Ejenie/Cheburashka/Cheburashka_construction/face/лицо/картинки/основа.png

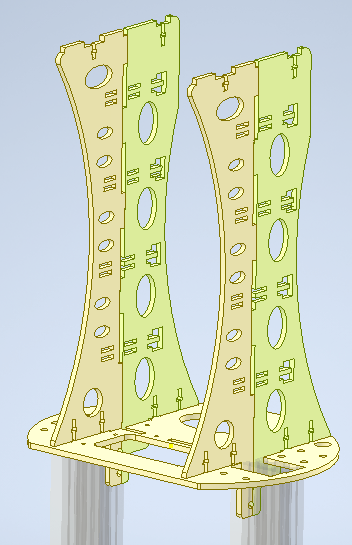
Cheburashka_construction/face/лицо/картинки/основа.png
