Ejenie/Cheburashka/README.md

# Cheburashka
## Developed by Evgeniia Baranova
