Ejenie/Cheburashka/Cheburashka_docx/Баранова_Евгения_Михайловна_Робот_Чебурашка.pdf

Правительство Санкт-Петербурга Комитет по образованию

Государственное бюджетное образовательное учреждение

«Президентский физико-математический лицей №239»

ВСЕРОССИЙСКАЯ ОЛИМПИАДА ШКОЛЬНИКОВ

Труд (технология). Профиль “Робототехника”

ПРОЕКТ

РОБОТ ЧЕБУРАШКА

Выполнила:

Баранова Евгения,

учащаяся 9 м класса, ГБОУ лицей №533,

ОДОД ГБНОУ “Президентский ФМЛ №239”

Руководитель:

Мерзлякова Юлия Игоревна,

педагог дополнительного образования

ГБНОУ “Президентский ФМЛ №239”

Санкт-Петербург, 2025

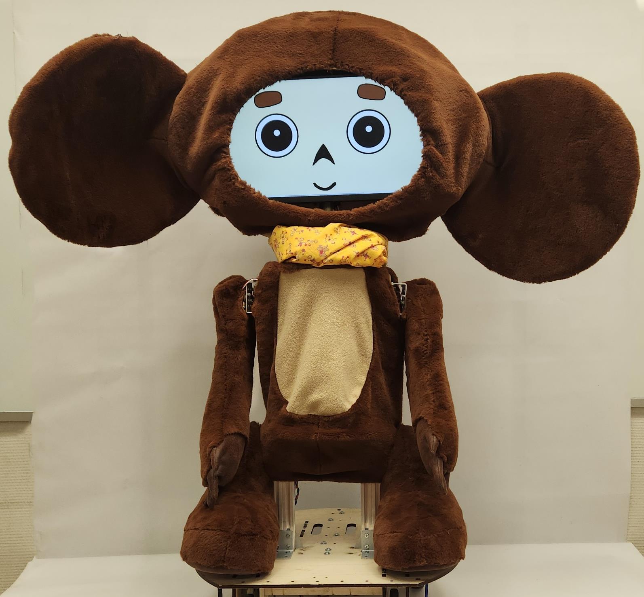
[picture p3: figure]

2

Рисунок 1 - Робот Чебурашка

3

СОДЕРЖАНИЕ

### ПРИЛОЖЕНИЕ А. КОНСТРУКТОРСКАЯ ДОКУМЕНТАЦИЯ НА

### 1 ПОИСКОВО-ИССЛЕДОВАТЕЛЬСКИЙ ЭТАП

### 1.1 Обоснование актуальности темы роботов-актеров

Роботы становятся неотъемлемыми инструментами улучшения качества жизни лю-

дей. Активно развивается и такое направление, как социальная робототехника [1]. Соци-

альные роботы способны взаимодействовать с человеком, они делятся на роботов-

ассистентов, компаньонов, актеров и др. [2].

Роботы-актеры являются актуальным и инновационным решением в мире совре-

менных развлечений. Робот, дополняющий своей ролью выступление людей-актеров, вы-

зывает интерес к постановке и привлекает внимание своей необычностью. Применение

таких технологий позволяет расширить границы искусства и показать новаторский подход

автора.

Темой роботов для сцены я занимаюсь уже третий год, и в этот раз мне стало инте-

ресно воплотить образ персонажа повести Эдуарда Успенского - Чебурашку.

Для различных развлекательных мероприятий и съемок фильмов применяются ро-

боты-аниматроники, имитирующие движения животных, персонажей литературных и

анимационных произведений [3]. Показать образ животного или фантазийного персонажа

для человека является сложной задачей, поэтому наличие роботов-актеров, выполненных

в виде сказочных героев, помогает режиссерам и постановщикам лучше показать произве-

дение на сцене и передать суть постановки.

Узнаваемый образ робота привлекает внимание зрителей разных возрастов. Это да-

ет возможность использования робота не только на сцене, но и на различных выставках,

праздниках и других развлекательных мероприятиях, что помогает решать актуальную

задачу популяризации робототехники и инженерно-технического творчества среди моло-

дежи.

Исходя из анализа развития темы роботов-актеров и роботов-аниматроников, был

сделан вывод об актуальности данной темы в современной России.

### 1.2 Цель и задачи проекта

Цель проекта стало создание робота-актера, в виде Чебурашки, который будет спосо-

бен развлекать людей, выступая на сцене. Для выполнения поставленной цели потребова-

лось выполнить следующие задачи:

1) провести предпроектное исследование: изучить аналоги роботов-актеров, аниматроников,

изучить реализации мимики человека;

2) выбрать образ, разработать концепцию, составить структурную схему робота;
3) сформулировать техническое задание для робота Чебурашки;

4) разработать все детали и сборную 3D-модель робота;
5) подобрать электронику;
6) изготовить платформу, тело и голову робота, собрать Чебурашку;
7) провести монтаж готовых электронных компонентов и изготовить самостоятельно спроек-

тированную плату;

8) разработать программное обеспечение;
9) провести тестирование робота и внести необходимые модификации.

### 1.3 Cбор и анализ информации по теме образа Чебурашки

Чебурашка – один из героев повести Эдуарда Успенского «Крокодил Гена и его

друзья», написанной в 1966 году [4]. В 1969 году вышла первая экранизация по мотивам

повести, после этого персонаж стал известен в СССР. Стали выпускаться игрушки (рису-

нок 2), значки и многое другое. Чебурашка был символом Олимпийской сборной на играх

2004, 2008, 2010 годов, а 7 июля 2016 года в честь 80-летия студии Союзмультфильм,

Чебурашка совершил полет в космос на МКС (рисунок 3) [5].

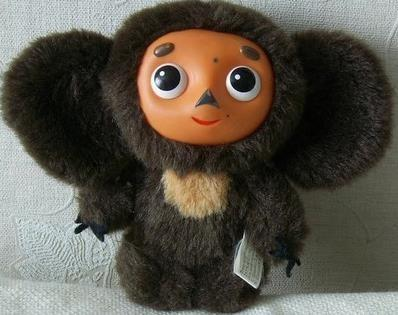
[picture p4: figure]
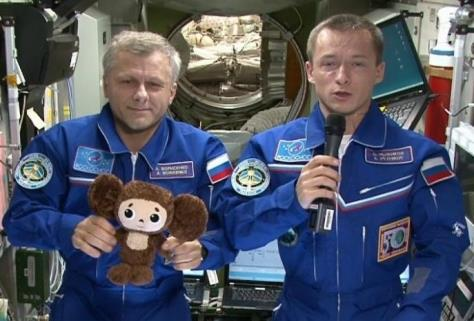
[picture p5: figure]

Рисунок 2 - Игрушка СССР | Рисунок 3 - Чебурашка на МКС

1 января 2023 года был выпущен комедийный фильм «Чебурашка», став самым кас-

совым в истории российского кинопроката, и образ Чебурашки вновь стал популярен и

является таковым до сих пор [9].

Разработка робота в виде Чебурашки является интересным опытом. Стало необхо-

димо найти способ воплотить характерные черты персонажа с помощью робототехниче-

ских технологий. Чебурашка — это персонаж, который уже давно завоевал сердца росси-

ян. Он знаком и близок людям всех возрастов, от самых маленьких до пожилых. Его образ

ассоциируется с добротой, дружбой, он вызывает доверие у взрослых и нравится детям.

В первую очередь были проанализированы мультфильмы и анимации посвященные

Чебурашке и его друзьям.

1) «Крокодил Гена», 1969, режиссер Роман Качанов [6]

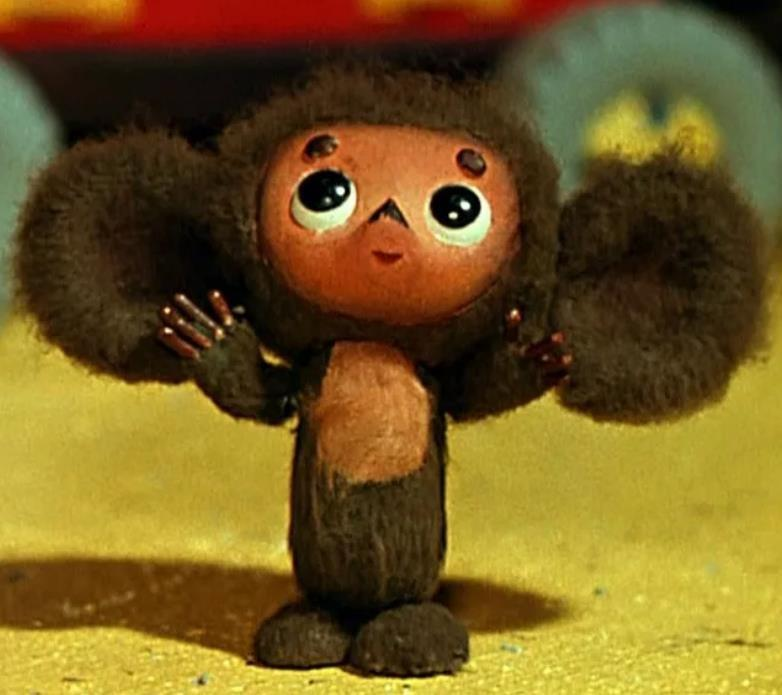
[picture p6: figure]
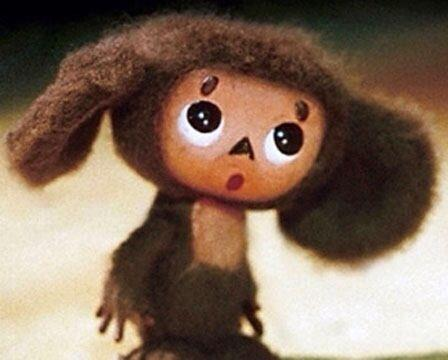
[picture p7: figure]

Рисунок 4 - Лицо Чебурашки, удивление | Рисунок 5 - Поза Чебурашки, движение
| рук

Анализ:

Форма тела (рисунок 4) продолговатое, с длинными руками, а вместо ног – только

ступни, которыми Чебурашка двигает как будто отдельно от тела. Видны движения глаз и

рук, наклон ушей и поворот головы. Мимика кукольная (рисунок 5), эмоции выражаются

за счет изменения формы рта и наклона бровей.

2) «Чебурашка», 2013, режиссер Макото Накамура [7]

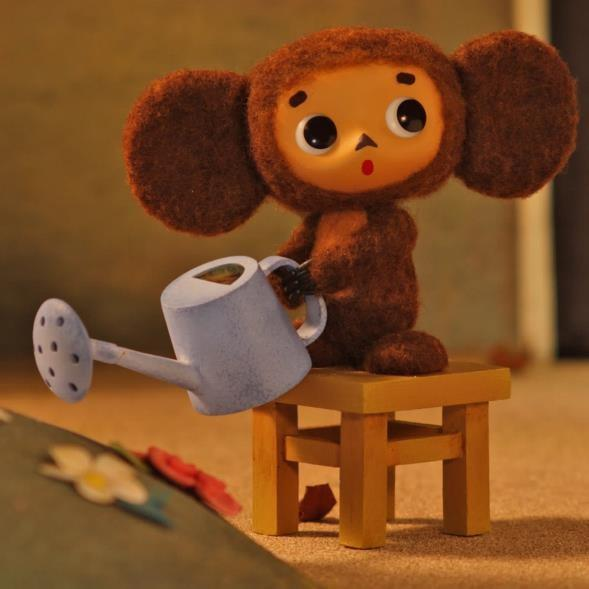
[picture p8: figure]

Рисунок 6 - Лицо Чебурашки, заинте-

ресованность

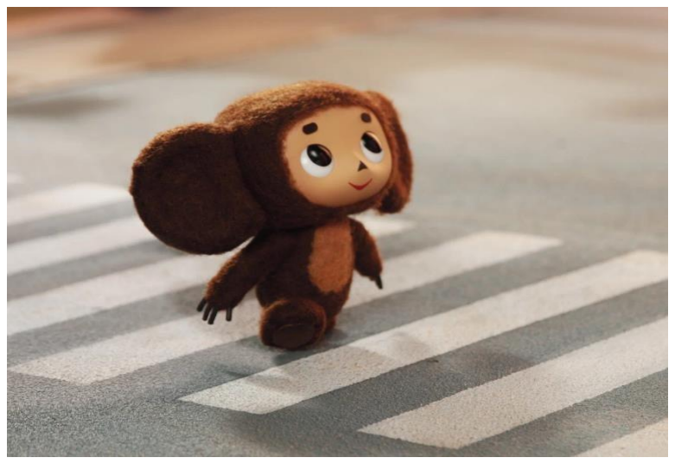
[picture p9: figure]

Рисунок 7 - Поза Чебурашки, движение ступней

Анализ:

Форма тела (рисунок 7) Чебурашки похожа на ту, что была в Советской версии мульт-

фильма. Видны движения стоп, лап в двух плоскостях. Мимика лица (рисунок 6) более ку-

кольная, не человечная, эмоции также выражаются изменением формы рта, движениями

бровей и глаз.

3) «Чебурашка», 2022, режиссер Дмитрий Дьяченко [8]

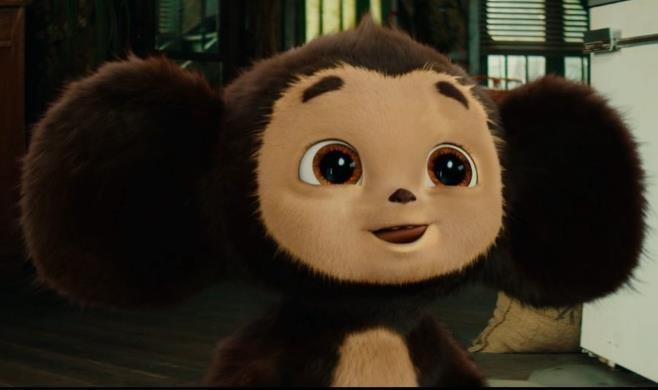
[picture p10: figure]
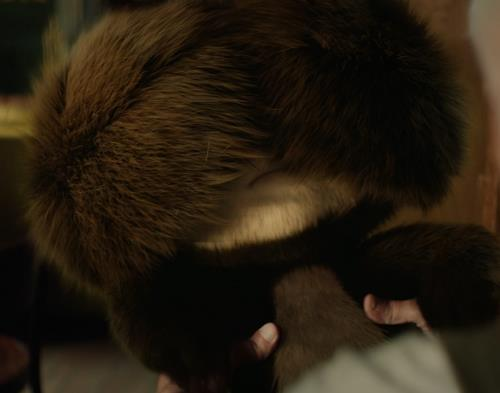
[picture p11: figure]

Рисунок 8 - Лицо Чебурашки, радость | Рисунок 9 - Поза Чебурашки. Лицо, за-
| крытое ушами

Анализ:

Пропорции тела (рисунок 8) более биоморфные: длинные нижние лапы, являющие-

ся продолжением тела, менее вытянутое туловище. Более реалистичная, практически че-

ловеческая мимика (рисунок 9), больше плоскостей движения тела, в том числе ушей: Че-

бурашка закрывает ими лицо при испуге.

По итогам анализа основных мультипликаций по повести «Крокодил Гена и его

друзья» было принято решение о реализации образа Чебурашки из более кукольного

мультфильма.

### 1.4 Аналоги

В процессе предпроектного исследования было рассмотрено несколько групп анало-

гов. Первая группа (таблица 1): аниматроники и роботы-животные, использующиеся при

съемках фильмов в качестве спецэффектов для дополнения сцен или в различных поста-

новках.

Таблица 1 - Примеры роботов аниматроников и актеров-животных

Робот | Анализ

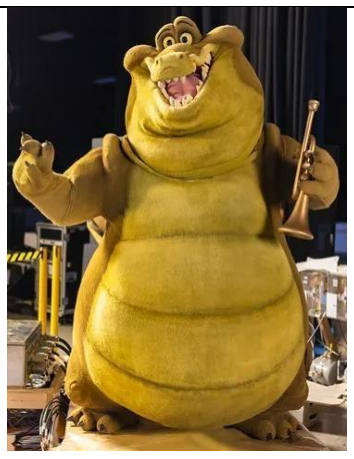
[picture p12: figure]

Рисунок 10 - Аллигатор Луи[10] | Аллигатор Луи (рисунок 10) – современная модель аниматроников, выполненных в ви-де сказочных персонажей. Этот аниматро-ник может очень многое: поворачивать гла-зами, моргать, имеет несколько степеней подвижности рук, шевелит челюстями, но при этом костюм, закрепленный поверх ос-новной конструкции, имеет свою подвиж-ность и не мешает движениям

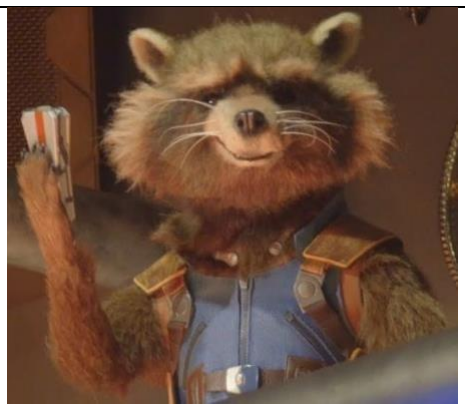
[picture p13: figure]

Рисунок 11 - Енот Ракета[16] | Аниматроник (рисунок 11) может повора-чивать голову, имитировать речь движени-ями челюсти и шевелить руками. Но ани-матроник не перемещается в пространстве, имеет статичное положение в локации комнаты

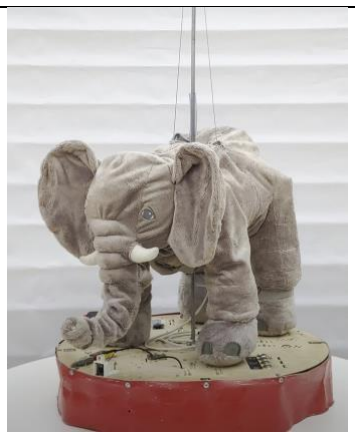
[picture p14: figure]

Рисунок 12 - Робот Слон[19] | Робот Слон (рисунок 12) умеет выполнять различные трюки, реагируя на голос чело-века и специальные метки. Каждая лапа имеет три степени подвижности, уши ше-велятся, робот целиком поднимается на подъемном механизме. Основа служит omni-платформа, позволяющая роботу пе-редвигаться в любую сторону

Вывод:

Большинство аниматроников не может перемещаться в пространстве, но имеет большой

диапазон движений различных частей тела, имитирующих движения из мультфильмов и

фильмов. Для Чебурашки, как для робота актера, необходимо перемещение по сцене, а

также повторение различных узнаваемых движений из мультипликаций

Вторая группа (таблица 2): антропоморфные роботы-актеры, артисты и промоутеры.

В свою очередь при анализе они были разделены на тех, что передают эмоции живой мими-

кой, и на тех, кто использует светодиоды и более механическую мимику.

Таблица 2 - Мимика роботов

Робот | Анализ

Более человеческая мимика

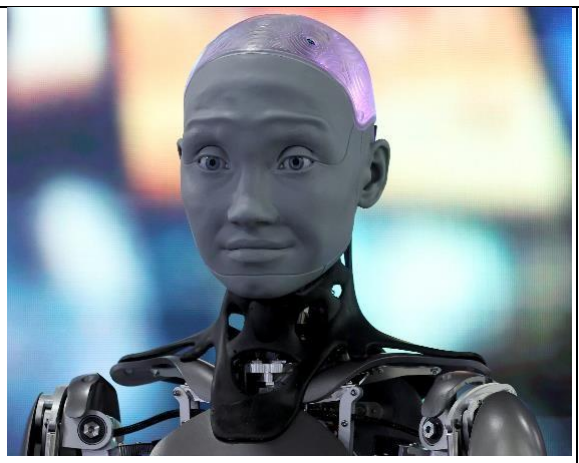
[picture p15: figure]

Рисунок 13 - Ameca [17] | Голова робота (рисунок 13) выполнена из силикона, мимика лица максимально точно повторяет человеческую, имитируя большое количество эмоций. Моторы внутри лица движениями повторяют сокращения мышц человека, реализованы движения и поворот глаз

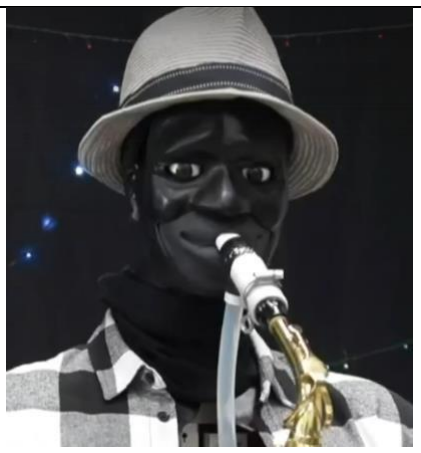
[picture p16: figure]

Рисунок 14 - Robby Brown [20] | Только передняя часть головы (рисунок 14), мимика лица передается небольшим количе-ством серво моторов, глаза могут только по-ворачиваться

Вывод:

Реализация мимики с помощью силиконовой основы позволяет добиться высокой реа-

листичности и схожести с лицом человека, но для лица Чебурашки, у которого диапазон

эмоций не такой обширный, как у человека, такая реализация будет излишней

Более механическая и не натуральная мимика

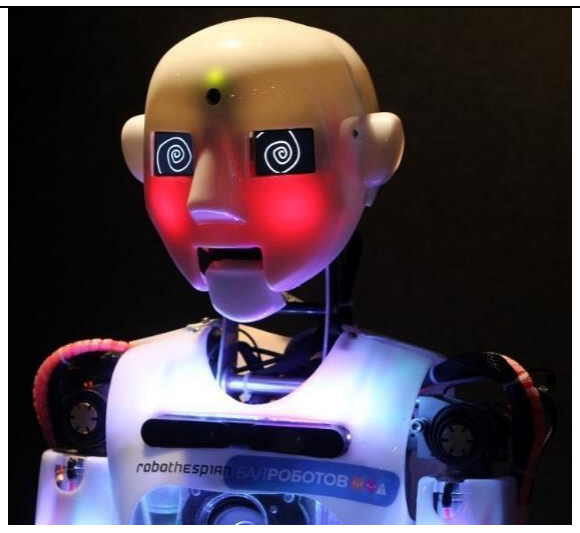
[picture p17: figure]

Рисунок 15 - Теспиан [11] | Робот Теспиан (рисунок 15) может выра-жать эмоции с помощью открытий/закрытий рта, подсветки щек, а на дисплеях, установ-ленных вместо глаз, может выводиться лю-бая картинка. Это позволяет отыгрывать эмоции менее натурально, но более нагляд-но

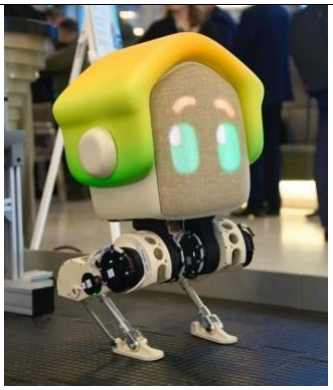
[picture p18: figure]

Рисунок 16 - Топа [18] | Лицо робота Топы (рисунок 16) выполнено в виде дисплея с натянутой поверх него тканью. На экран выводится изображение минималистичной анимированной мордоч-ки

Вывод:

Светодиоды и дисплеи позволяют роботу выражать эмоции ярче и разнообразнее, что

больше подходит для создания мимики робота, выполненного не в виде человека,

например для имитации эмоций книжного персонажа Чебурашки

В предыдущем проекте были разработаны два робота, ставших прототипами для

нынешнего проекта. Роботы Валя и Саша (рисунок 17) могут перемещаться в простран-

стве, воспроизводить заранее записанные звуковые файлы и выражать эмоции. Рот и щеки

реализованы с помощью светодиодных матриц, а глаза и брови механические.

Для взаимодействия с внешней средой у роботов предусмотрена только одна камера (ри-

сунок 18) , из-за чего возникали сложности с навигацией и позиционированием на сцене.

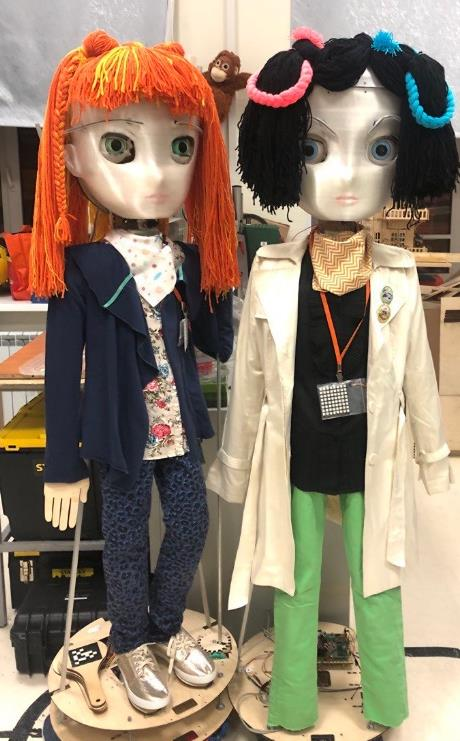
[picture p19: figure]

Рисунок 17 - Роботы Саша и Валя

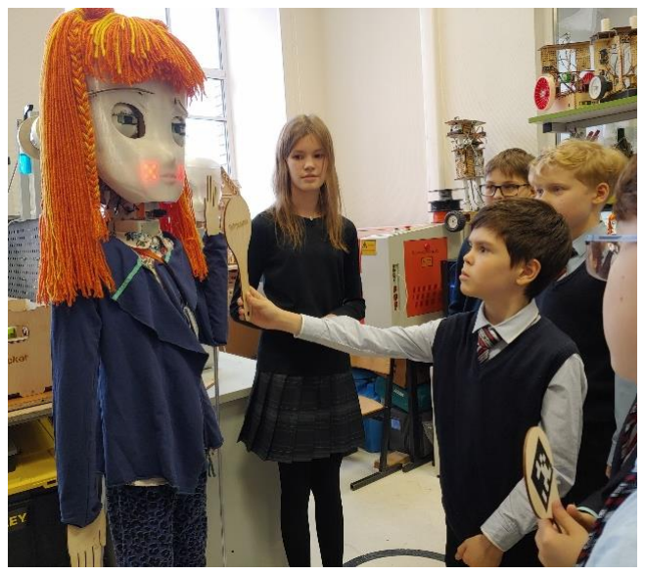
[picture p20: figure]

Рисунок 18 - Взаимодействие с окру-

жающими

По окончанию работы над прототипами было выявлено, что тема роботов-актеров

является интересной, позволяет проявить фантазию и творчество побуждает создавать но-

вых персонажей и реализовать их, используя разнообразные механизмы и электронику, для

увеличения возможности реагирования роботов на окружающую среду.

### 1.5 Концепция робота Чебурашки

На основе анализа аналогов и прототипов была разработана концепция робота Че-

бурашки.

Робот Чебурашка поход на популярную советскую игрушку, но большого размера

для того, чтобы робота-актера было хорошо видно со сцены. Это мягкая игрушка с узна-

ваемыми большими ушами, внутри которой помещены механизмы и электроника. Робот

шевелит руками, ушами и головой, изображая движения из мультфильмов. В руках нахо-

дятся магниты, позволяющие взаимодействовать с предметами на сцене. Игрушка закреп-

лена на мобильной платформе для перемещения по сцене. Шагание имитируется шевеле-

нием лап-ступней, как в известном мультфильме. Мордочка персонажа и его мимика

изображается на встроенном в голову мониторе.

Был разработан эскиз робота, на котором отмечены все ключевые решения и меха-

низмы (рисунок 19). В данном исследовании под эскизом подразумевается - предвари-

тельный, рисунок, набросок концепции будущего устройства [28].

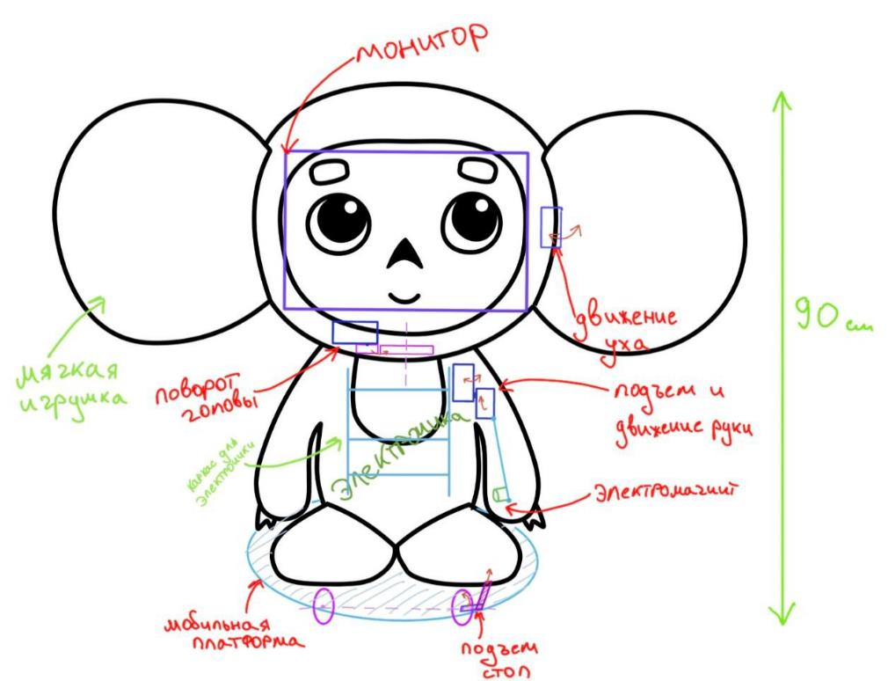
[picture p21: figure]

Рисунок 19 - Эскиз робота

По ГОСТ Р 60 робот - программируемый исполнительный механизм, обладающий

определенным уровнем автономности и предназначенный для выполнения перемещения,

манипулирования или позиционирования. Робот Чебурашка подходит под это определе-

ние, потому что содержит механизмы лап, ушей, шеи и мобильной платформы, управляе-

мые запрограммированным контроллером. Благодаря программному обеспечению робот

способен автономно перемещаться в пространстве, двигать частями тела Чебурашки и ре-

агировать на метки в окружающей среде с помощью системы технического зрения. А так-

же робот Чебурашка предназначен для перемещения на мобильной платформе и захваты-

вания объектов.

Для проекта была разработана структурная схема, в соответствии с ЕСКД. Схема

Э1 представлена в приложении А.

### 1.6 Технического задание

Основываясь на выводах концепции робота, было сформулировано следующее

техническое задание на робота:

1) робот должен состоять из мобильной платформы, соединительных конструкционных

профилей, внутреннего каркаса тела и лица, и мягкой игрушки Чебурашки высотой 900 мм;

2) робот должен не превышать размеры 480*480*1200 мм;
3) масса робота должна быть до 10 кг, должна позволять роботу развивать скорость до 1

м/с;

4) время автономной работы должно позволять роботу автономно выступать на сцене ми-

нимум 7 минут;

5) внутренний каркас тела и лица, а также платформа должны иметь вырезы и крепления

для всех электронных компонентов, быть изготовленными из фанеры и быть разборными;

6) профили, соединяющие платформу и каркас тела должны иметь размеры 20*40 мм и

находиться между нижними лапами игрушки, сохраняя их подвижность и крепиться к

платформе жестким Т-образным образом;

7) мобильная платформа должна иметь четыре колеса: два задних установлены на коллек-

торных моторах подходящей мощности оснащенных энкодерами, а два передних omni-

колеса должны быть ведомыми;

8) на осях передних колес должен располагаться кривошипно-шатунный механизм, подни-

мающий нижние лапы игрушки при передвижении робота;

9) каркас тела должен располагаться внутри туловища игрушки и иметь следующие меха-

низмы: руки должны иметь две степени подвижности, поворотный механизм головы робо-

та, способный поворачивать голову на 90 градусов в две стороны;

10) в теле робота должен располагаться датчик гироскоп;
11) все механизмы должны быть сделаны на основе сервоприводов с подходящим момен-

том силы;

12) в голове должен располагаться дисплей для имитации лица Чебурашки и отладки;
13) на голове должны располагаться уши, поворачивающиеся с помощью сервомоторов;
14) на платформе робота и в голове должны располагаться камеры, способные распознавать

цвета, метки и лица людей;

15) в руках робота должны располагаться электромагниты размерами не более 20*20*15

мм;

16) электромагниты должны удерживать массу до 2.5 кг;
17) робот должен уметь воспроизводить заранее записанные звуковые файлы с помощью

колонки размерами не более 130*100*50 мм;

18) громкость колонки должна быть не менее 105 децибел;
19) вся периферия робота должна управляться контроллером Arduino Mega, а обработка

изображений с камер и передача действий сценария должны управляться с одноплатного

компьютера Raspberry Pi 4 model B;

20) программное обеспечение должно состоять из двух программ: первой для одноплатного

компьютера Raspberry Pi 4, а второй для контроллера Arduino Mega, должна быть обеспече-

на связь между устройствами по протоколу UART.

### 2 КОНСТРУКТОРСКО-ТЕХНОЛОГИЧЕСКИЙЭТАП

### 2.1 Подбор материалов и проектирование конструкции робота

Проектирование производилось в САПРе Autodesk Inventor. Этот САПР был выбран

из-за продвинутой работы с мультителами и поверхностями и за счет технологий адап-

тивного моделирования.

Первый этап в разработки конструкции робота - сделать мобильную платформу. В

соответствии с технический заданием, платформа должна обладать четырьмя колесами:

двумя omni и двумя обычными. Снизу фанерной основы (рисунок 20) находятся крепле-

ния моторов Tetrix, а сверху (рисунок 21) – крепление для камеры.

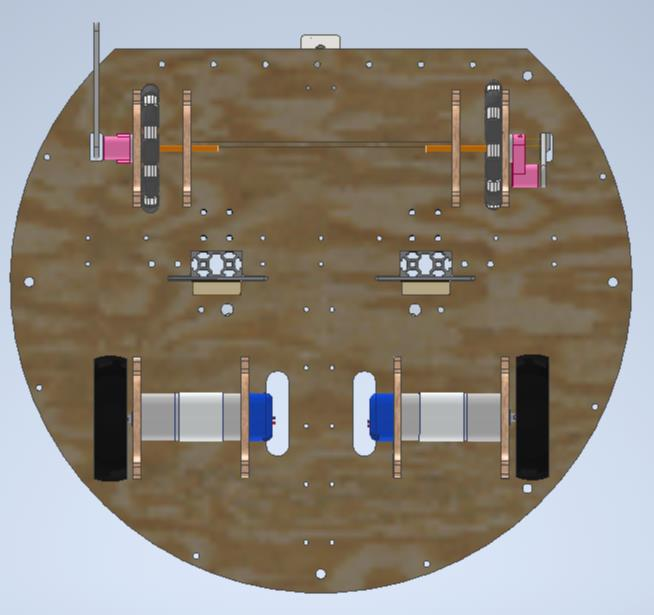
[picture p22: figure]

Рисунок 20 - Фанерное основание.

Вид снизу

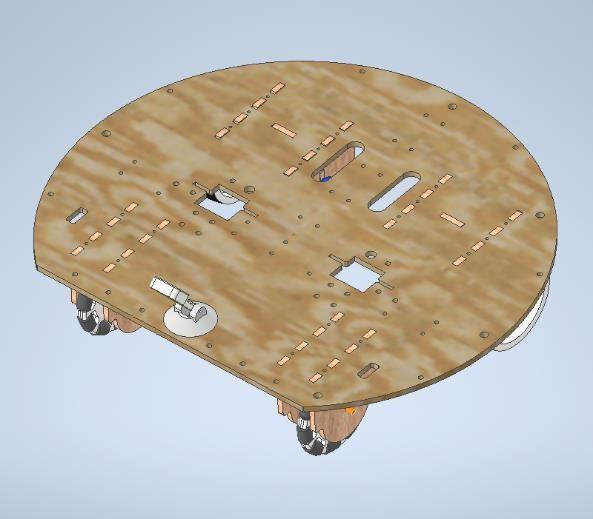
[picture p23: figure]

Рисунок 21 - Фанерное основание. Вид

сверху

Для имитации роботом движения стоп на осях omni-колес (рисунок 22) находятся

два кривошипно-шатунных механизма с наконечниками округлой формы (рисунок 23),

которые толкают стопы игрушки Чебурашки.

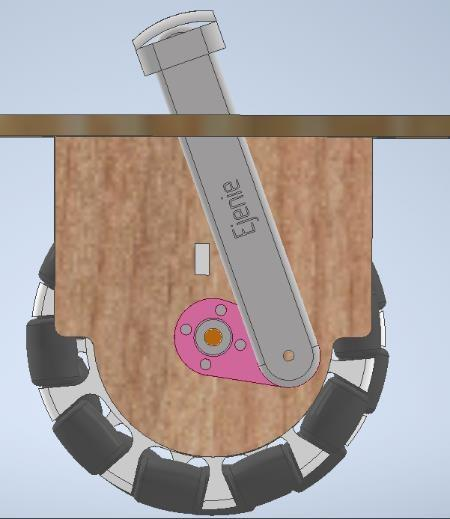
[picture p24: figure]

Рисунок 22 - Механизм стоп. Вид

сбоку

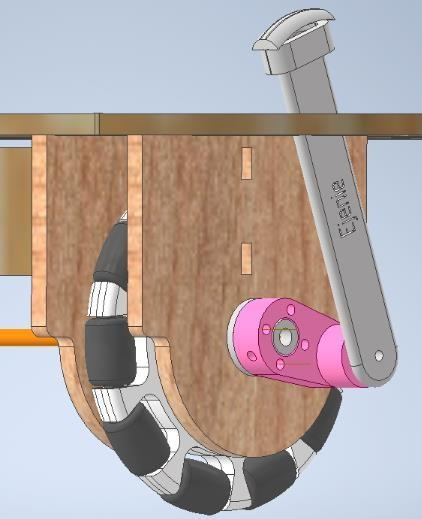
[picture p25: figure]

Рисунок 23 - Механизм стоп. Вид на

ось

Для детали, использующейся в механизме, был разработан чертеж, представленный

в приложении А.

Для соединения отдельных модулей, таких как платформа и тело, было принято

решение использовать алюминиевые конструкционные профили. Их Т-образное (рису-

нок 24) крепление на платформе обеспечивает жесткую фиксацию тела относительно

платформы робота. Профиль крепится на платформу с помощью алюминиевых уголков и

пластин (рисунок 25).

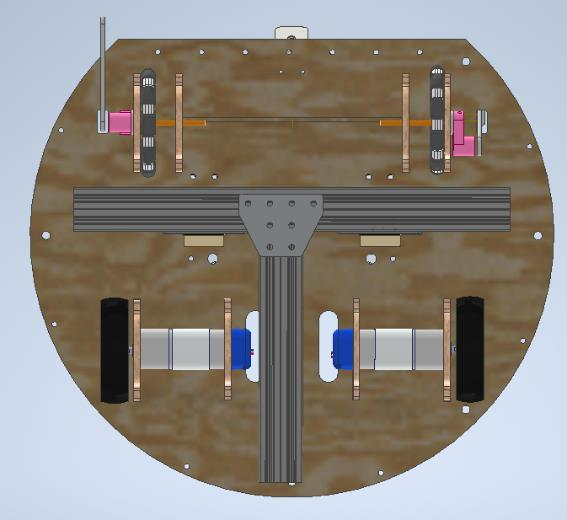
[picture p26: figure]
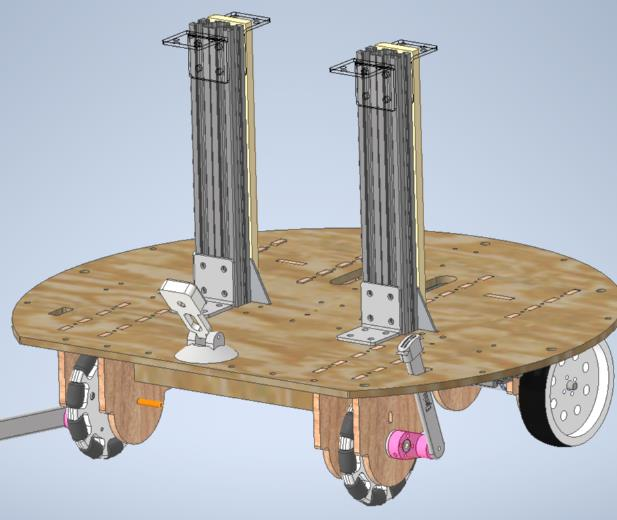
[picture p27: figure]

Рисунок 24 - Т-образное крепление | Рисунок 25 - Крепление профилей к плат-
| форме

Вся управляющая электроника крепится на каркас в теле робота. В процессе про-

ектирования робота потребовалось решить определенную проблему: расположить элек-

тронику доступно для подключения, с возможностью отсоединения для перевозок и ре-

монта. Была разработана конструкция с четырьмя опорными пластинами, скрепляющиеся

друг с другом шип-пазами (рисунок 26). Снизу пластины закреплены на усеченное круглое

основание, под которым находится крепление аккумулятора крепление к конструкцион-

ным профилям каркаса (рисунок 28). На основании сделаны прорези, для удобства заме-

ны и доступа к индикатору заряда аккумулятора.

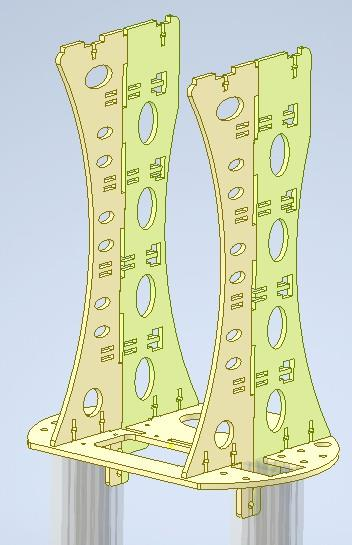
[picture p28: figure]

Рисунок 26 – Опорные пластины

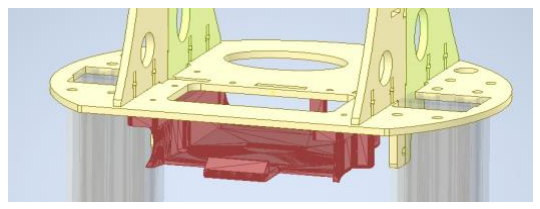
[picture p29: figure]

Рисунок 27 - Крепление аккумулятора

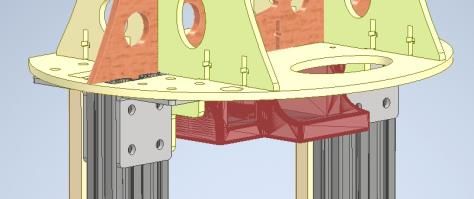
[picture p30: figure]

Рисунок 28 - Крепление к каркасу

Между парами опор, поперечно к ним, расположено скрепляющее их шип- пазами

ребро (рисунок 29), с прорезями для отсеков с компонентами, отверстиям для разъемов, а

также крепления двухосевых серво-моторов рук (рисунок 30).

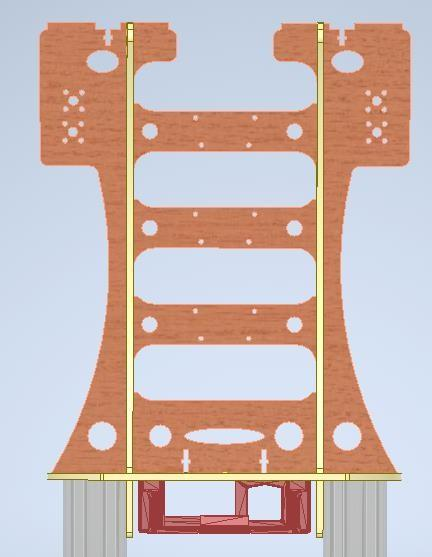
[picture p31: figure]

Рисунок 29 - Поперечное ребро с

прорезями

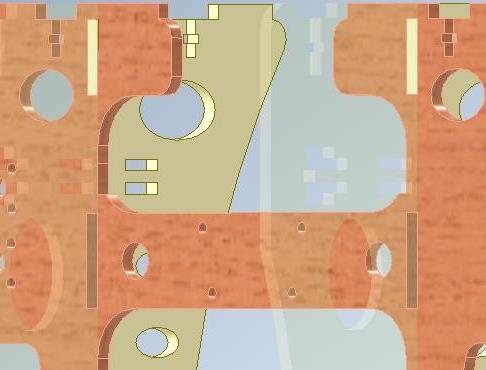
[picture p32: figure]

Рисунок 30 - Крепление опор шип- пазами

Отсеки созданы на подобие выдвигающимся полкам шкафа или стеллажа: основами

полок служат пластины (рисунок 31), способные скользить по направляющим (рису-

нок 34), прикрепленным к боковым опорам клиновым соединением. С одного конца

направляющих есть ограничители (рисунок 33), поставленные для предотвращения вы-

падения пластин. Была сделана полная сборная 3D-модель каркаса тела робота, включа-

ющая электронные компоненты необходимые для создания крепежных отверстий (рису-

нок 32).

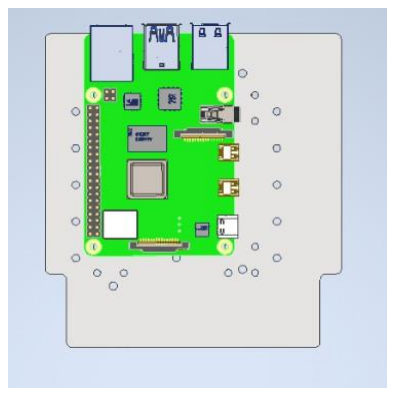
[picture p33: figure]

Рисунок 31 - Пластины для крепления

электроники

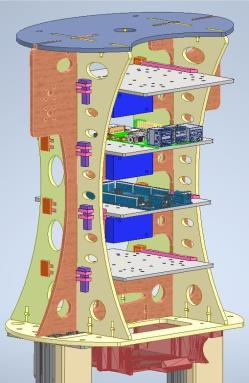
[picture p34: figure]

Рисунок 32 - Сборная 3D-модель

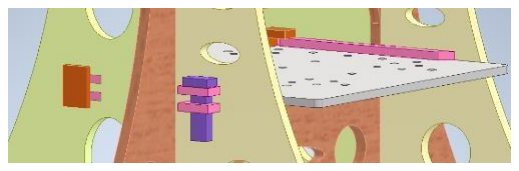
[picture p35: figure]

Рисунок 33 - Клиновое соединение и огра-

ничители

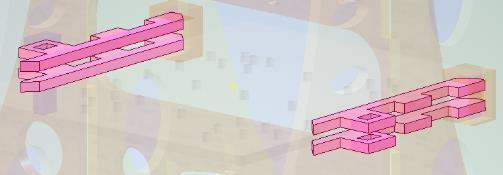
[picture p36: figure]

Рисунок 34 - Направляющие полок

Поворотный механизм головы (рисунок 35) основан на шестерне, закрепленной на

верхнем фанерном основании туловища. На шестерню крепится деталь, фиксирующая

подшипник, на котором производится вращение фанерной основы головы, осуществляемое

с помощью сервомотора в голове с закрепленной на него шестерней (рисунок 36). Для

большей устойчивости, по бокам от подшипника установлены детали, обеспечивающие до-

полнительную опору. Для скольжения основы при повороте в опорах находятся подшипни-

ки.

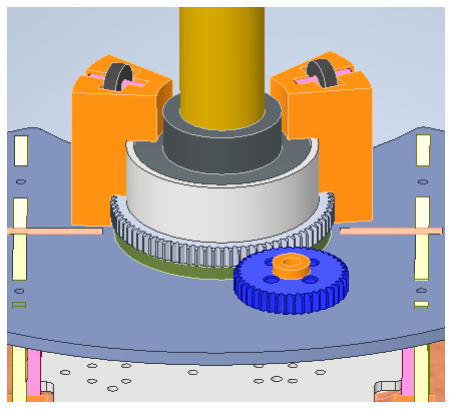
[picture p37: figure]
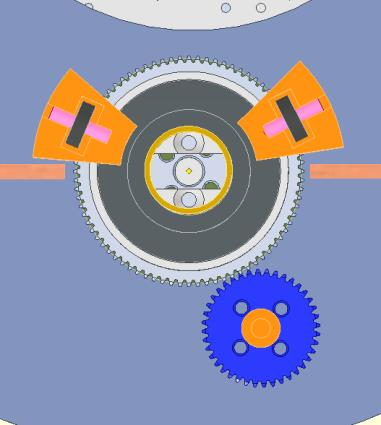
[picture p38: figure]

Рисунок 35 - Поворотный механизм | Рисунок 36 – Зацепление шестерней

Фанерное основание лица (рисунок 37) представляет собой две пластины, с отвер-

стиями под крепление трубы и сервомоторов ушей. Монитор для изображения эмоций за-

крепляется на основу на магниты, расположенные в стойках (рисунок 38).

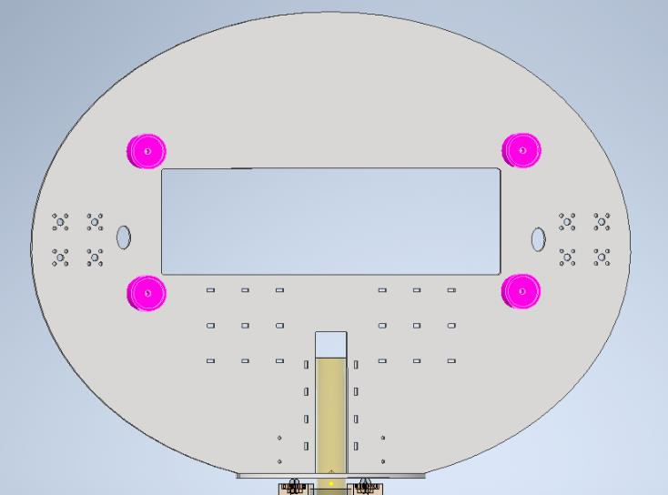
[picture p39: figure]

Рисунок 37 - Основание лица

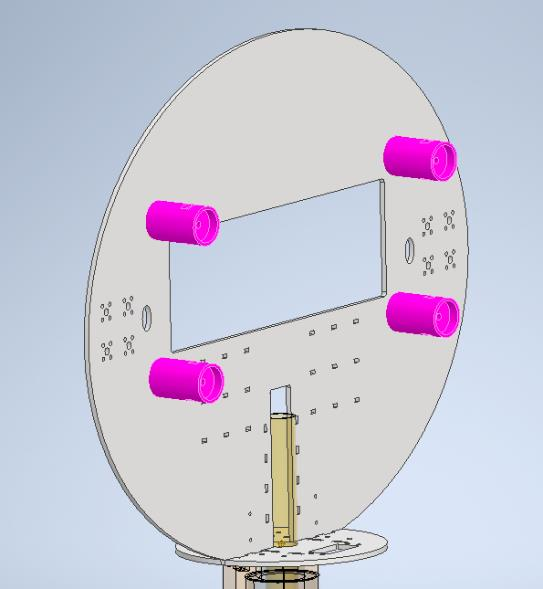
[picture p40: figure]

Рисунок 38 - Стойки с магнитами

### 2.2 Подбор электроники робота Чебурашки

В процессе подбора компонентов потребовалось рассчитать общий потребляе-

мый ток и мощность, на основе данных из технических документаций на компоненты (таб-

лица 3).

Таблица 3 - Расчет токов

| Рабочее напряжение, В | Потребляемый ток, А | Потребляемая мощность на 1 шт., Вт | Кол-во | Суммарная мощность, Вт
| Min | Max | Ном. | Max | Ном. | Max | | Ном. | Max
Arduino Mega | 5,00 | | 0,10 | 0,20 | 0,50 | 1,00 | 1,00 | 0,50 | 1,00
Raspberry Pi 4 | 5,00 | | 2,00 | 3,00 | 10,00 | 15,00 | 1,00 | 10,00 | 15,00
Motor Tetrix Max | 5,00 | 12,00 | 3,00 | 8,70 | 15,00 | 104,40 | 2,00 | 30,00 | 208,80
DS3240 | 5,00 | 6,80 | 3,10 | 3,90 | 15,50 | 26,52 | 1,00 | 15,50 | 26,52
RDS3218 | 4,80 | 6,80 | 1,00 | 2,00 | 4,80 | 13,60 | 6,00 | 28,80 | 81,60
Магниты | 14,80 | | 0,27 | | 4,00 | | 2 | 8,00
Сумма | - | - | 9,47 | 18,07 | 49,80 | 164,52 | 11,00 | 92,80 | 340,92

На основе расчета, был произведен окончательный подбор электроники, были проана-

лизированы и выбраны следующие электронные компоненты (таблица 4).

На основе расчётов потребляемых токов, время автономной работы робота было

рассчитано по формуле (1):

t =

C×U
P

(1)

Где t – время работы робота, С – емкость аккумулятора (3000 мА*ч), U – напряже-

ние питания (14,8 В) и P – потребляемая роботом мощность (92,80 для максимального вре-

мени и 340,92 для минимального времени).

tmax =

C × U
P

=

(3000 мА ∗ ч ÷ 1000 ∗ 60) × 14,8 В
92,80 Вт | ≈ 28,7 мин

tmin =

C × U
P

=

(3000 мА ∗ ч ÷ 1000 ∗ 60) × 14,8 В
340,92 Вт | ≈ 7,8 мин

Итого, минимальное время работы робота составляет 7,8 мин, а максимальное – 28,7

мин.

Таблица 4 - Обоснование выбора электронных компонентов

Название и характеристики | Обоснование выбора

Контроллеры

Arduino Mega [12]. 1 шт. Подклю-

чение периферии робота.

Для выбора контроллера был произведен расчет не-

обходимого количество портов и интерфейсов, нуж-

43 цифровых порта

14 ШИМ портов

16 портов с АЦП

4 интерфейсов UART

1 интерфейс I2C

6 внешних прерываний

ных для подключения устройств:

1. 2 интерфейса UART (для подключения по USB и

передачи данных с Raspberry)

2. 1 интерфейс I2C (для подключения гироскопа)
3. 9 ШИМ портов (для подключения сервоприводов и

драйвера)

4. 6 цифровых пинов (подключение энкодеров и

драйверов)

5. 2 пина внешних прерываний

На основе данного анализа был выбран контроллер

Arduino Mega, а также за счет поддержки среды раз-

работки Arduino IDE

Raspberry Pi 4 model B [15]. 1 шт.

Обработка информации с датчиков.

Bluetooth модуль

Возможность | подключения | не-

скольких камер одновременно

Аналоговый аудиовыход

USB порты

1. 5 портов UART
2. HDMI порт

Raspberry Pi это одноплатный компьютер, с возмож-

ностью работы с видео, звуком, обрабатывать ком-

пьютерное зрение. Есть возможность обрабатывать

несколько задач одновременно и использовать раз-

личные языки программирования. Также по этому од-

ноплатному компьютеру существует большое количе-

ство открытых обучающих материалов

Электродвигатели

Motor Tetrix Max Torque NADO [13].

2 шт.

100 об/мин

~50 кгс/см

1440 отсчетов энкодера

3 А номинальный ток

8,7 А максимальный ток

Мотор своими характеристиками подходит для со-

здания колесной базы, способной выдерживать вес

робота

Платы управления двигателями

Pololu motors driver VNH5019A [21].

1 шт.

Выходной ток 12 А на каждый ка-

Данный драйвер обеспечивает выходной ток в 12 А,

что подходит для управления моторами, используе-

мых в проекте, а также с его помощью можно

нал

Два канала управления

управлять двумя моторами сразу

Сервоприводы

DS3240 [14]. 1 шт. 40 кгс*см 40*20*40.5 мм 270 градусов | Сервоприводы имеют достаточный крутящий момент для управления поворотом головы робота
RDS3218 [22]. 6 шт. 20 кгс*см 40*20*40.5 мм 360 градусов | Сервоприводы имеют достаточный крутящий момент для управления движениями рук робота, а также наличие совместимый алюминиевый держатель

Камеры

Raspberry Pi Camera module [23]. 1 шт. | Камера выбрана из-за совместимости с микрокомпью-тером Raspberry Pi и за счет наличия готовых библио-тек обработки и управления
Web-камера [27]. 1 шт. | Выбрана за счет своего подключения по интерфейсу USB, так как к одноплатному компьютеру Raspberry Pi 4 одна возможность подключения камеры по ин-терфейсу SPI

Прочие электронные компоненты

JBL clip +[24]. 1 шт. | Колонка была выбрана засчет небольших размеров и выдаваемой громкости, соответствующей техниче-скому заданию
Портативный монитор 17.3 дюйма [25]. 1 шт. | Монитор выбран за счет подходящих к лицу Чебу-рашки размеров и за возможность подключения по интерфейсу HDMI, совместимым с Raspberry Pi 4
Электромагниты 14.8 вольт 270 мА | Магниты были выбраны засчет подходящих размеров и выдерживаемой массы
LM2596 Входное напряжение от 4 до 40 В | Данный DC-DC преобразователь обеспечивает пони-жение напряжение выдаваемого с аккумулятора 14,8

Выходное напряжение от 1,5 до 35 В Максимальный выходной ток 3 A | вольт, до напряжения питания контроллера Arduino Mega - 5 В
Регулируемый понижающий DC-DC Входное напряжение от 4,5 до 30 В Выходное напряжение от 0,8 до 28 В Максимальный выходной ток 12 А | На основе расчета токов и требуемого напряжения, потребляемых сервомоторами, был выбран данный стабилизатор.

Аккумулятор

Li-on аккумулятор КРАВТ. 1

шт.

14.8 В

3000 mAh

43 Вт*ч

Аккумулятор КРАВТ имеет защиту отполного разря-

да и перезаряда ячеек, защиту от перегрузки и корот-

кого замыкания на выходе. Имеет удобную индика-

цию показывающую степень заряда аккумулятора и

предупреждение о низком заряде, а также подходит

своей емкостью для 7 минутной автономной работы

робота, требующейся по техническому заданию

### 2.3 Проектирование печатной платы для робота

Для обеспечения питания микрокомпьютера Raspberry Pi 4 было принято решение о

создании собственного преобразователя питания на печатной плате. За основу была взята

микросхема стабилизатора питания LM2596. Были реализованы схемы защит по превыше-

нию силы тока и напряжения на выходе стабилизатора. Также на печатной плате реализо-

вана схема, позволяющая управлять напряжением электромагнитов с помощью цифрового

сигнала с Arduino Mega.

Схема Э3 платы представлена в приложении А.

В качестве САПР был выбран Altium Designer, за счет возможности создавать печат-

ные платы на основе схем по ГОСТ, механик трассировки, не позволяющих допустить пе-

ресечения дорожек, и возможности задания правил трассировки с необходимыми зазорами

между дорожками.

### 2.4 Изготовление робота

Большинство деталей робота были изготовлены методами лазерной резки из фа-

неры. Такой способ изготовления позволяет создавать легкие сборные каркасы, быстро и

точно корректировать несовершенства модели.

Часть спроектированных деталей была напечатана на 3D принтере, с использова-

нием пластиков PLA и ABS. Такие виды пластиков были выбраны засчет своей легкости,

прочности и доступности в рамках школьного проекта.

Основание робота и крепления моторов (рисунок 39) были вырезаны из фанеры 6

мм на лазерном станке. Для обеспечения быстрой сборки робота, провода питания мото-

ров и связи энкодеров являются разъединяемыми и, с одной стороны, припаяны к разъ-

ему кабель-канала (рисунок 40).

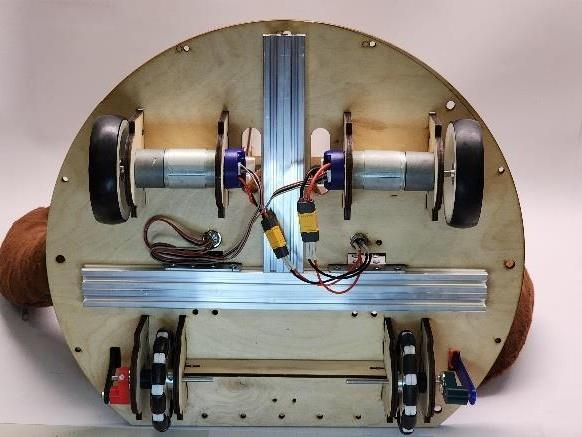
[picture p41: figure]
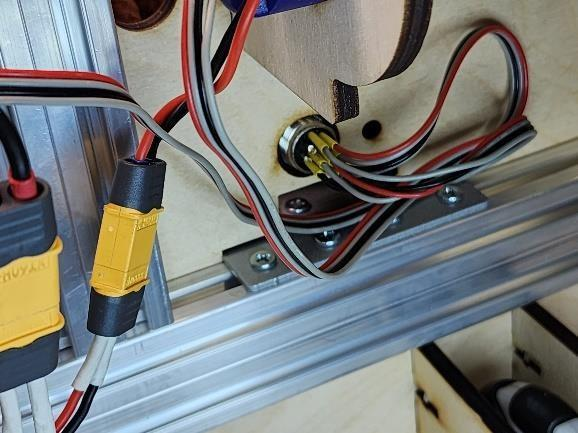
[picture p42: figure]

Рисунок 39 - Основание робота | Рисунок 40 - Разъем кабель- канала

Детали для механизма стоп (рисунок 41), клиновые соединения, ограничители по-

лок (рисунок 42) были напечатаны на 3D принтере из пластика PLA.

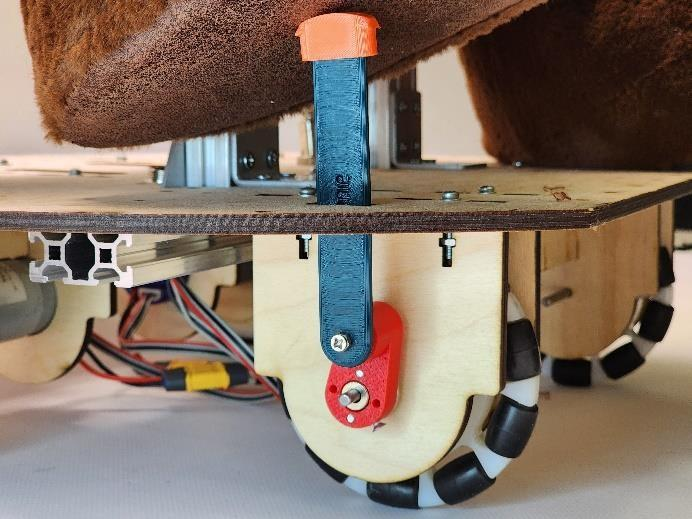
[picture p43: figure]
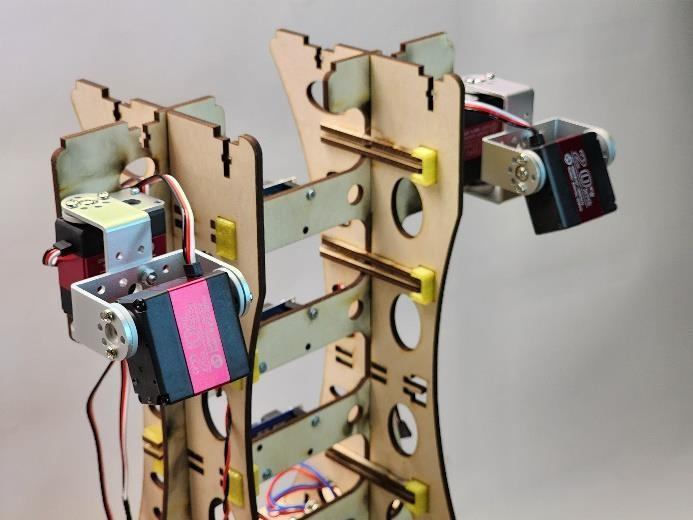
[picture p44: figure]

Рисунок 41 - Механизм стоп | Рисунок 42 - Каркас тела робота

Сборка конструкции (рисунок 43) и монтаж электронных компонентов (рисунок

44) производился вручную.

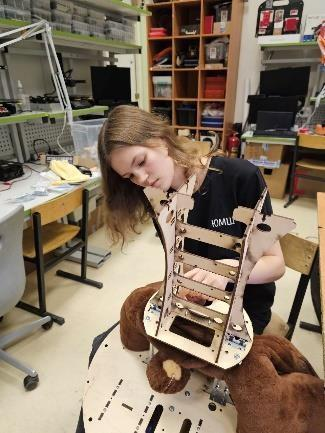
[picture p45: figure]
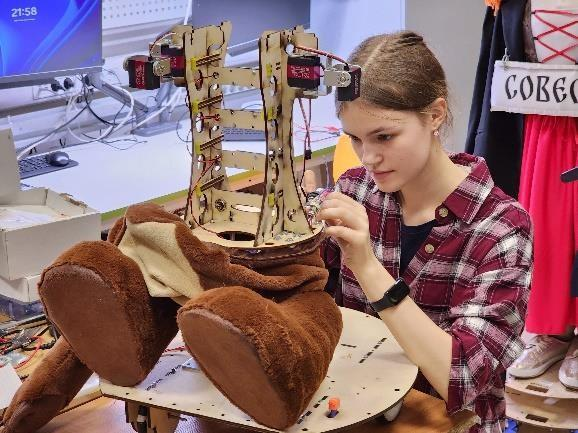
[picture p46: figure]

Рисунок 43 - Сборка робота | Рисунок 44 - Монтаж компонентов

Изготовление печатной платы производилось методом фотолитографии (рисунок 45)

с травлением в растворе пероксида водорода с кальцинированной содой, солью и лимонной

кислотой (рисунок 46). Далее электронные компоненты напаяны вручную.

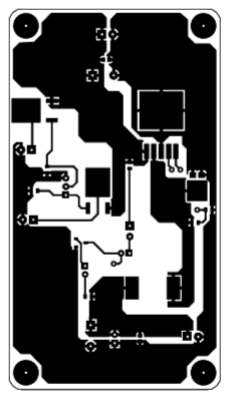
[picture p47: figure]

Рисунок 45 - Фотошаблон для засвечивания

платы

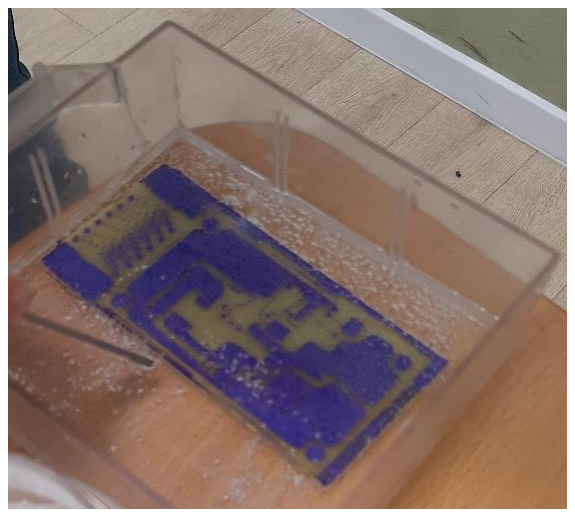
[picture p48: figure]

Рисунок 46 - Травление платы

### 2.5 Разработка программного обеспечения робота

Для проекта было разработано программное обеспечение, состоящее из двух про-

грамм.

В первом коде для одноплатного компьютера Raspberry Pi осуществляется обра-

ботка значений с двух камер с помощью библиотеки OpenCV на языке Python. Камерой,

расположенной на платформе, робот способен обнаруживать цветные метки, а камерой

сверху - ArUco маркеры и лица людей, которые выявляются признаками Хаара [29]. В

зависимости от полученных с камеры значений на контроллер Arduino Mega, по прото-

колу UART, отправляется код нужного по сценарию состояния робота. Для исключения

неточности передачи данных сообщение, отправляемое между контроллерами, составля-

ется по шаблону: первым отправляется известная последовательность стартовых битов,

после этого битовое значение состояния, после этого – проверочный финишный бит.

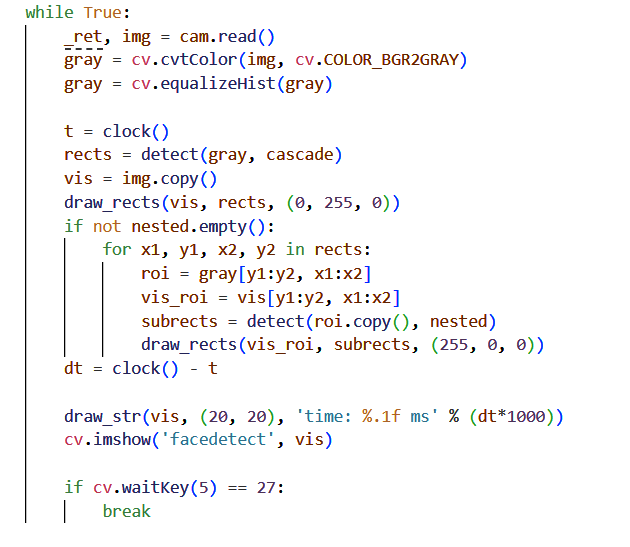
[picture p49: figure]

Рисунок 47 - Фрагмент кода Raspberry

Второй код, написанный для контроллера Arduino Mega в среде Arduino IDE,

управляет всеми периферийными устройствами робота, в зависимости от состояния по

сценарию.

Управление платформой происходит с помощью показаний энкодеров двух мото-

ров. Для синхронизированного движения по прямой (представленный фрагмент кода) ис-

пользуется ПИД-регулятор. Также обеспечивается плавный разгон первую половину пути

робота и плавное торможение на второй половине дистанции. Значение пути задается в

функцию проезда в метрах, далее преобразуется в отсчеты энкодера и используется в ре-

гуляторе как желаемое значение.

1. void forwardEnc(int16_t dist = 1, int velMx = 40, float kp = 10, float kd = 1, float ki = 0.001, float kv = 0.1) {
2. | zeroEnc(); | //обнуление энкодеров
3. | dist = (len_to_pulses(dist)); | //перевод расстояния в метрах
в отсчеты энкодера
4. int16_t encLReg = encL, encRReg = encR, errOldEnc = 0, errEnc = 0, dEnc = 0, iEnc = 0, vel = 0;
5. float u = 0, kpReg = 0, kdReg = 0, kiReg = 0;
6. velMx = abs(velMx);
7.
8. while ((encLReg + encRReg) < abs(dist) * 2) {
10. encLReg = abs(encL);
11. encRReg = abs(encR);

12. if ((encLReg + encRReg) < abs(dist)) vel = (encLReg + encRReg) / 2; else vel = abs(dist) - (encLReg + encRReg) / 2; //расчет скорости для регулировки ускорения/замедления робота
13. vel = float(vel) * kv + 20;
14. | if (vel > velMx) vel = velMx; | //ограничение диапазона скоро-
сти
15. kpReg = float(kp * vel) / 100.0;
16. errEnc = (encRReg - encLReg);
17. iEnc += errEnc;
18. if (sgn(errOldEnc) != sgn(errEnc)) iEnc = 0;
19. u = float(errEnc) * kpReg + dEnc * kdReg + float(iEnc) * kiReg;
20. errOldEnc = errEnc;
21. rotateLeft(sgn(dist) * (vel - u));
22. rotateRight(sgn(dist) * (vel + u));
23. }
24. }

Для управления поворотами робота также используется ПИД-регулятор синхро-

низации моторов, а желаемым значением является диапазон значений энкодеров и угол

поворота робота по гироскопу. Для передачи данных по протоколу I2C с датчика на ро-

бота используется библиотека Wire.

Структура программ, написанных для робота, представляет собой конечный авто-

мат, где управляющие события — это приход данных с камер, а состояния — это дей-

ствия робота.

Блок-схема алгоритма работы робота представлена в приложении А.

| 2.6 Отладка, тестирование и модификации

В таблице 5 представлен график работы над проектом.

Таблица 5- Разработка и модификации проекта

Месяц, год | Разработки | Модификации
Октябрь, 2024 | Произведено исследование по теме Чебурашки, разработана концепция робота
Ноябрь, 2024 | Составлено техническое зада-ние, разработка 3D- модели мо-бильной платформы робота. Разработана структурная схема Э1
Декабрь, 2024 | Подбор электроники для робота, разработка механизмов плат- | Был изменен механизм дви-жения стоп. Вместо реализа-

| формы | ции кулачкового механизма на отдельном моторе, был сделан ведомый кривошип-но- шатунный механизм на основе оси колес
Январь, 2025 | Произведена сборка платформы робота вместе с электроникой, начата разработка и изготовле-ние моделей тела и лица робота. | Было принято решение из-менить реализацию мимики лица. Была изменена сборка кон-струкции рук. Вместо расположения управляющей электроники вертикально на фанере при-думана конструкция “стел-лаж”.
Февраль, 2025 | Разработка и сборка головы ро-

бота, написание программного

обеспечения

При тестировании поворот-

ного механизма были выяв-

лены крупные недостатки:

голова сильно качалась, а

шестеренки выходили из за-

цепления. Также при тести-

ровании произошел скачок

напряжения | на | покупном

стабилизаторе, отвечающем

за питание микрокомпьюте-

ра, из-за чего тот сгорел. В

связи с этим было принято

решение о разработке соб-

ственной | печатной | платы
преобразования | тока | и

напряжения

### 3 ЗАКЛЮЧИТЕЛЬНЫЙ ЭТАП

### 3.1 Результат

В результате у меня получилось создать робота-актера, виде Чебурашки, который

способен развлекать людей, выступая на сцене, а именно:

1) передвигаться по ровной поверхности;
2) двигать руками и ушами;
3) воспроизводить заранее записанные звуковые файлы;
4) воспроизводить выражение лица на дисплее;
5) распознавать цветные метки, ArUco маркеры и лица людей.

Ссылка на репозиторий с файлами проекта https://github.com/Ejenie/Cheburashka (рисунок

48)

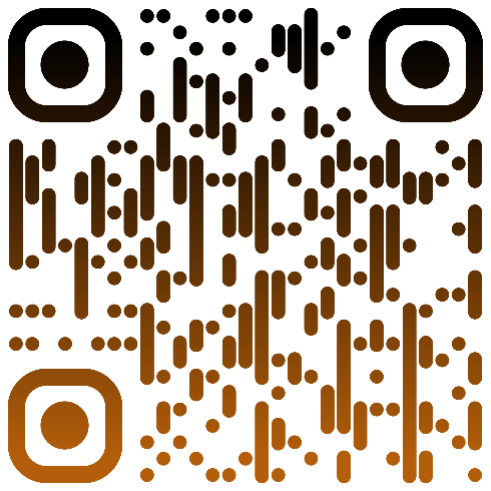
[picture p50: figure]

Рисунок 48 - Репозиторий проекта

### 3.2 Практическая значимость

Такой робот может применяться на различных развлекательных мероприятиях:

1) быть роботом-актером в постановках по мотивам повести «Крокодил Гена и его друзья»

в детских театрах;

2) использоваться на выставках роботов, музеях увлекательной науки, парках развлечений

для популяризации робототехники;

3) на детских образовательных мероприятиях, например, соревнованиях по робототехнике

или фестивалях.

### 3.3 Новизна и креативность

Креативными решениями, использовавшимися в роботе Чебурашке, можно

назвать:

1) конструкторское решение в виде модульных легкосъемных отсеков с электронными

компонентами;

2) кривошипно-шатунный механизм движения стоп;
3) использование собственной платы преобразования питания.

Новизной является сама реализация кукольного образа Чебурашки в виде робота.

### 4 СПИСОК ИСПОЛЬЗОВАННЫХ ИСТОЧНИКОВ

1 Социальная робототехника https://www.isras.ru/Davydov_Robotics.html?printmode

[Электронный ресурс] Дата обращения: 20.01.25

2 Н.Н. Зильберман Функциональная классификация социальных роботов [Электрон-

ный ресурс] Дата обращения: 20.01.25

3 Использование аниматроников в кино https://www.techinsider.ru/design/241302-

animatronika-zhivye-golovy-i- (https://www.techinsider.ru/design/241302-animatronika-zhivye-golovy-i-)nastoyashchie-dinozavry-v-kino/ (https://www.techinsider.ru/design/241302-animatronika-zhivye-golovy-i-nastoyashchie-dinozavry-v-kino/) [Электронный ресурс] Дата об-

ращения: 20.01.25

4 Крокодил Гена и его друзья https://azbyka.ru/fiction/krokodil-gena-i-ego- druzja-

jeduard-uspenskij/ (https://azbyka.ru/fiction/krokodil-gena-i-ego-druzja-jeduard-uspenskij/) [Электронный ресурс] Дата обращения: 20.02.25

5 Полет Чебурашки на МКС https://rg.ru/2016/07/06/cheburashka- (https://rg.ru/2016/07/06/cheburashka-otpravitsia-v-kosmos.html) otpravitsia-v-

kosmos.html (https://rg.ru/2016/07/06/cheburashka-otpravitsia-v-kosmos.html) [Электронный ресурс] Дата обращения: 20.01.25

6 «Крокодил Гена» мультфильм, 1969 https://www.kinopoisk.ru/film/44985/ [Элек-

тронный ресурс] Дата обращения: 20.01.25

7 «Чебурашка» мультфильм, 2013 https://www.kinopoisk.ru/film/839110/ [Электрон-

ный ресурс] Дата обращения: 20.01.25

8 «Чебурашка» | | фильм, | | 2022

https://www.kinopoisk.ru/film/4370148/?utm_referrer=www.google.com [Электронный ресурс]

Дата обращения: 20.01.25

9 Фильм | «Чебурашка» | 2022 | самый | кассовый

https://www.kinopoisk.ru/media/article/4007300/ [Электронный ресурс] Дата обращения:

20.01.25

10 Аллигатор Луи https://www.theverge.com/2024/4/4/24120988/the-latest- imagineer-

ing-docuseries-doesnt-require-a-disney-plus-subscription#comments (https://www.theverge.com/2024/4/4/24120988/the-latest-imagineering-docuseries-doesnt-require-a-disney-plus-subscription) [Электронный ресурс] Дата

обращения: 20.01.25

11 Робот Теспиан https://itis-time.ru/robot/thespian/ [Электронный ресурс] Дата обра-

щения: 20.01.25

12 Arduino | Mega | https://store.arduino.cc/products/arduino-mega-2560-

rev3?queryID=undefined (https://store.arduino.cc/products/arduino-mega-2560-rev3?queryID=undefined) [Электронный ресурс] Дата обращения: 20.01.25

13 Motor Tetrix Max Torque NADO https://www.pitsco.com/products/tetrix- (https://www.pitsco.com/products/tetrix-max-torquenado-motor-with-encoder) max-

torquenado-motor-with-encoder (https://www.pitsco.com/products/tetrix-max-torquenado-motor-with-encoder) [Электронный ресурс] Дата обращения: 20.01.25

14 DS3240 | https://github.com/microrobotics/DS3240/blob/main/DS3240- | datasheet-

2024.pdf?ysclid=m5fv6400ru703865917 (https://github.com/microrobotics/DS3240/blob/main/DS3240-datasheet-2024.pdf?ysclid=m5fv6400ru703865917)

15 Raspberry Pi 4 model B https://www.raspberrypi.com/products/raspberry- pi-4-model-

b/ (https://www.raspberrypi.com/products/raspberry-pi-4-model-b/) [Электронный ресурс] Дата обращения: 20.01.25

16 Енот Ракета https://www.youtube.com/watch?v=HoHXPcRVa5w [Электронный ре-

сурс] Дата обращения: 20.01.25

17 Робот Ameca https://engineeredarts.com/robot/ameca/ [Электронный ресурс] Дата

обращения: 20.01.25

18 Робот | Топа | https://vc.ru/tech/1703677-sber-topa-

kuba?ysclid=m651wzc12r218121954 (https://vc.ru/tech/1703677-sber-topa-kuba?ysclid=m651wzc12r218121954) [Электронный ресурс] Дата обращения: 20.01.25

19 Робот | | | | Слон

https://robofinist.ru/files/event/bid/robot/description/79599/filename/TDP%208.pdf?ysclid=m654j

bjadd150730052 (https://robofinist.ru/files/event/bid/robot/description/79599/filename/TDP%208.pdf?ysclid=m654jbjadd150730052) [Электронный ресурс] Дата обращения: 20.01.25

20 Robby | Brown | https://rutube.ru/video/19e4ec4ece7c3a50ead21a6b56bc216c/?r=wd

[Электронный ресурс] Дата обращения: 20.01.25

21 Polulu | motor | driver | VNH5019A | https://robototehnika.ru/e-

store/catalog/203/1140/?ysclid=m652otddgm883933702 (https://robototehnika.ru/e-store/catalog/203/1140/?ysclid=m652otddgm883933702) [Электронный ресурс] Дата обраще-

ния: 20.01.25

22 RDS3218 | https://rcdrone.top/ru/products/dsservo-ds3218-цифровой- | сервопривод

[Электронный ресурс] Дата обращения: 20.01.25

23 Raspberry | Pi | Camera | Module | https://www.raspberrypi.com

/documentation/accessories/camera.html (https://www.raspberrypi.com/documentation/accessories/camera.html) [Электронный ресурс] Дата обращения: 20.01.25

24 Колонка JBL | Clip+ https://ru.jbl.com/JBL+CLIP+PLUS.html (https://ru.jbl.com/JBL%2BCLIP%2BPLUS.html) | [Электронный

ресурс] Дата обращения: 22.01.25

25 Портативный | монитор

https://aliexpress.ru/item/1005006149095343.html?spm=a2g2w.detail.similar_r

cmd.3.8df224e5IdlY2w&mixer_rcmd_bucket_id=aerabtestalgoRecommendAb

V2_testRankingTechNoPromoData&pdp_trigger_item_id=0_10050078941455

94&ru_algo_pv_id=d5d761-61b690-ba3e77-120a9e-

1736269200&scenario=aerSimilarItemPdpRcmd&sku_id=1200004422572930

2&traffic_source=recommendation&type_rcmd=core (https://aliexpress.ru/item/1005006149095343.html?pdp_trigger_item_id=0_1005007894145594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) [Электронный ресурс] Дата обращения:

22.01.25

26 Признаки | | | | Хаара

https://www.hse.ru/data/2013/05/31/1284710405/%D0%B4%D0%B8%D0%BF%D0%BB%D0%

BE%D0%BC.pdf?ysclid=m6qr9tsqom261005460 (https://www.hse.ru/data/2013/05/31/1284710405/%D0%B4%D0%B8%D0%BF%D0%BB%D0%BE%D0%BC.pdf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) [Электронный ресурс] Дата обращения:

04.02.25

27 Web-камера https://www.dns-shop.ru/product/e3f45480170ad582 [Электронный ре-

сурс] Дата обращения: 01.04.2025

28 Определение эскиза https://gramota.ru/poisk?query=эскиз&mode=all [Электронный

ресурс] Дата обращения: 01.04.2025

ПРИЛОЖЕНИЕ А. КОНСТРУКТОРСКАЯ ДОКУМЕНТАЦИЯ НА РОБОТА
На робота Чебурашку была разработана конструкторская документация в соответ-

ствии с ЕСКД, а именно:

1) на страницах 32-33 представлена электрическая структурная робота Чебурашки

на двух листах;

2) на странице 34 представлен чертеж кривошипа механизма стоп;
3) на странице 35 представлена принципиальная схема печатной платы преобразования пи-

тания и управления электромагнитами робота

4) на странице 36 представлена блок-схема алгоритма программ проекта.

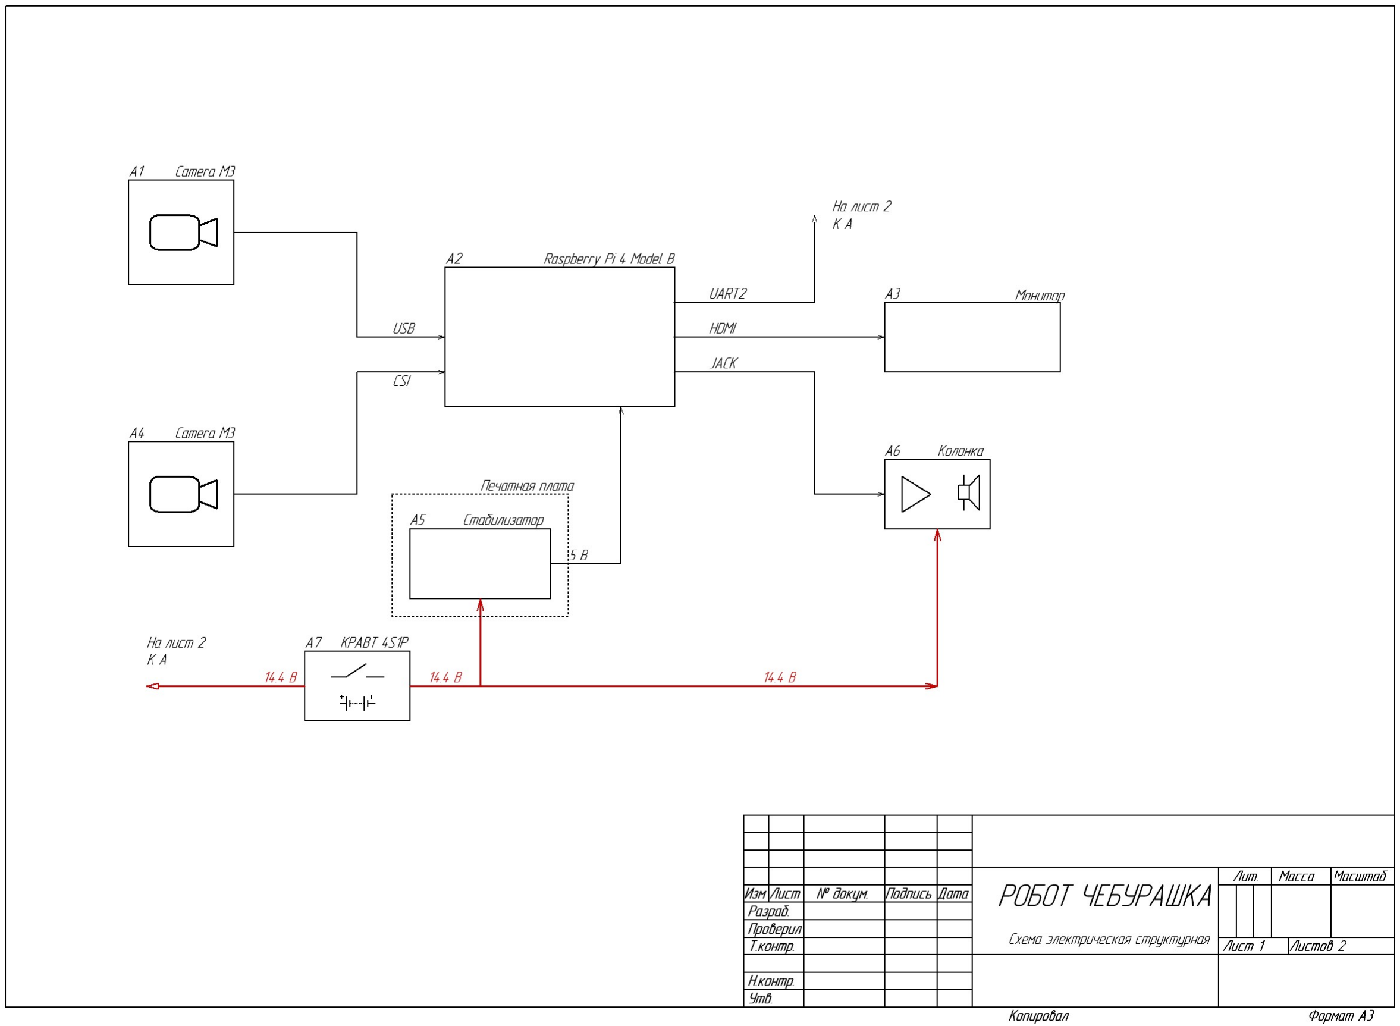
[picture p51: page 32]
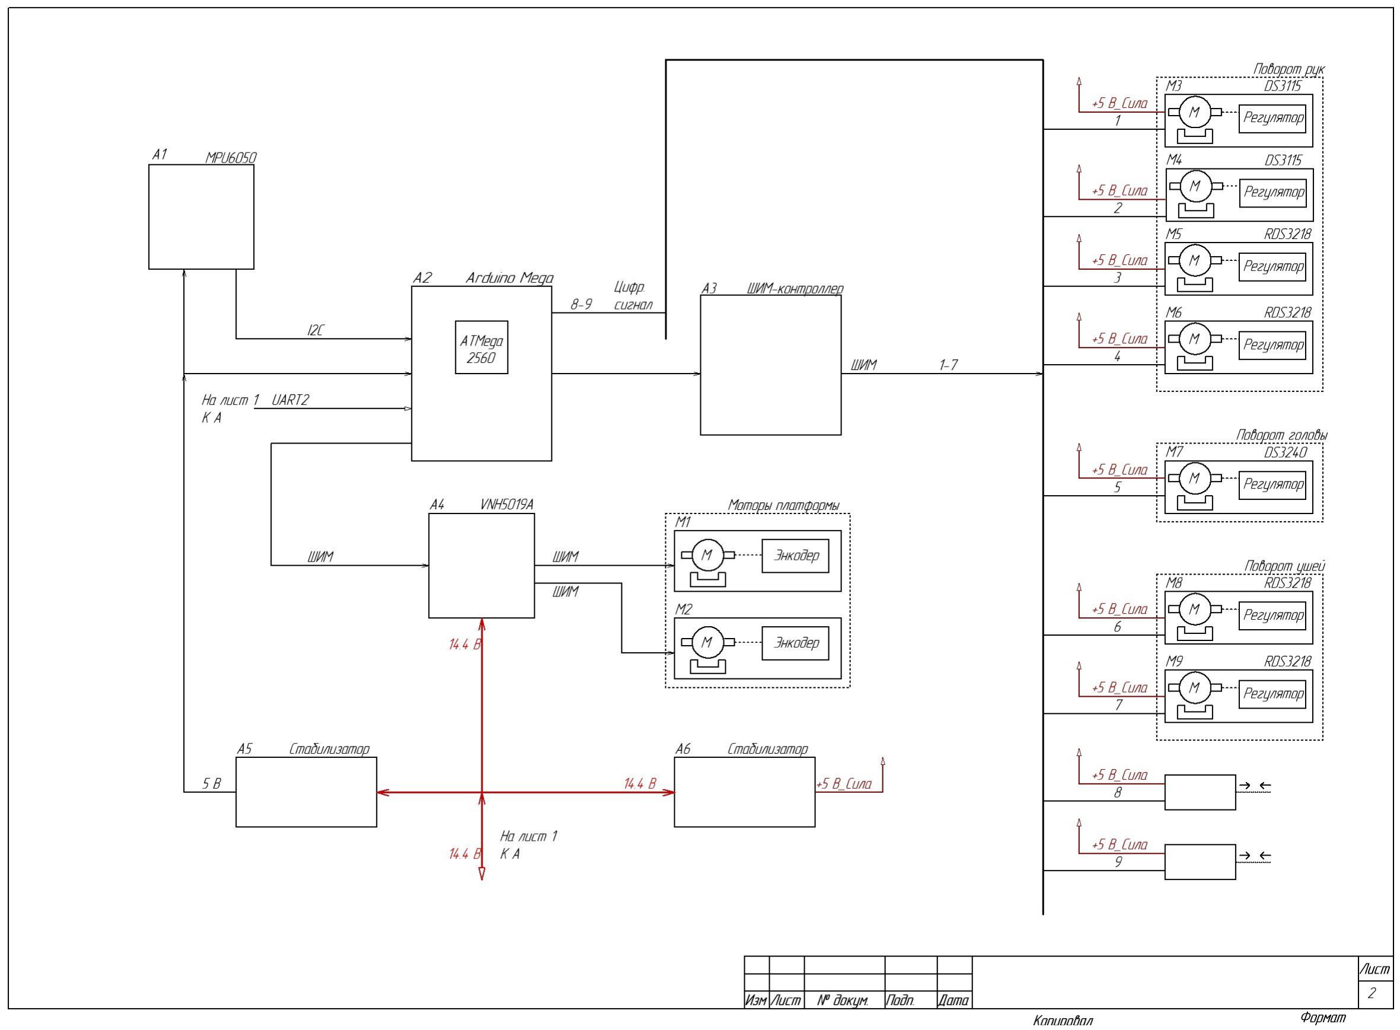
[picture p52: page 33]
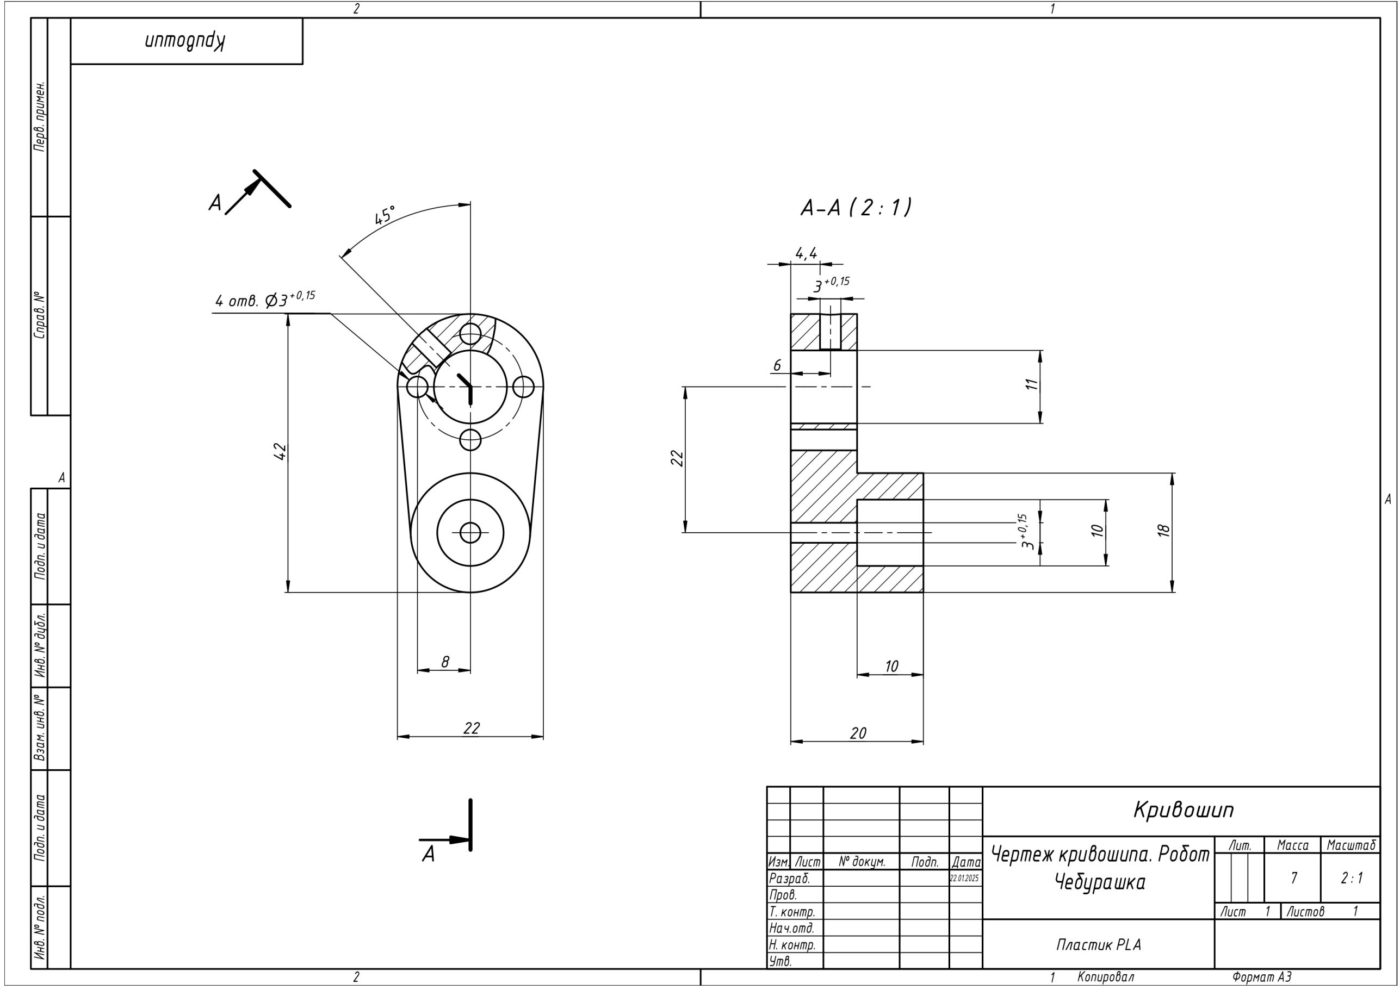
[picture p53: page 34]
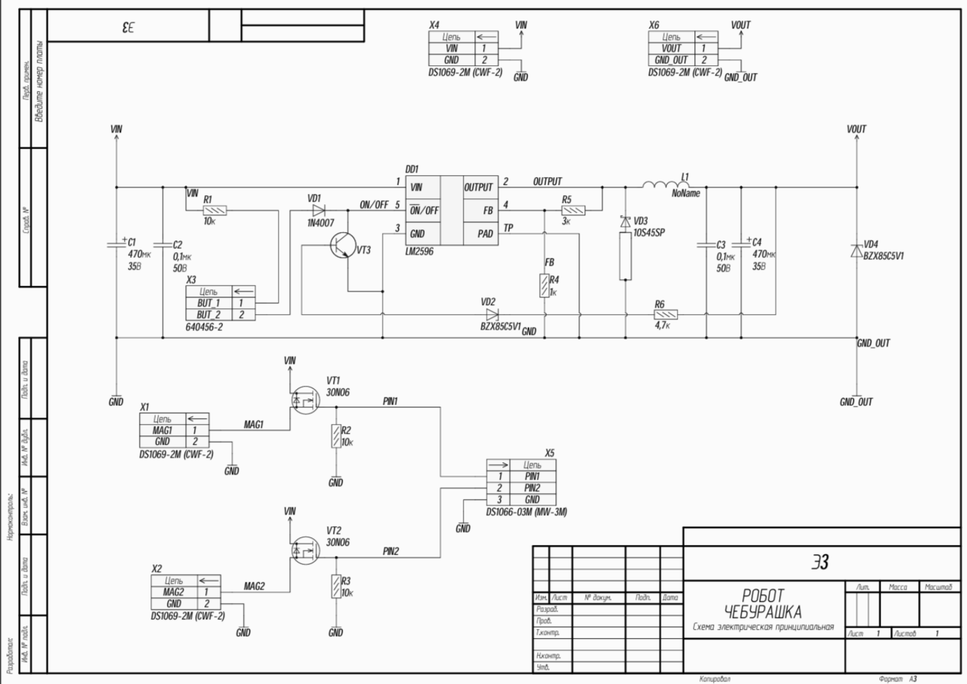
[picture p54: page 35]
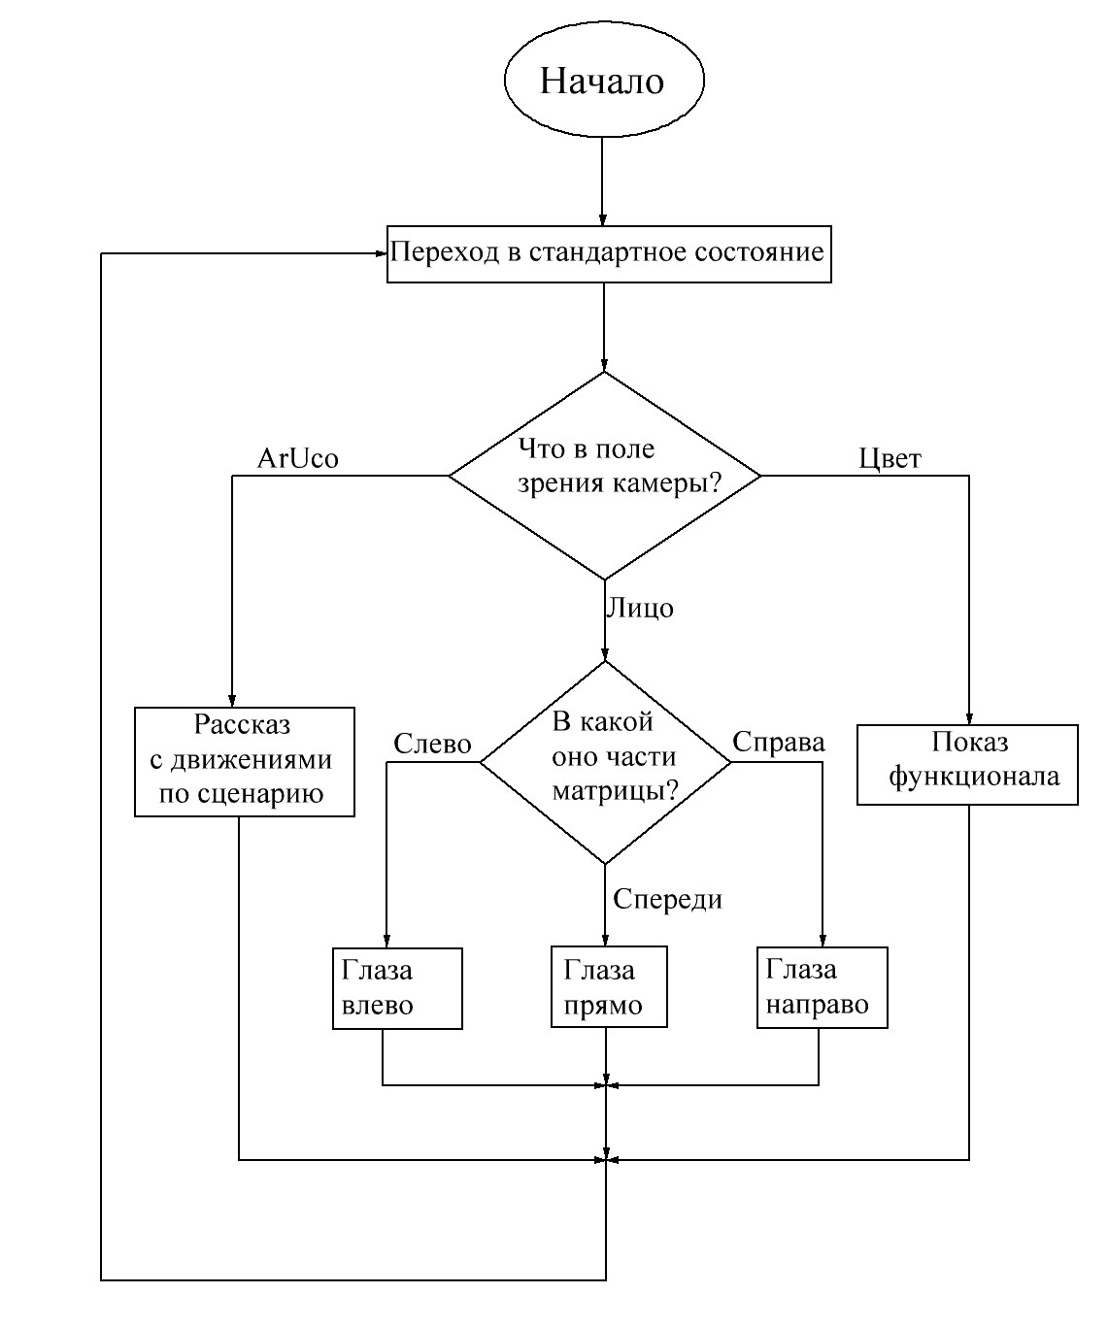
[picture p55: page 36]
