Ejenie/Cheburashka/Cheburashka_docx/Отчет команды Хорошие дела.pdf

Нашими результатами мы с командой довольны. За короткие сроки перед соревнованиями нами были собраны и запрограммированы все роботы, которые технически верно сработали на сцене. В нашу подготовку следовало добавить большее количество репетиций с роботами.
У команд соперников интересных технических решений нами замечено не было, но интересное взаимодействие с судьями и залом в своей сценке реализовала команда «Иван Федорович Крузенштерн», выступавшая в младшей лиге категории шоу с роботами. Перед началом выступления команда выдавала жюри карточки, а в конце просила выбрать один из двух вариантов выражения лица робота.
В планах на следующие соревнования – отладить текущие версии конструкций, программ, систем запуска всех роботов, провести большое количество репетиций, подготовиться к вопросам на техническом интервью и исправить видео технической демонстрации с актуальными действиями роботов.
Больше всего запомнились неожиданные изменения в регламенте, вводившиеся судьями в процессе соревнований. Наша команда надеется, что на дальнейших состязаниях правила выступления и оценки не будут отличаться от актуальной версии представленных на официальном сайте RoboCup Junior On Stage.
