Ejenie/Cheburashka/Cheburashka_construction/face/Design Data/XLS/ru-RU/clearance.xls

Sheet: ANSI дюймовая унифицированная
I | Порядок сортировки -1
Тип детали | Резьба | Диаметр под стержень |  |  | Размеры под головку
 |  | С натягом | Нормальное | С зазором | Диаметр | Глубина/Угол | Тип
Винт крепежный с плоской головкой (82) | #0 | 0.0635 | 0.07 | 0.073 | 0.119 | 82 | 2
Винт крепежный с плоской головкой (82) | #1 | 0.076 | 0.081 | 0.089 | 0.146 | 82 | 2
Винт крепежный с плоской головкой (82) | #2 | 0.089 | 0.096 | 0.1065 | 0.172 | 82 | 2
Винт крепежный с плоской головкой (82) | #3 | 0.104 | 0.11 | 0.12 | 0.199 | 82 | 2
Винт крепежный с плоской головкой (82) | #4 | 0.116 | 0.1285 | 0.136 | 0.225 | 82 | 2
Винт крепежный с плоской головкой (82) | #5 | 0.1285 | 0.136 | 0.154 | 0.252 | 82 | 2
Винт крепежный с плоской головкой (82) | #6 | 0.144 | 0.1495 | 0.1695 | 0.279 | 82 | 2
Винт крепежный с плоской головкой (82) | #8 | 0.1695 | 0.177 | 0.1935 | 0.332 | 82 | 2
Винт крепежный с плоской головкой (82) | #10 | 0.196 | 0.201 | 0.221 | 0.385 | 82 | 2
Винт крепежный с плоской головкой (82) | #12 | 0.221 | 0.228 | 0.246 | 0.438 | 82 | 2
Винт крепежный с плоской головкой (82) | 1/4 | 0.257 | 0.266 | 0.2812 | 0.507 | 82 | 2
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
