Ejenie/Cheburashka/Cheburashka_docx/actualEmotion/movement_forward.png

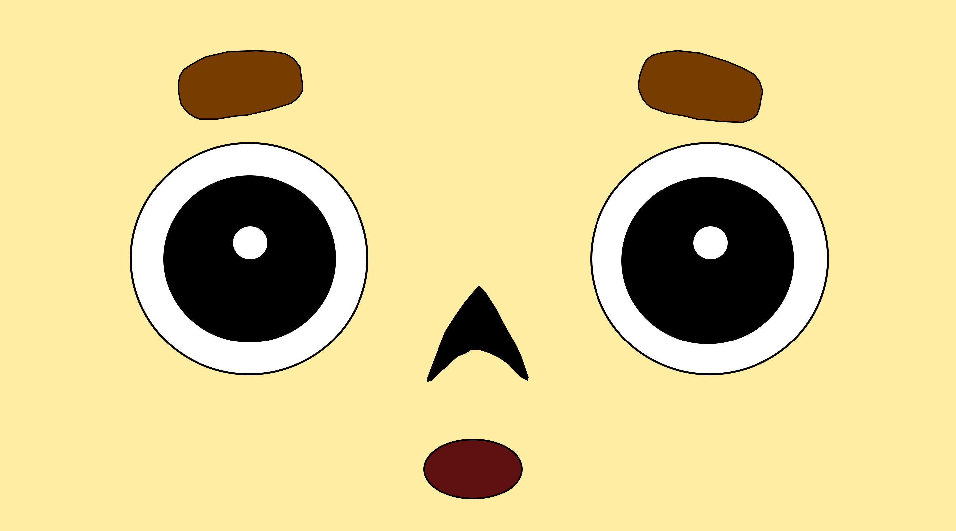
Cheburashka_docx/actualEmotion/movement_forward.png
