Ejenie/Cheburashka/Cheburashka_docx/actualEmotion/scream_down.png

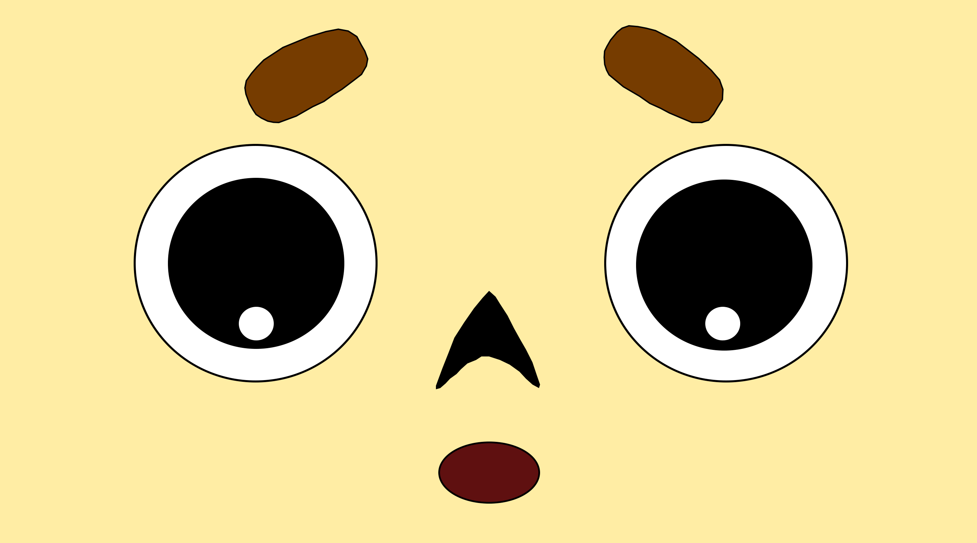
Cheburashka_docx/actualEmotion/scream_down.png
