Ejenie/Cheburashka/Cheburashka_docx/мордочкиБольшие/грусть_прямо.png

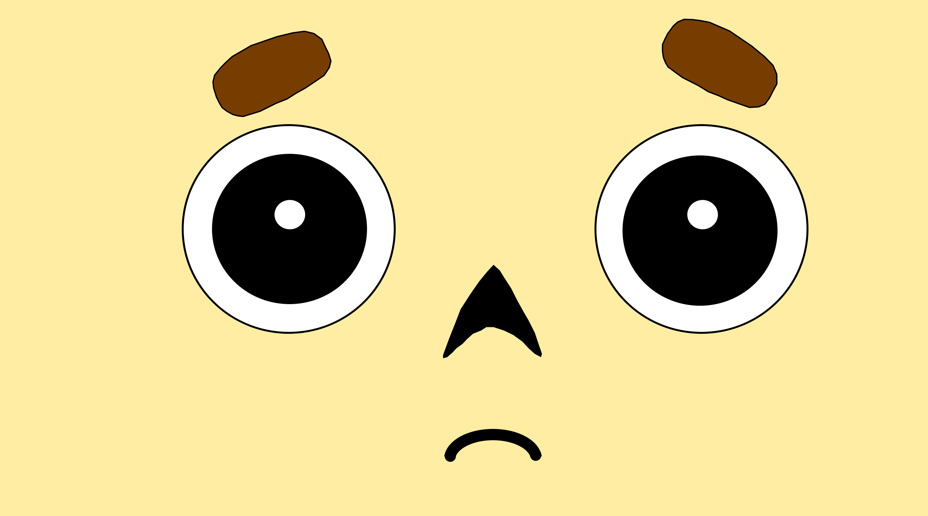
Cheburashka_docx/мордочкиБольшие/грусть_прямо.png
