Ejenie/Cheburashka/Cheburashka_docx/мордочкиБольшие/страх_вверх.png

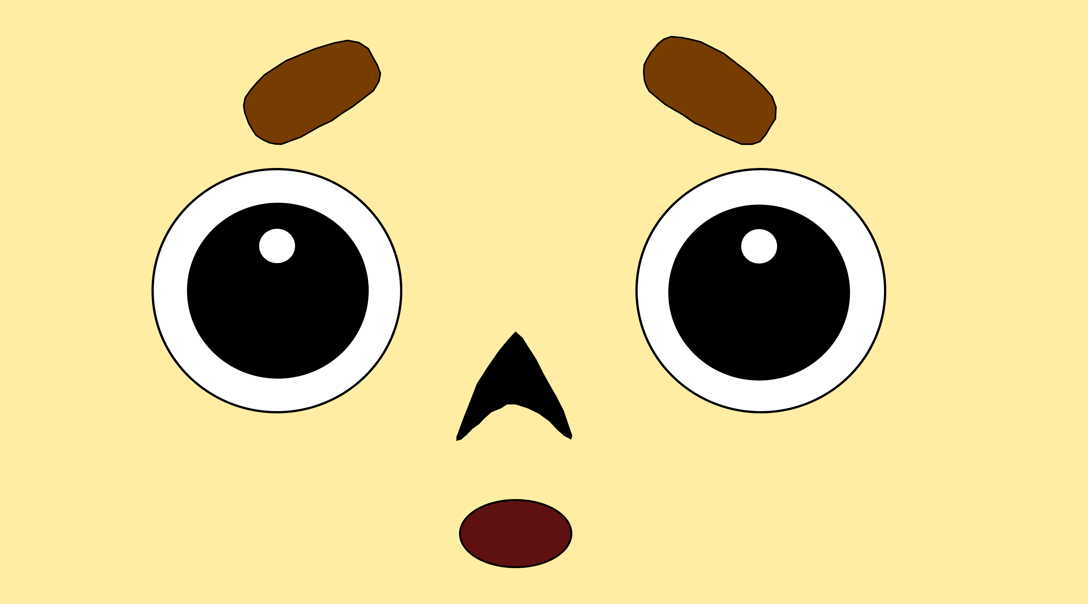
Cheburashka_docx/мордочкиБольшие/страх_вверх.png
