Ejenie/Cheburashka/Cheburashka_firmware/Arduino/study/мордочки/мордочкиPNG/gas-kvas-com-p-applikatsii-litso-cheburashki-18.png

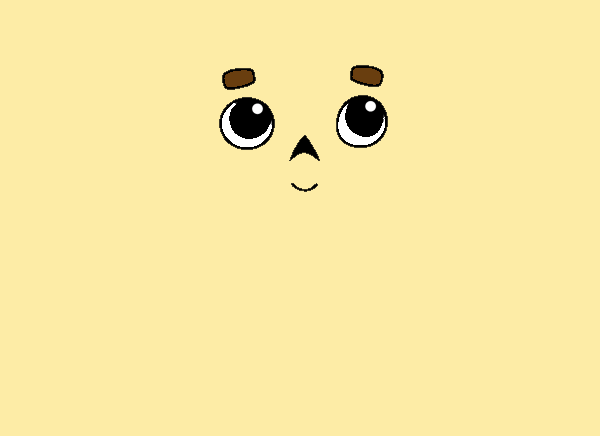
Cheburashka_firmware/Arduino/study/мордочки/мордочкиPNG/gas-kvas-com-p-applikatsii-litso-cheburashki-18.png
