Ejenie/Cheburashka/Cheburashka_firmware/docs/Блок-схема.jpg

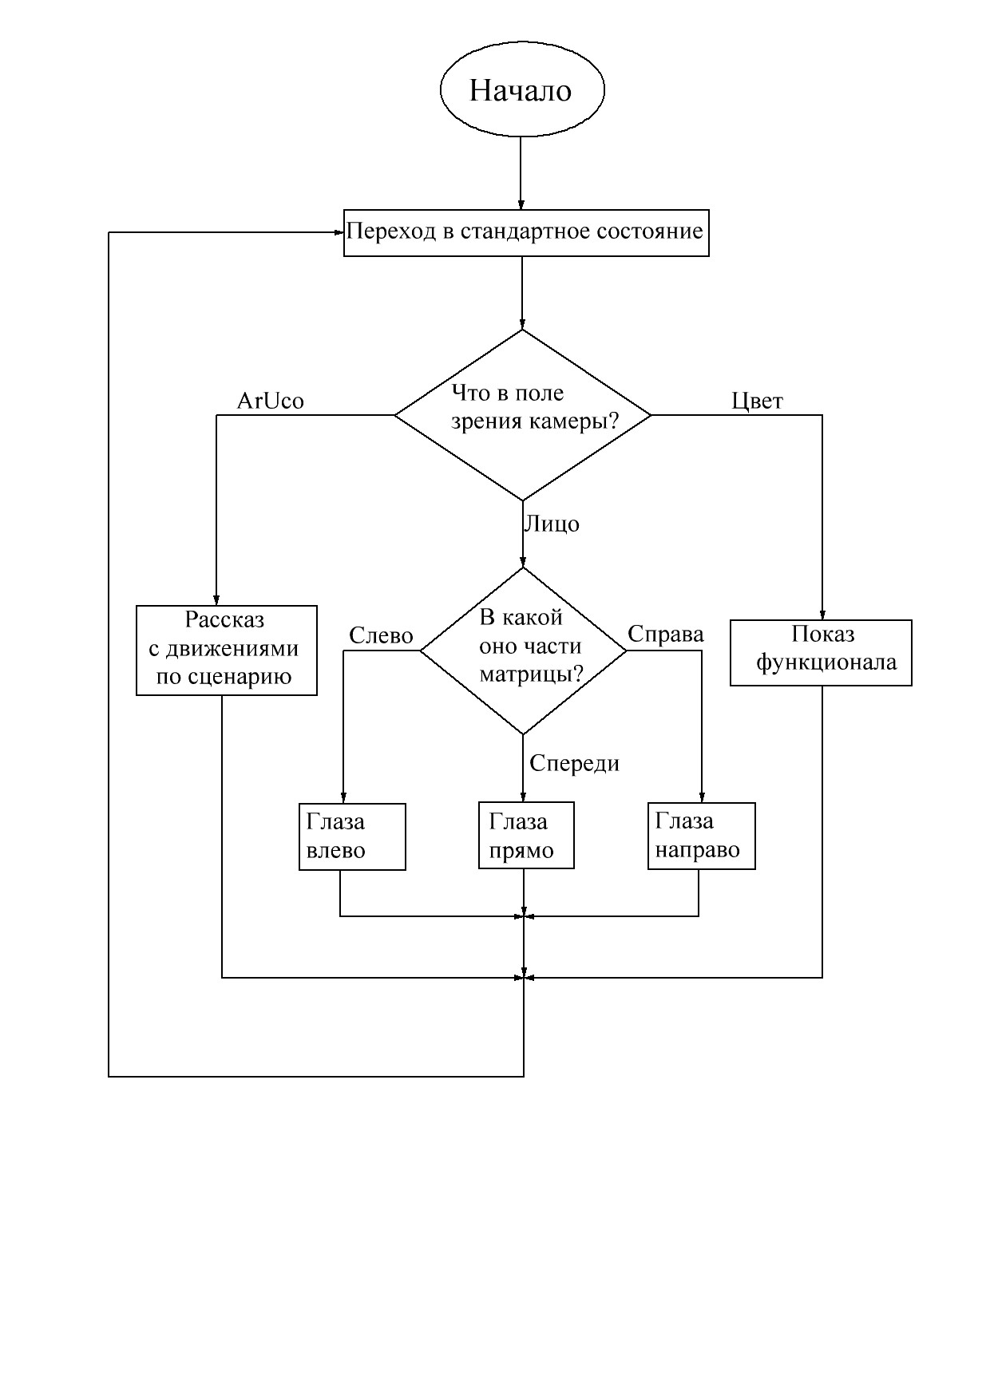
Cheburashka_firmware/docs/Блок-схема.jpg
