Ejenie/Cheburashka/Cheburashka_construction/korpus/arduino-mega-2650-1.snapshot.2/arduino MEGA2650/USB type b.SLDPRT.SLDASM

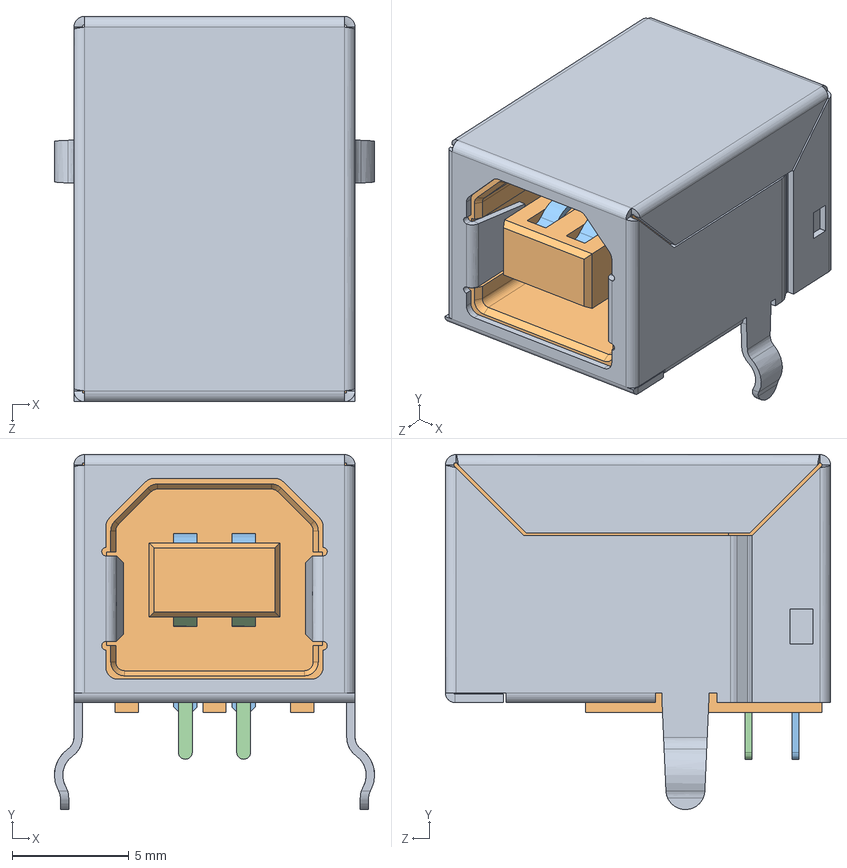
[picture p93: CAD file, 2025-01-25]
Cheburashka_construction/korpus/arduino-mega-2650-1.snapshot.2/arduino MEGA2650/USB type b.SLDPRT.SLDASM
13.7 x 15.2 x 16.5 mm
USB SHELL
USB core
usb top contact x 2
usb btm contact x 2
