Ejenie/Cheburashka/Cheburashka_construction/face/лицо/rds3218/bacteriomaker3d/servo-robot-rds3218/acc2.stl

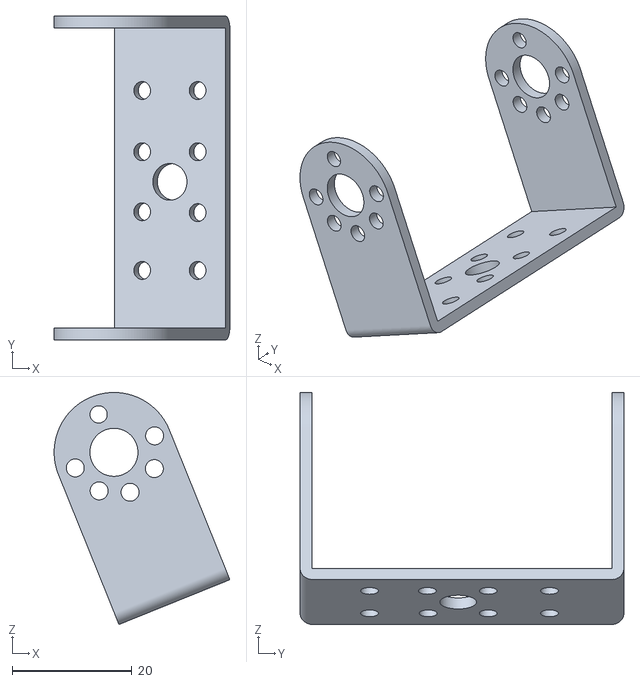
[picture p94: CAD file, 2024-12-03]
Cheburashka_construction/face/лицо/rds3218/bacteriomaker3d/servo-robot-rds3218/acc2.stl
29.4 x 54.1 x 38.8
