Ejenie/Cheburashka/Cheburashka_construction/face/лицо/креп_камеры.stl

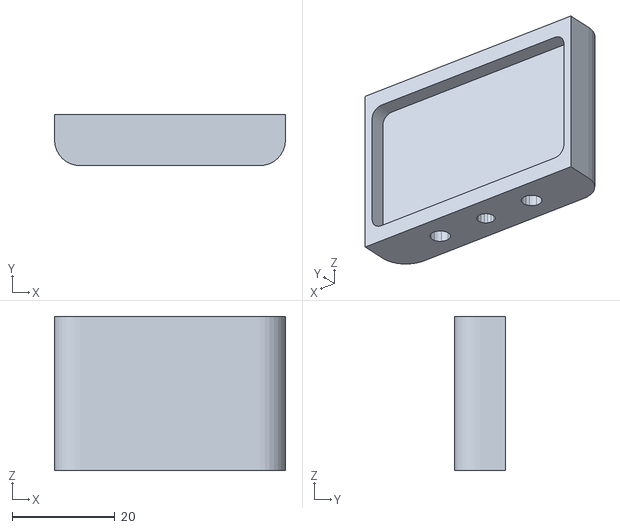
[picture p95: CAD file, 2025-10-22]
Cheburashka_construction/face/лицо/креп_камеры.stl
45.0 x 10.0 x 30.0
