Ejenie/Cheburashka/Cheburashka_construction/korpus/arduino-mega-2650-1.snapshot.2/arduino MEGA2650/RESET CORE.SLDPRT

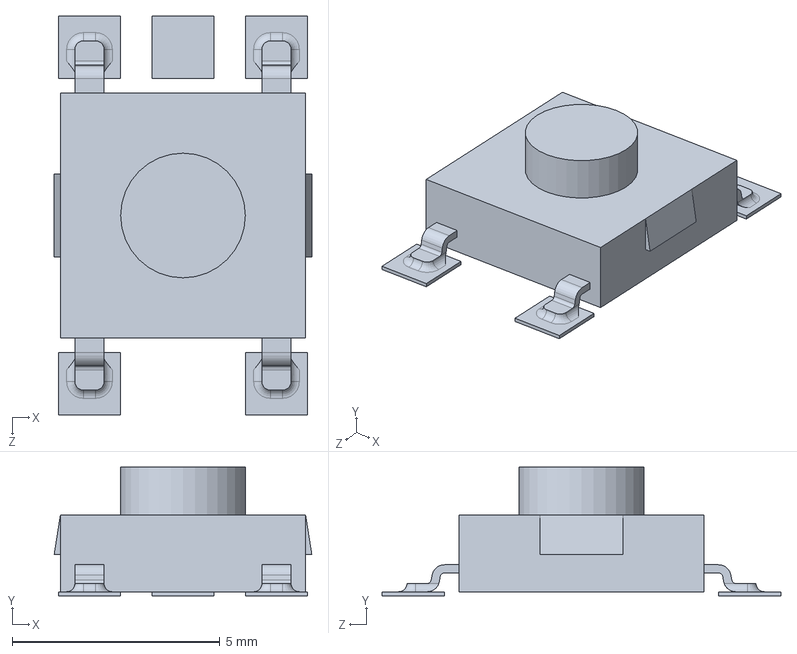
[picture p96: CAD file, 2025-01-25]
Cheburashka_construction/korpus/arduino-mega-2650-1.snapshot.2/arduino MEGA2650/RESET CORE.SLDPRT
6.20 x 3.10 x 9.60 mm
