Ejenie/Cheburashka/Cheburashka_construction/korpus/ds3240/emiliooros/servomotor-ds3240/DS3240_Servomotor 40Kg 4.8-6.8v.STEP

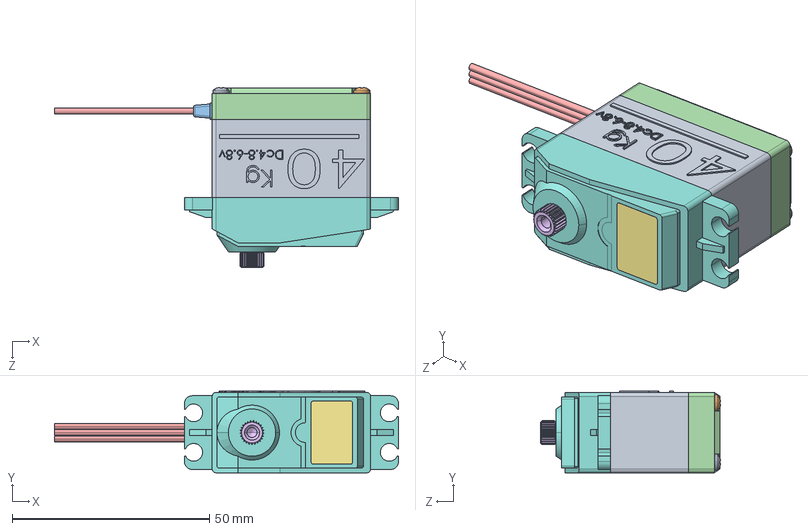
[picture p97: CAD file, 2025-02-10]
Cheburashka_construction/korpus/ds3240/emiliooros/servomotor-ds3240/DS3240_Servomotor 40Kg 4.8-6.8v.STEP
87.3 x 20.7 x 45.7 mm
