Ejenie/Cheburashka/Cheburashka_construction/korpus/крепление_кракаса.stl

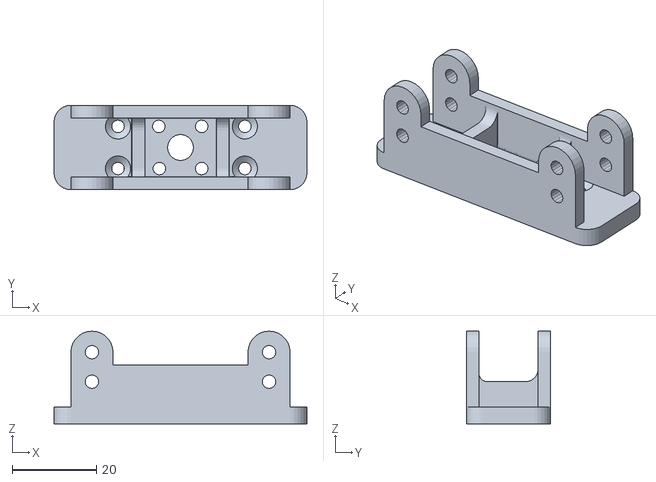
[picture p99: CAD file, 2025-11-26]
Cheburashka_construction/korpus/крепление_кракаса.stl
60.0 x 20.0 x 22.0
