Ejenie/Cheburashka/Cheburashka_construction/korpus/резать и печатать/верхний_эллипс_туловища_v3.dxf

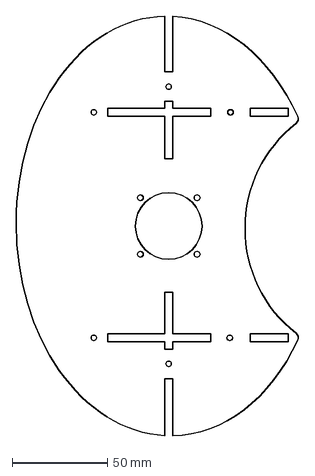
[picture p100: CAD file, 2026-10-02]
Cheburashka_construction/korpus/резать и печатать/верхний_эллипс_туловища_v3.dxf
148.3 x 220.0 mm
