Ejenie/Cheburashka/Cheburashka_construction/platform/legs/втулка_13-11.stp

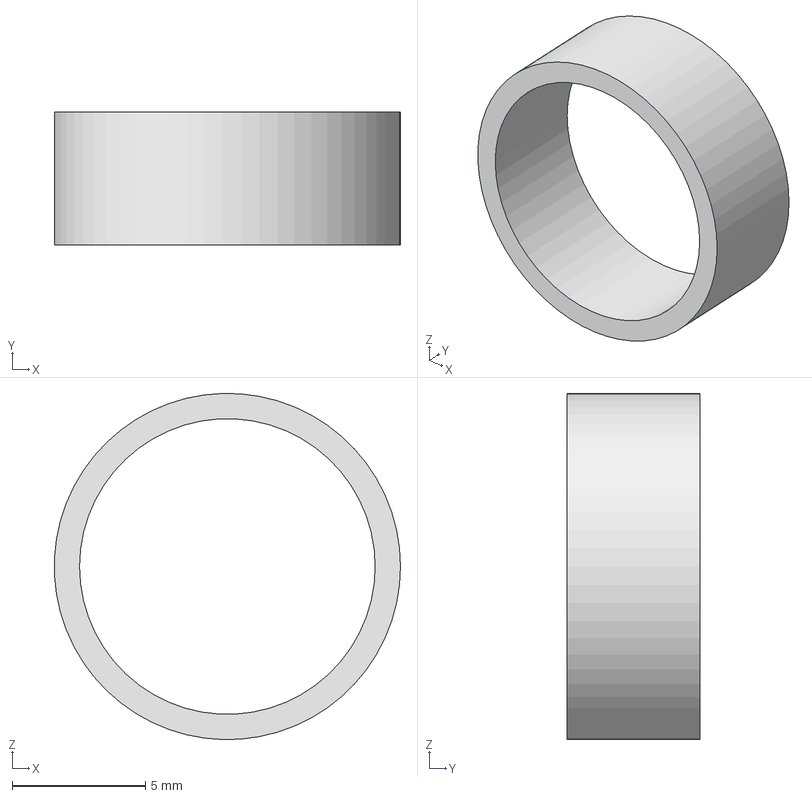
[picture p101: CAD file, 2026-10-02]
Cheburashka_construction/platform/legs/втулка_13-11.stp
13.0 x 5.00 x 13.0 mm
