Ejenie/Cheburashka/Cheburashka_construction/platform/new_holder.stl

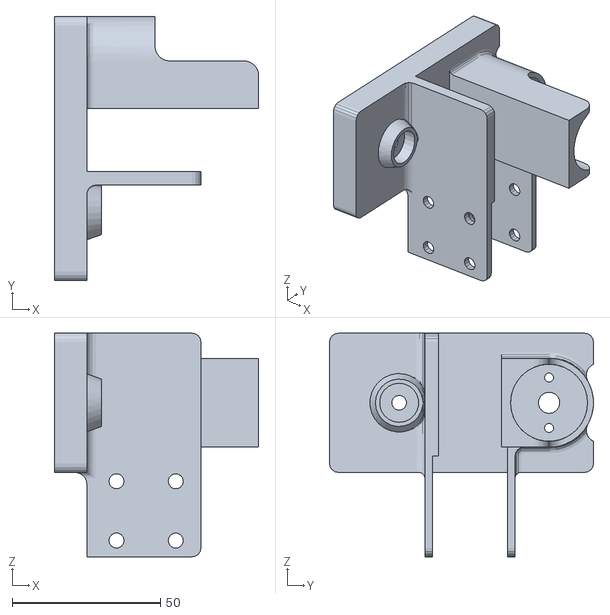
[picture p102: CAD file, 2025-09-23]
Cheburashka_construction/platform/new_holder.stl
69.0 x 89.1 x 75.5
