Ejenie/Cheburashka/Cheburashka_construction/platform/Raspberry Pi Camera Stand - 274111/files/camera_stand_v001.igs

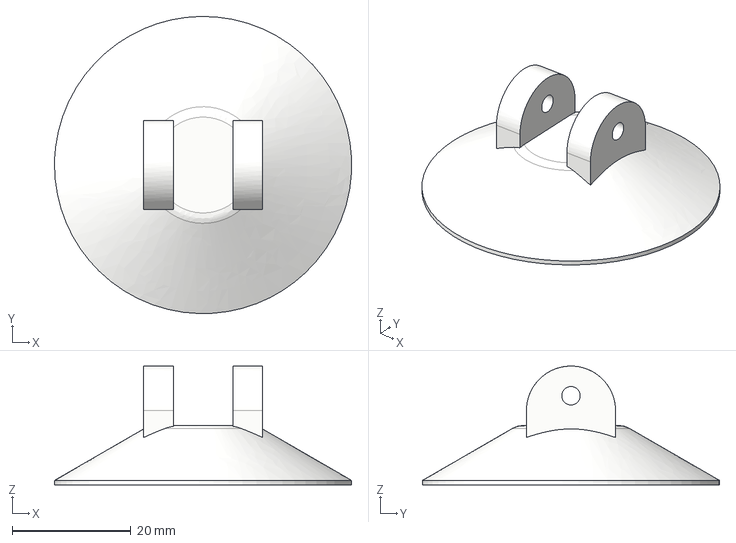
[picture p103: CAD file, 2024-12-27]
Cheburashka_construction/platform/Raspberry Pi Camera Stand - 274111/files/camera_stand_v001.igs
50.0 x 50.0 x 20.0 mm
