Ejenie/Cheburashka/Cheburashka_electronix/плата/контур.dxf

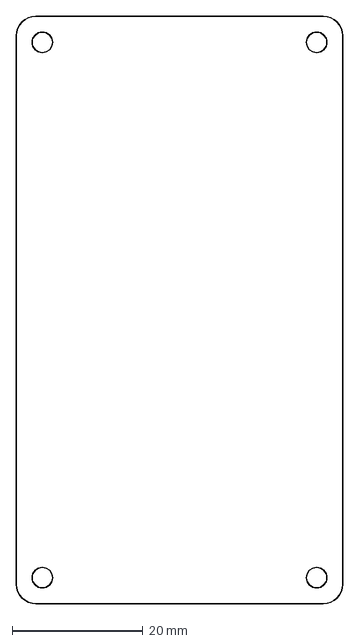
[picture p104: CAD file, 2025-04-13]
Cheburashka_electronix/плата/контур.dxf
50.0 x 90.0 mm
