Ejenie/Cheburashka/Cheburashka_construction/face/лицо/rds3218/bacteriomaker3d/servo-robot-rds3218/acc1.stl

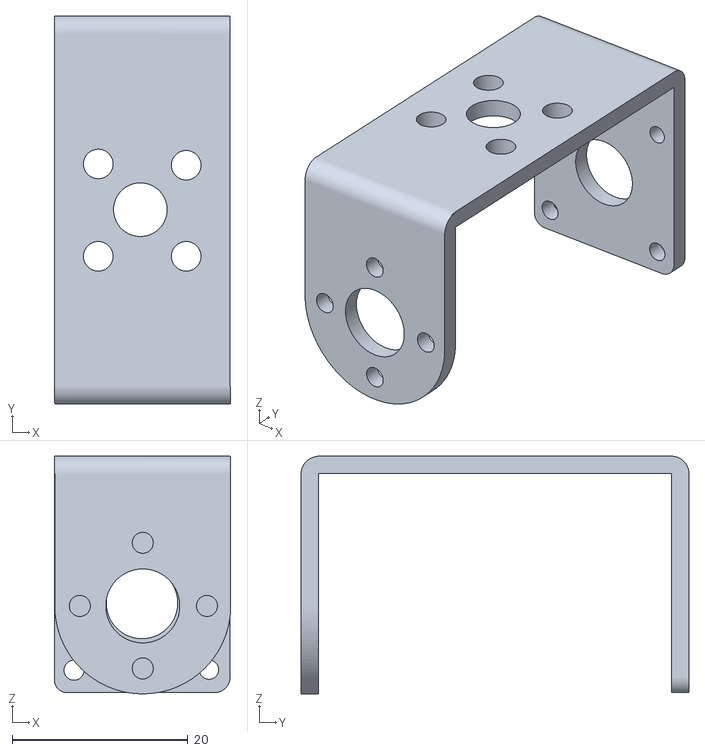
[picture p105: CAD file, 2024-12-03]
Cheburashka_construction/face/лицо/rds3218/bacteriomaker3d/servo-robot-rds3218/acc1.stl
20.1 x 44.1 x 27.0
