Ejenie/Cheburashka/Cheburashka_construction/face/лицо/ухо.dxf

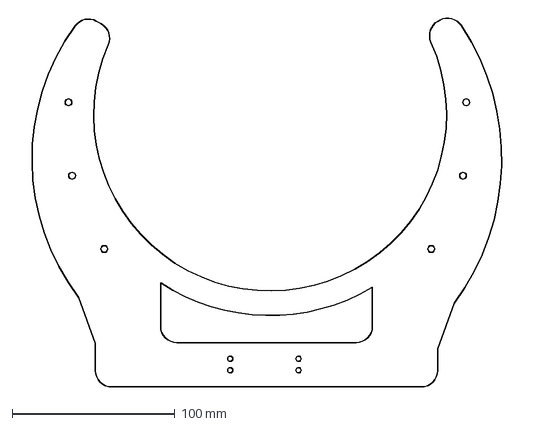
[picture p106: CAD file, 2025-10-22]
Cheburashka_construction/face/лицо/ухо.dxf
307.8 x 227.5 mm
