Ejenie/Cheburashka/Cheburashka_construction/korpus/arduino-mega-2650-1.snapshot.2/arduino MEGA2650/MLC0603.SLDPRT

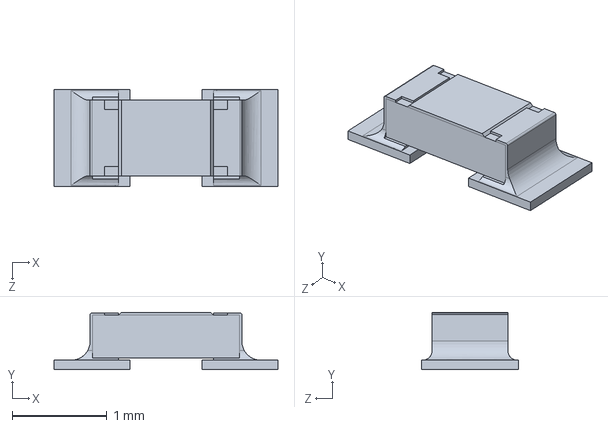
[picture p107: CAD file, 2025-01-25]
Cheburashka_construction/korpus/arduino-mega-2650-1.snapshot.2/arduino MEGA2650/MLC0603.SLDPRT
2.36 x 0.605 x 1.02 mm
