Ejenie/Cheburashka/Cheburashka_construction/korpus/cil2.stl

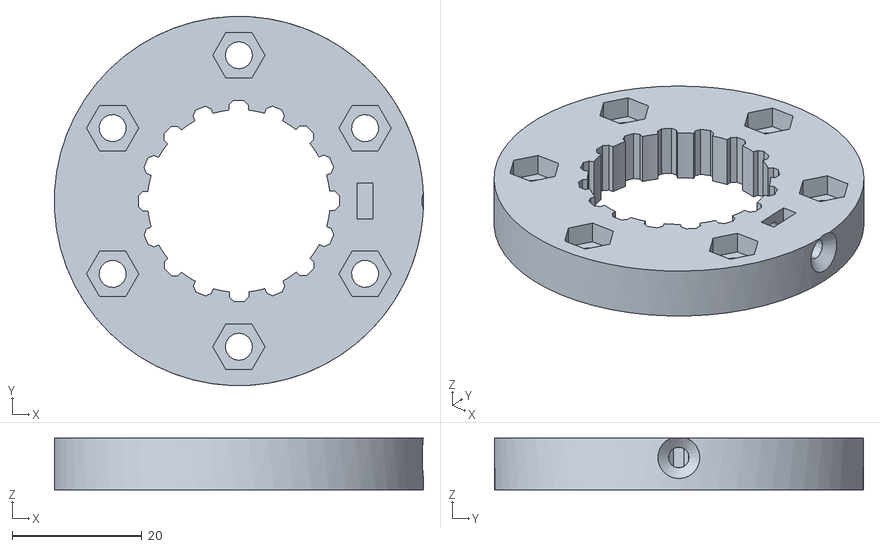
[picture p108: CAD file, 2025-10-22]
Cheburashka_construction/korpus/cil2.stl
57.0 x 57.0 x 8.00
