Ejenie/Cheburashka/Cheburashka_construction/korpus/резать и печатать/держатель.stp

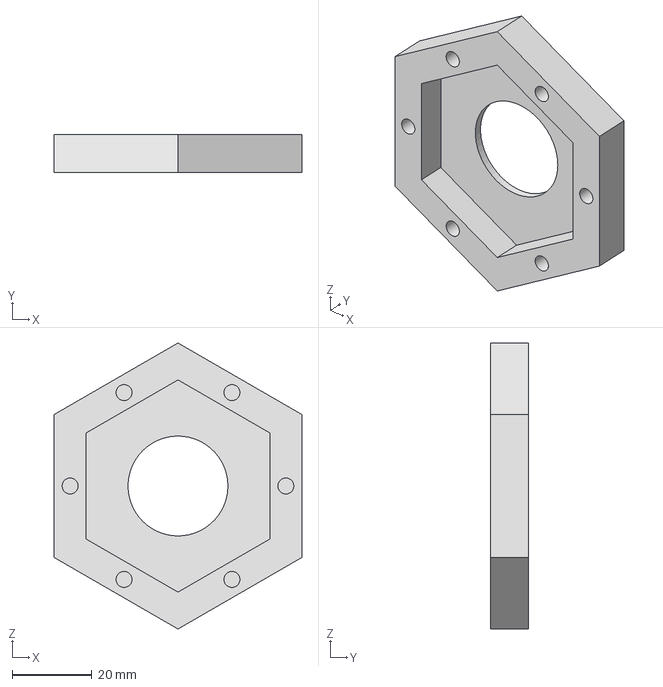
[picture p110: CAD file, 2026-10-02]
Cheburashka_construction/korpus/резать и печатать/держатель.stp
62.0 x 9.50 x 71.6 mm
