Ejenie/Cheburashka/Cheburashka_construction/platform/legs/шестерня12_туу.stp

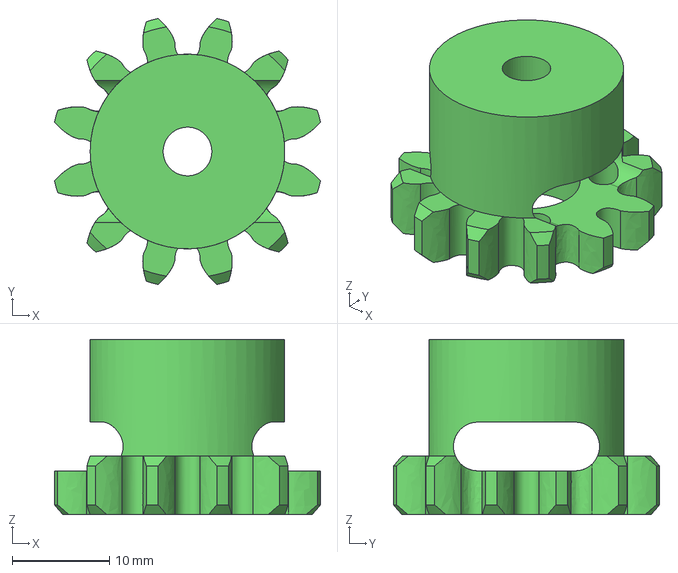
[picture p111: CAD file, 2026-10-02]
Cheburashka_construction/platform/legs/шестерня12_туу.stp
27.3 x 27.3 x 18.0 mm
