Ejenie/Cheburashka/Cheburashka_construction/platform/print/шатун88.stl

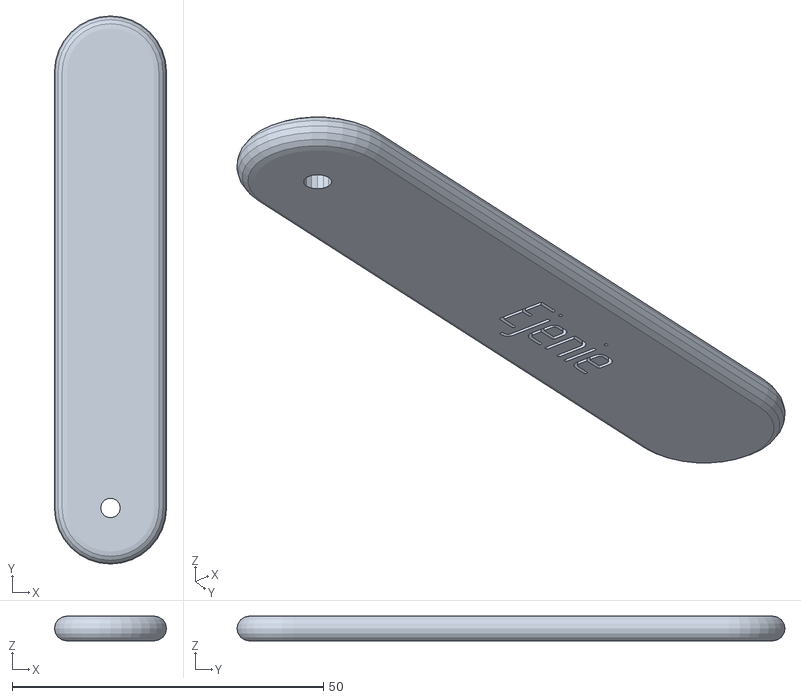
[picture p112: CAD file, 2025-05-12]
Cheburashka_construction/platform/print/шатун88.stl
18.0 x 88.0 x 4.00
