Ejenie/Cheburashka/Cheburashka_construction/platform/Raspberry Pi Camera Stand - 274111/files/camera_back_cover_v002.igs

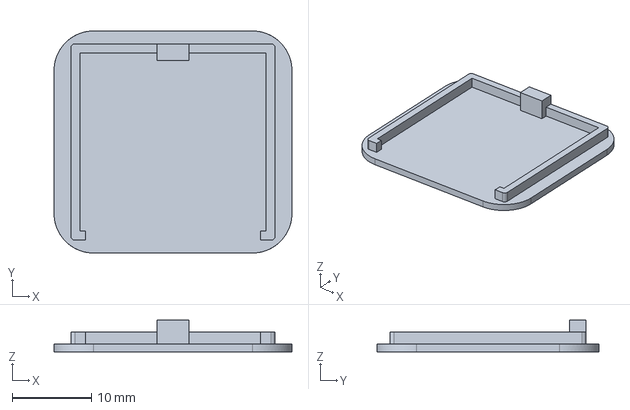
[picture p113: CAD file, 2024-12-27]
Cheburashka_construction/platform/Raspberry Pi Camera Stand - 274111/files/camera_back_cover_v002.igs
30.0 x 28.0 x 4.00 mm
