Ejenie/Cheburashka/Cheburashka_construction/platform/шатун98.stl

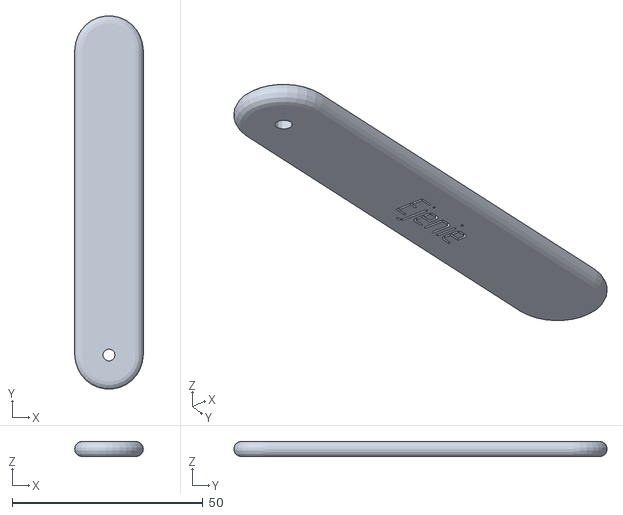
[picture p114: CAD file, 2025-05-12]
Cheburashka_construction/platform/шатун98.stl
18.0 x 97.8 x 4.00
