Ejenie/Cheburashka/Cheburashka_construction/face/лицо/camera.stp

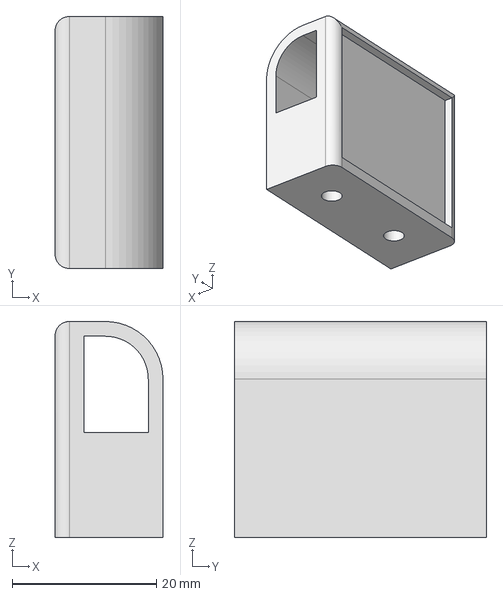
[picture p115: CAD file, 2025-10-22]
Cheburashka_construction/face/лицо/camera.stp
15.0 x 35.0 x 30.0 mm
