Ejenie/Cheburashka/Cheburashka_construction/face/лицо/rds3218/bacteriomaker3d/servo-robot-rds3218/Servo.stl

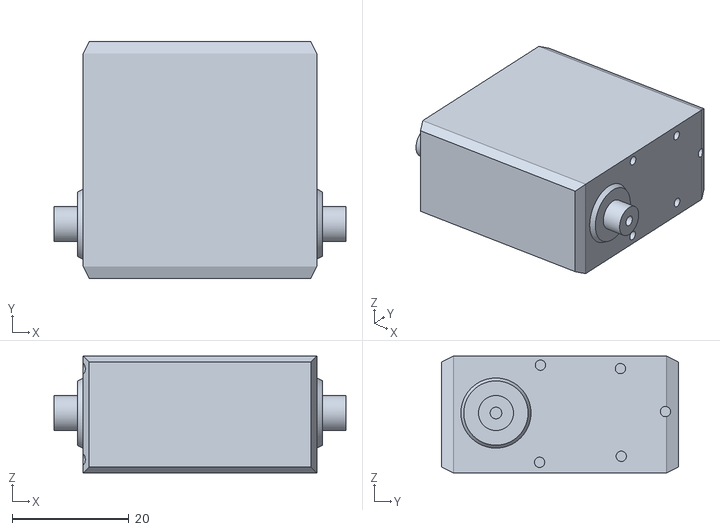
[picture p116: CAD file, 2024-12-03]
Cheburashka_construction/face/лицо/rds3218/bacteriomaker3d/servo-robot-rds3218/Servo.stl
50.0 x 40.5 x 20.0
