Ejenie/Cheburashka/Cheburashka_construction/korpus/arduino-mega-2650-1.snapshot.2/arduino MEGA2650/10 PORT HEADER.SLDPRT

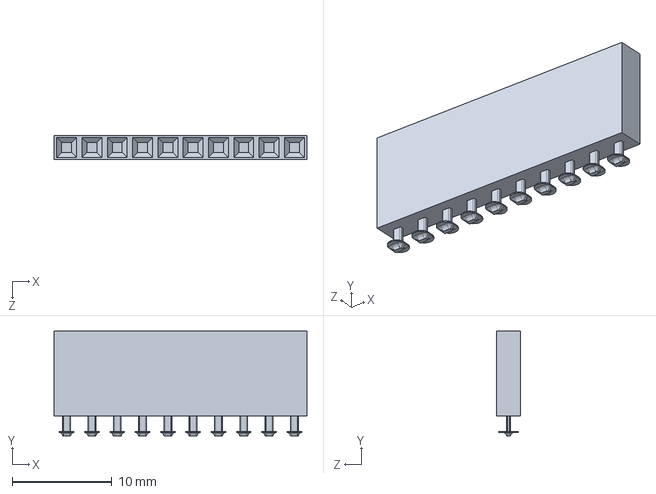
[picture p117: CAD file, 2025-01-25]
Cheburashka_construction/korpus/arduino-mega-2650-1.snapshot.2/arduino MEGA2650/10 PORT HEADER.SLDPRT
25.4 x 10.5 x 2.41 mm
