Ejenie/Cheburashka/Cheburashka_construction/korpus/raspberry-pi-4-model-b-1.snapshot.3/Female Micro HDMI Connector, RPi4ModelB.SLDPRT

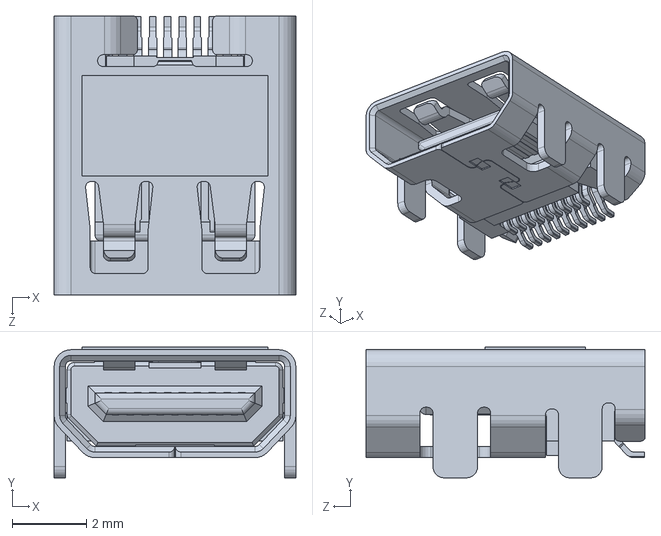
[picture p118: CAD file, 2025-01-25]
Cheburashka_construction/korpus/raspberry-pi-4-model-b-1.snapshot.3/Female Micro HDMI Connector, RPi4ModelB.SLDPRT
6.50 x 3.52 x 7.50 mm
