Ejenie/Cheburashka/Cheburashka_construction/korpus/каркас1.stl

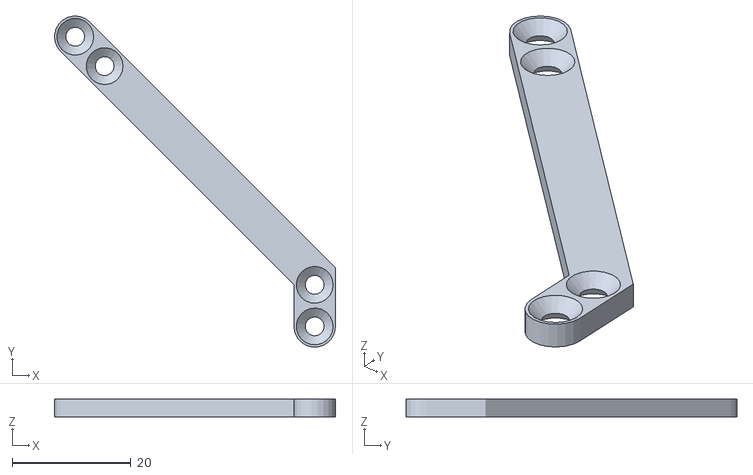
[picture p119: CAD file, 2025-10-22]
Cheburashka_construction/korpus/каркас1.stl
47.3 x 55.7 x 3.00
