Ejenie/Cheburashka/Cheburashka_construction/korpus/резать и печатать/крепление_кракаса.stl

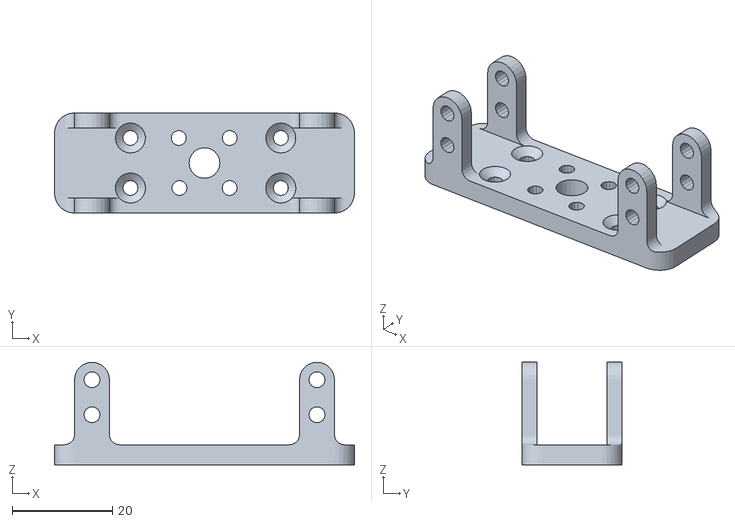
[picture p120: CAD file, 2025-10-22]
Cheburashka_construction/korpus/резать и печатать/крепление_кракаса.stl
60.0 x 20.0 x 20.5
