Ejenie/Cheburashka/Cheburashka_construction/platform/print/v2_4мм_поперечная_больш.dxf

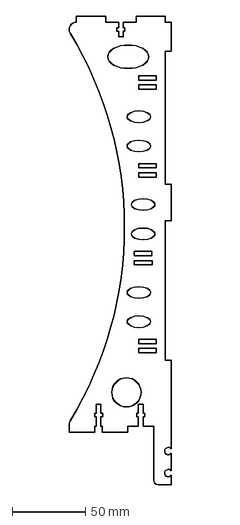
[picture p121: CAD file, 2025-02-10]
Cheburashka_construction/platform/print/v2_4мм_поперечная_больш.dxf
70.0 x 320.0 mm
