Ejenie/Cheburashka/Cheburashka_construction/platform/Raspberry Pi Camera Stand - 274111/files/camera_front_box_v003.igs

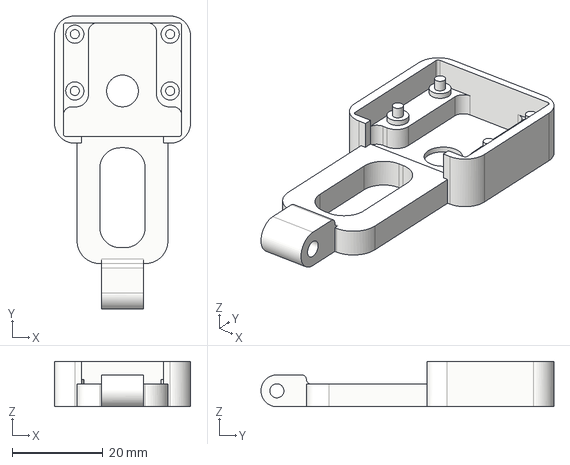
[picture p122: CAD file, 2024-12-27]
Cheburashka_construction/platform/Raspberry Pi Camera Stand - 274111/files/camera_front_box_v003.igs
30.0 x 64.5 x 10.0 mm
