Ejenie/Cheburashka/Cheburashka_construction/platform/гриб2.stl

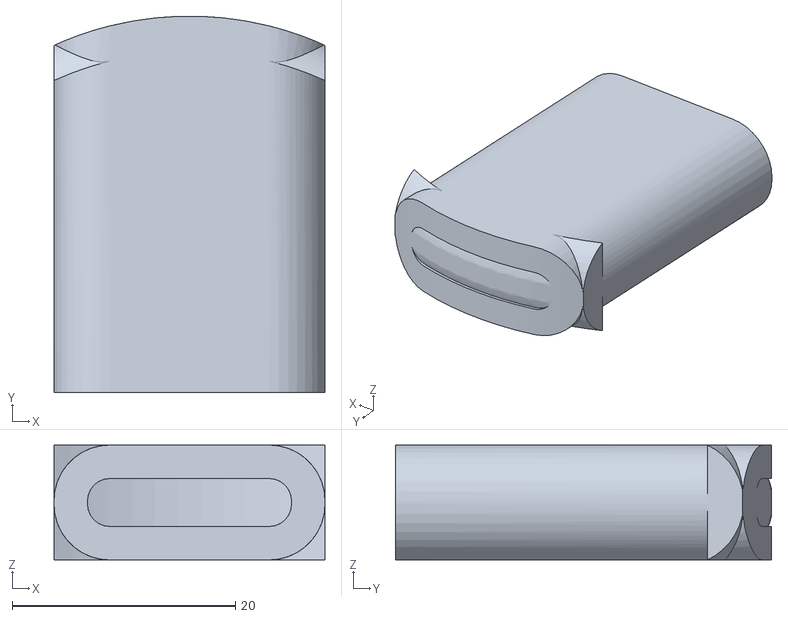
[picture p123: CAD file, 2025-04-13]
Cheburashka_construction/platform/гриб2.stl
24.3 x 33.8 x 10.3
