Ejenie/Cheburashka/Cheburashka_construction/face/лицо/креп_сервы2.stl

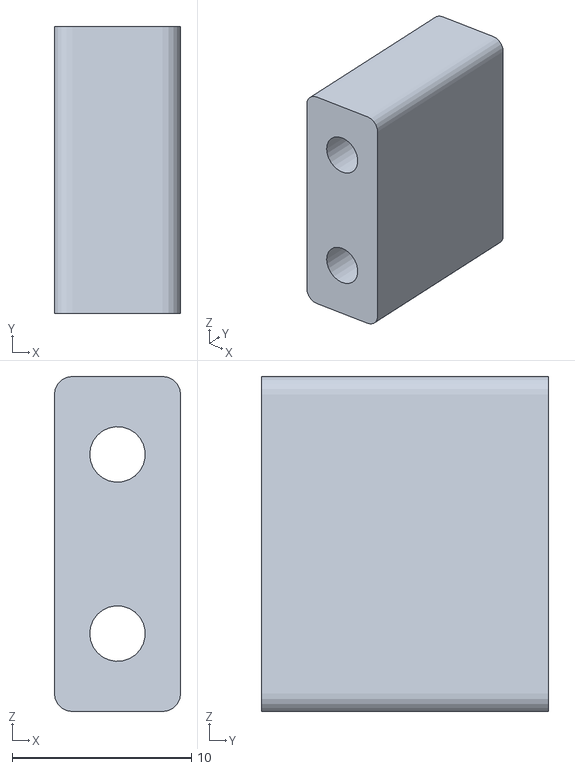
[picture p124: CAD file, 2025-09-23]
Cheburashka_construction/face/лицо/креп_сервы2.stl
7.05 x 16.0 x 18.7
