Ejenie/Cheburashka/Cheburashka_construction/korpus/резать и печатать/шест2.stp

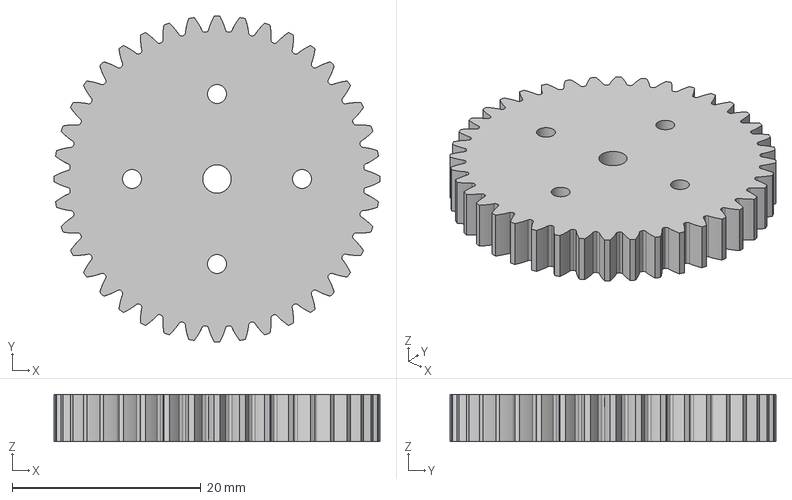
[picture p126: CAD file, 2025-09-23]
Cheburashka_construction/korpus/резать и печатать/шест2.stp
34.5 x 34.5 x 5.00 mm
