Ejenie/Cheburashka/Cheburashka_construction/korpus/шест1+prost.stl

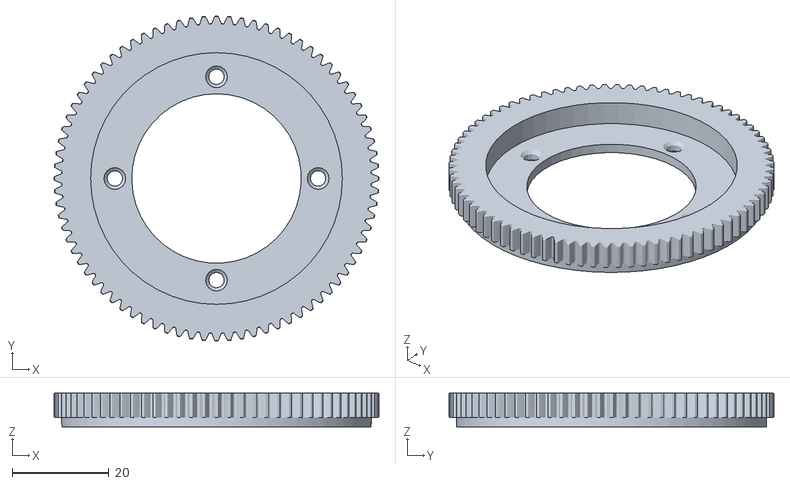
[picture p127: CAD file, 2025-09-23]
Cheburashka_construction/korpus/шест1+prost.stl
67.1 x 67.1 x 7.00
