Ejenie/Cheburashka/Cheburashka_construction/platform/legs/шестерня12-china.stp

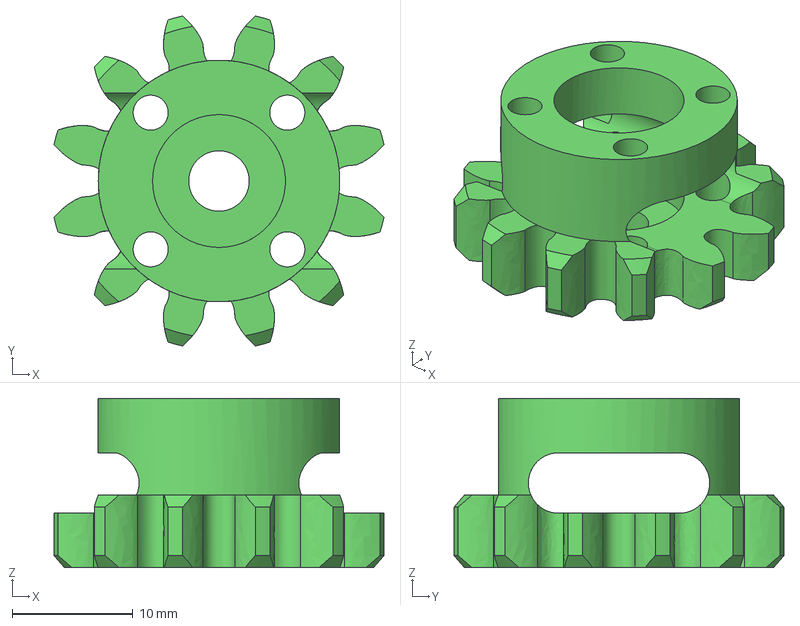
[picture p128: CAD file, 2026-10-02]
Cheburashka_construction/platform/legs/шестерня12-china.stp
27.3 x 27.3 x 14.0 mm
