Ejenie/Cheburashka/Cheburashka_construction/platform/print/v2_4мм_поперечная_меньш.dxf

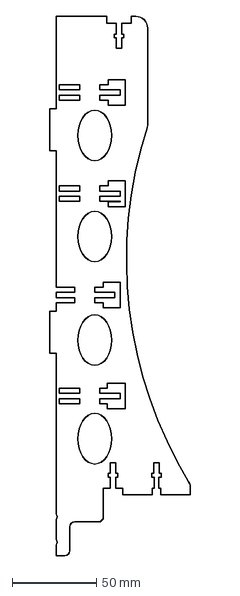
[picture p129: CAD file, 2025-02-10]
Cheburashka_construction/platform/print/v2_4мм_поперечная_меньш.dxf
83.6 x 320.0 mm
