Ejenie/Cheburashka/Cheburashka_construction/platform/шатун22.stl

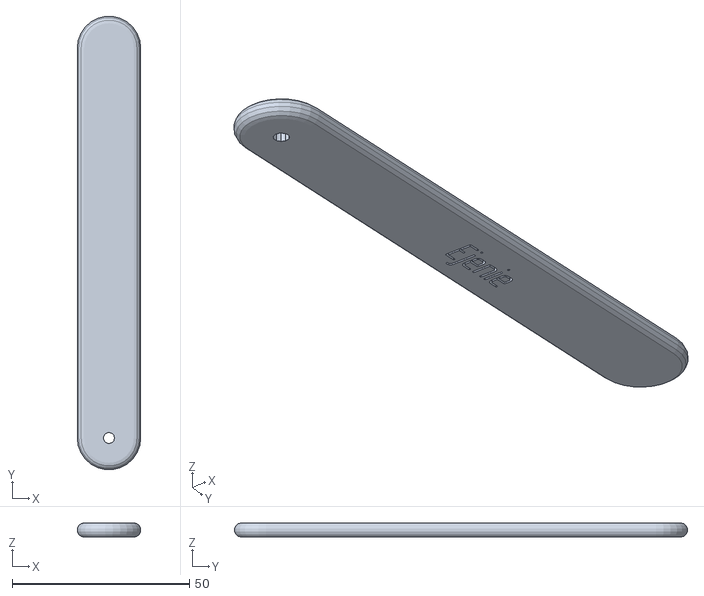
[picture p130: CAD file, 2025-04-13]
Cheburashka_construction/platform/шатун22.stl
17.9 x 127.8 x 4.00
