Ejenie/Cheburashka/Cheburashka_construction/face/лицо/нижний_эллисп.dxf

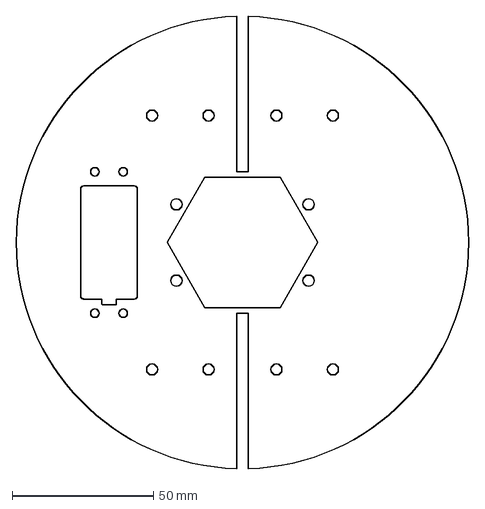
[picture p131: CAD file, 2025-09-23]
Cheburashka_construction/face/лицо/нижний_эллисп.dxf
160.0 x 159.9 mm
