Ejenie/Cheburashka/Cheburashka_construction/korpus/arduino-mega-2650-1.snapshot.2/arduino MEGA2650/cd1206 diode.SLDPRT

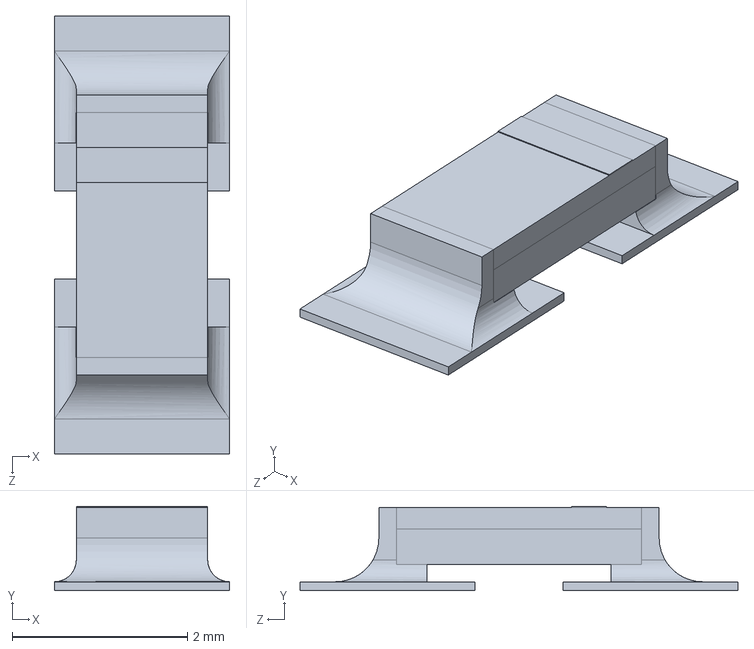
[picture p132: CAD file, 2025-01-25]
Cheburashka_construction/korpus/arduino-mega-2650-1.snapshot.2/arduino MEGA2650/cd1206 diode.SLDPRT
2.00 x 0.96 x 5.00 mm
