Ejenie/Cheburashka/Cheburashka_construction/platform/legs/втулка_5-4.stp

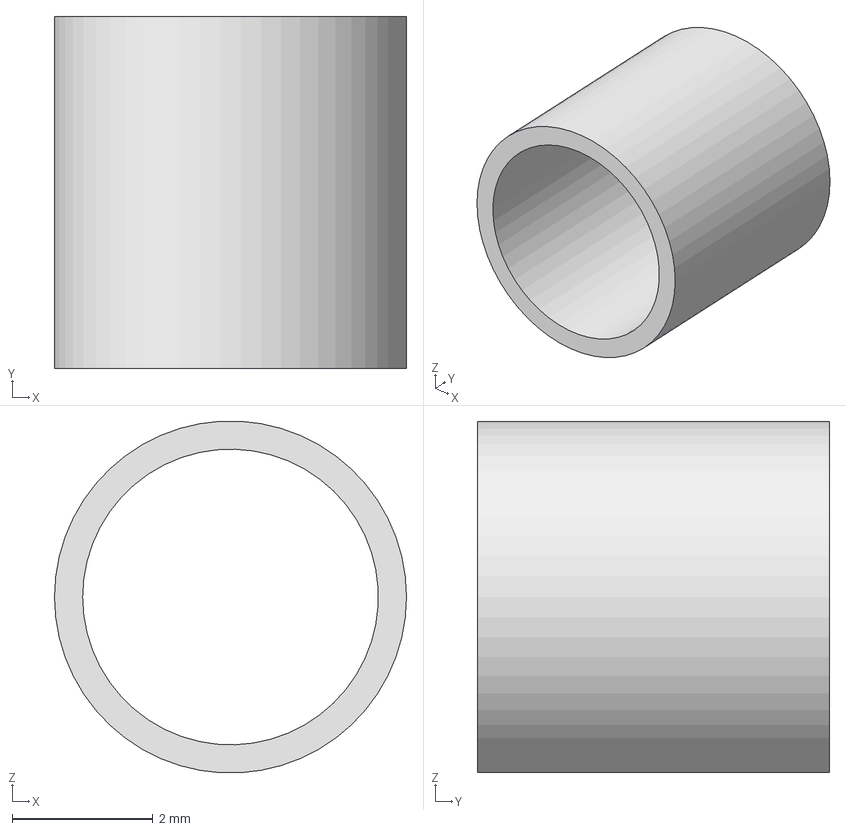
[picture p133: CAD file, 2026-10-02]
Cheburashka_construction/platform/legs/втулка_5-4.stp
5.00 x 5.00 x 4.99 mm
