Ejenie/Cheburashka/Cheburashka_construction/platform/print/v2_4мм_главное_ребро.dxf

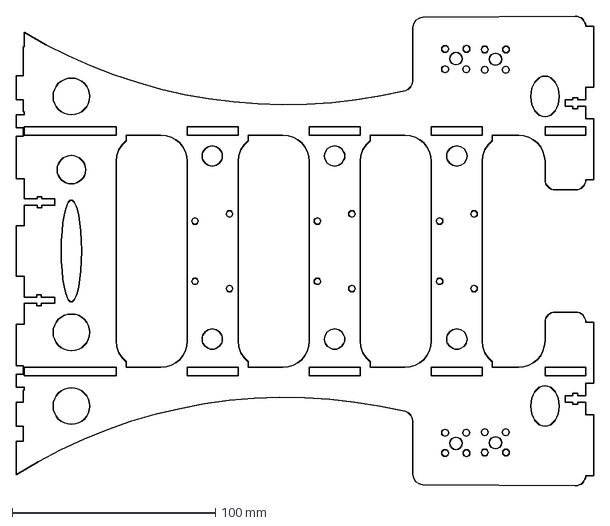
[picture p134: CAD file, 2025-02-10]
Cheburashka_construction/platform/print/v2_4мм_главное_ребро.dxf
284.0 x 230.8 mm
