Ejenie/Cheburashka/Cheburashka_construction/platform/гриб.stl

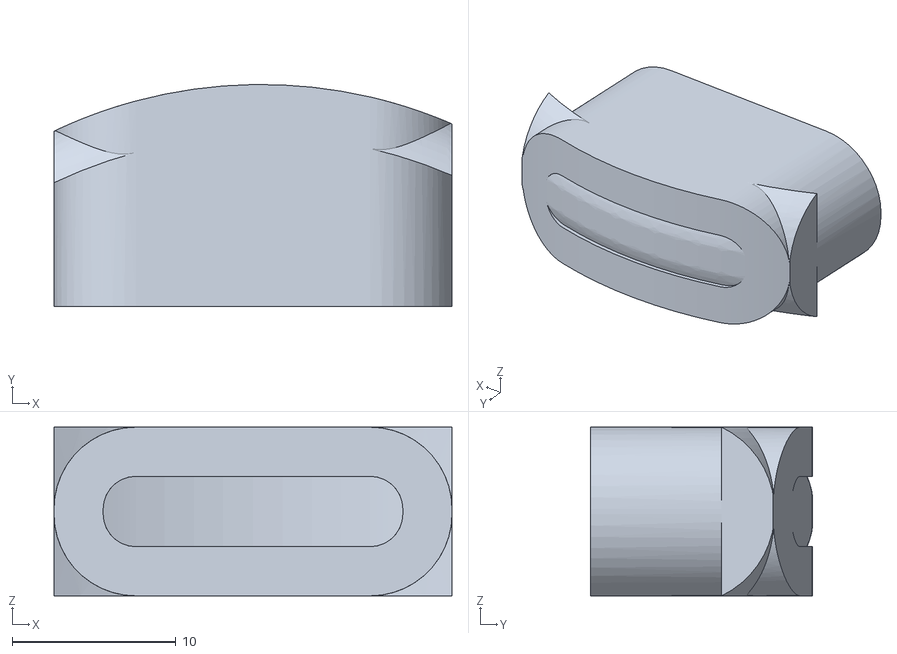
[picture p135: CAD file, 2025-02-10]
Cheburashka_construction/platform/гриб.stl
24.3 x 13.5 x 10.3
