Ejenie/Cheburashka/Cheburashka_construction/face/лицо/креп_сервы.3mf

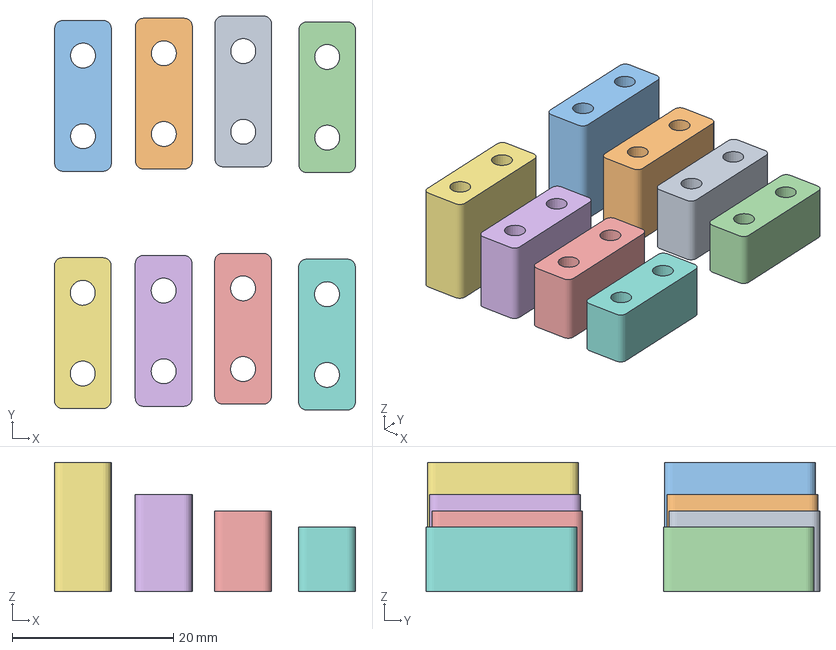
[picture p136: CAD file, 2025-09-23]
Cheburashka_construction/face/лицо/креп_сервы.3mf
37.3 x 48.8 x 16.0 mm
креп_сервы.stl x 2
креп_сервы1.stl x 2
креп_сервы2.stl x 2
креп_сервы3.stl x 2
