Ejenie/Cheburashka/Cheburashka_construction/korpus/arduino-mega-2650-1.snapshot.2/arduino MEGA2650/usb btm contact.SLDPRT

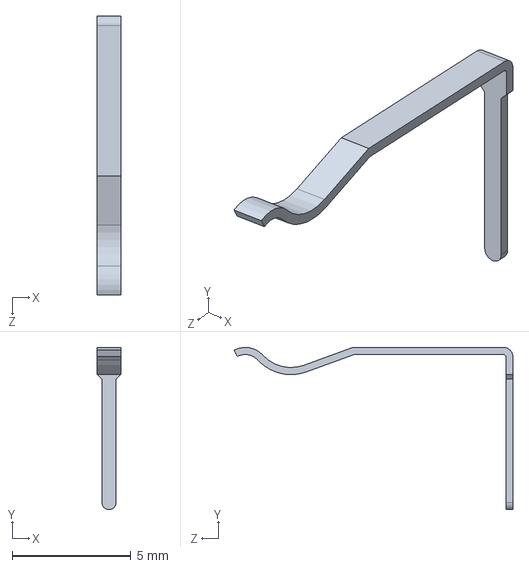
[picture p137: CAD file, 2025-01-25]
Cheburashka_construction/korpus/arduino-mega-2650-1.snapshot.2/arduino MEGA2650/usb btm contact.SLDPRT
1.00 x 6.84 x 11.8 mm
