Ejenie/Cheburashka/Cheburashka_construction/korpus/шест1.stp

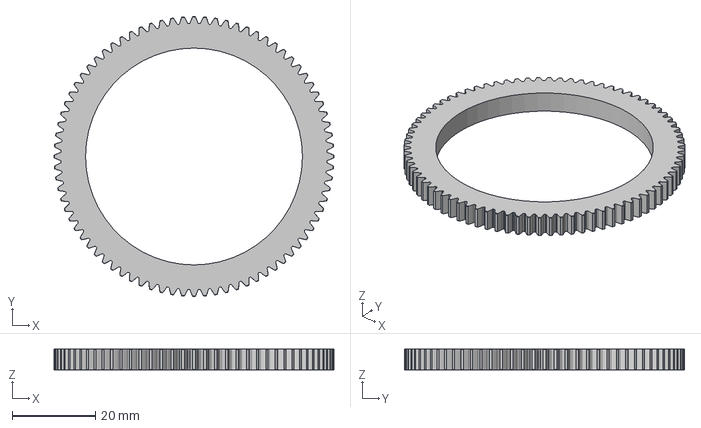
[picture p138: CAD file, 2025-08-16]
Cheburashka_construction/korpus/шест1.stp
67.1 x 67.1 x 5.00 mm
