Ejenie/Cheburashka/Cheburashka_construction/platform/legs/шестерня12_v3.stl

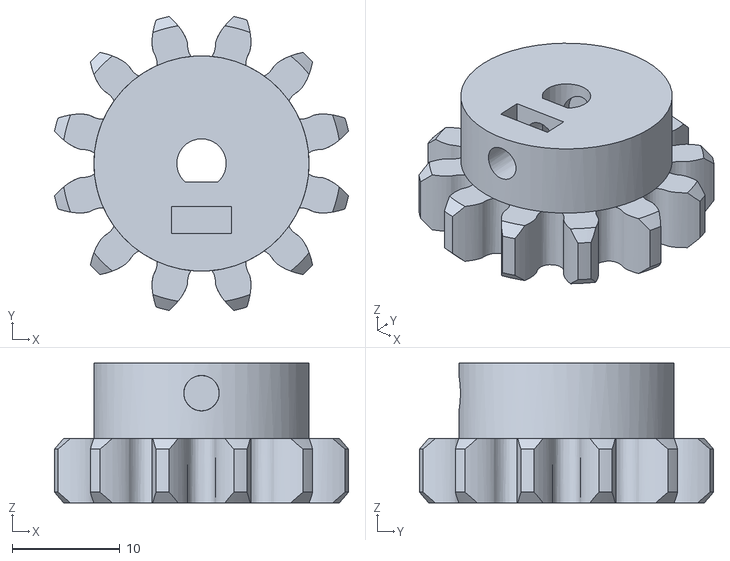
[picture p139: CAD file, 2025-10-22]
Cheburashka_construction/platform/legs/шестерня12_v3.stl
27.3 x 27.3 x 13.0
