Ejenie/Cheburashka/Cheburashka_construction/platform/print/v2_3мм_полка.dxf

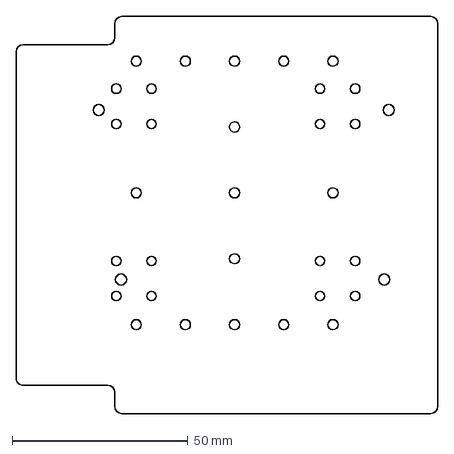
[picture p140: CAD file, 2025-02-10]
Cheburashka_construction/platform/print/v2_3мм_полка.dxf
120.0 x 113.0 mm
