Ejenie/Cheburashka/Cheburashka_construction/face/лицо/креп_сервы1.stl

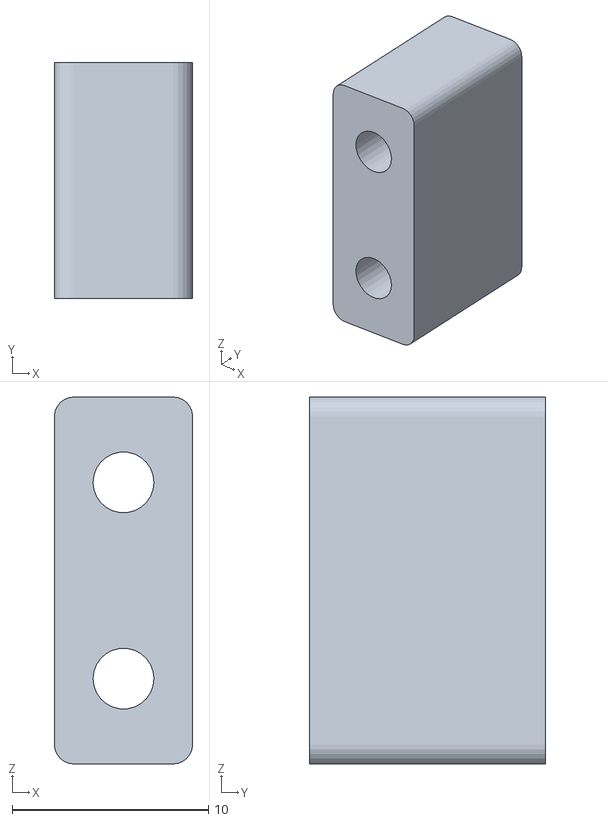
[picture p141: CAD file, 2025-09-23]
Cheburashka_construction/face/лицо/креп_сервы1.stl
7.05 x 12.0 x 18.7
