Ejenie/Cheburashka/Cheburashka_construction/korpus/arduino-mega-2650-1.snapshot.2/arduino MEGA2650/47uf CAP Dcase.SLDPRT

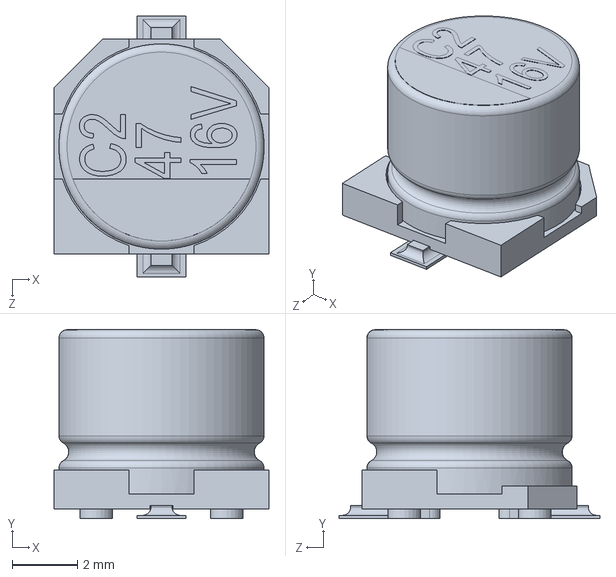
[picture p142: CAD file, 2025-01-25]
Cheburashka_construction/korpus/arduino-mega-2650-1.snapshot.2/arduino MEGA2650/47uf CAP Dcase.SLDPRT
6.60 x 5.81 x 8.00 mm
