Ejenie/Cheburashka/Cheburashka_construction/korpus/держатель.3mf

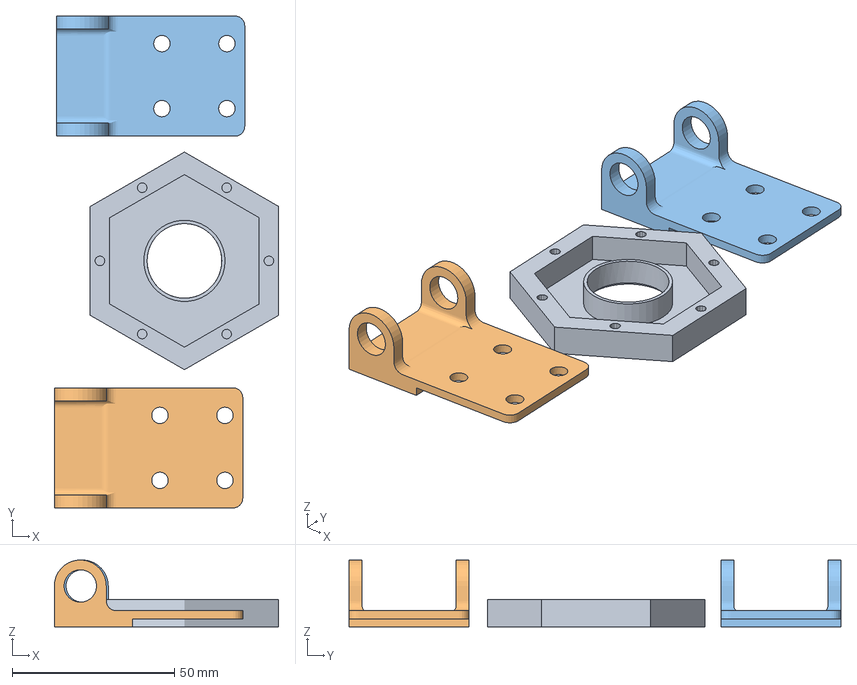
[picture p144: CAD file, 2025-08-16]
Cheburashka_construction/korpus/держатель.3mf
69.0 x 151.4 x 20.6 mm
держатель.stl
myBering.stl
myBering_MIR.stl
