Ejenie/Cheburashka/Cheburashka_construction/korpus/резать и печатать/нижний_эллипс_лица_v3.dxf

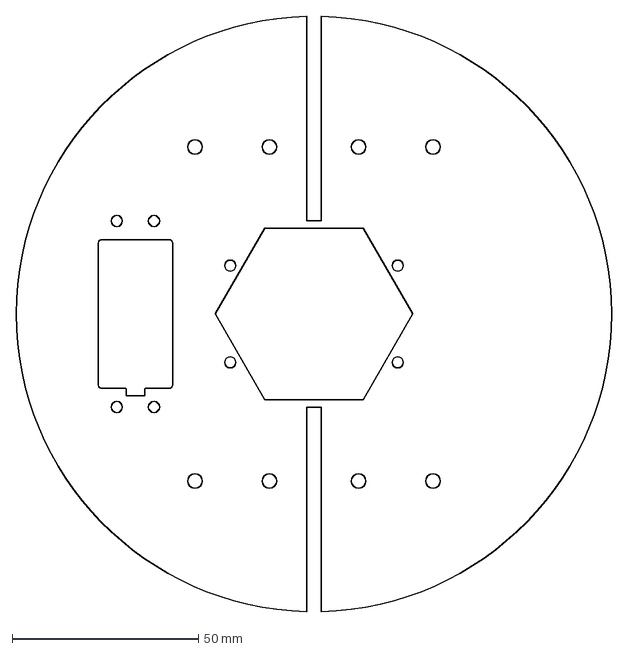
[picture p145: CAD file, 2025-08-16]
Cheburashka_construction/korpus/резать и печатать/нижний_эллипс_лица_v3.dxf
160.0 x 159.9 mm
