Ejenie/Cheburashka/Cheburashka_construction/platform/8bc17c1464c21f56fb2a3979b7c6b729.STEP

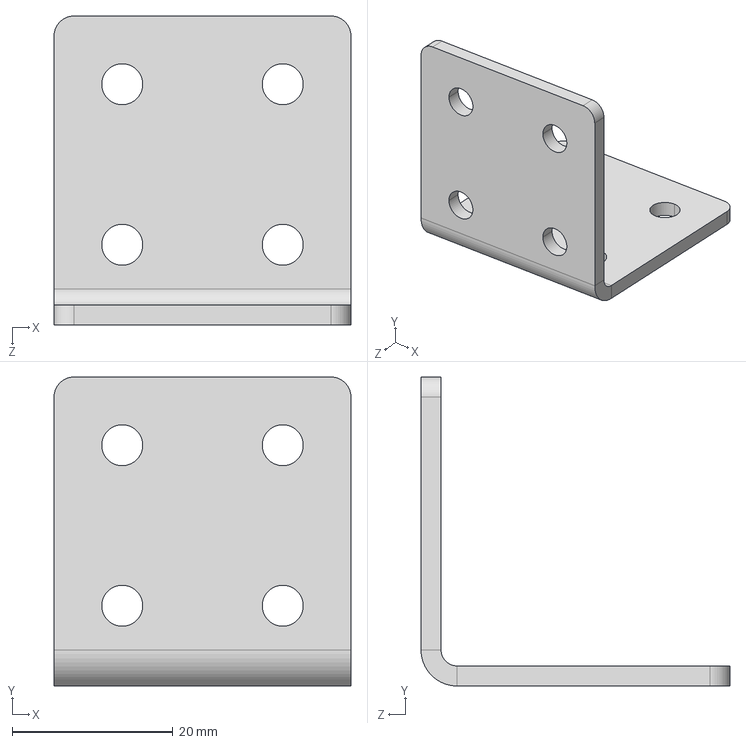
[picture p146: CAD file, 2024-12-27]
Cheburashka_construction/platform/8bc17c1464c21f56fb2a3979b7c6b729.STEP
37.0 x 38.5 x 38.5 mm
