Ejenie/Cheburashka/Cheburashka_construction/platform/legs/цил2.stl

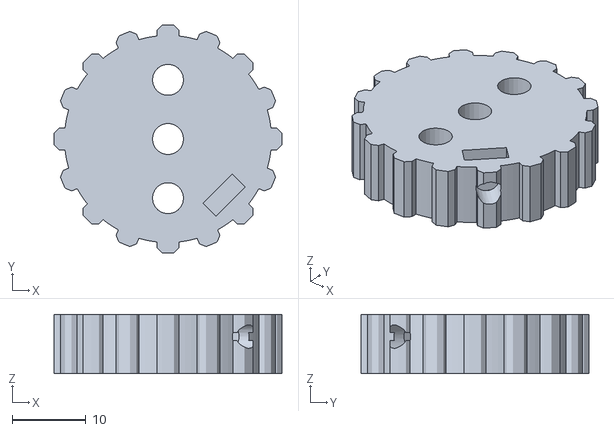
[picture p147: CAD file, 2025-10-22]
Cheburashka_construction/platform/legs/цил2.stl
30.8 x 30.8 x 8.00
