Ejenie/Cheburashka/Cheburashka_construction/platform/print/bobыshka.stl

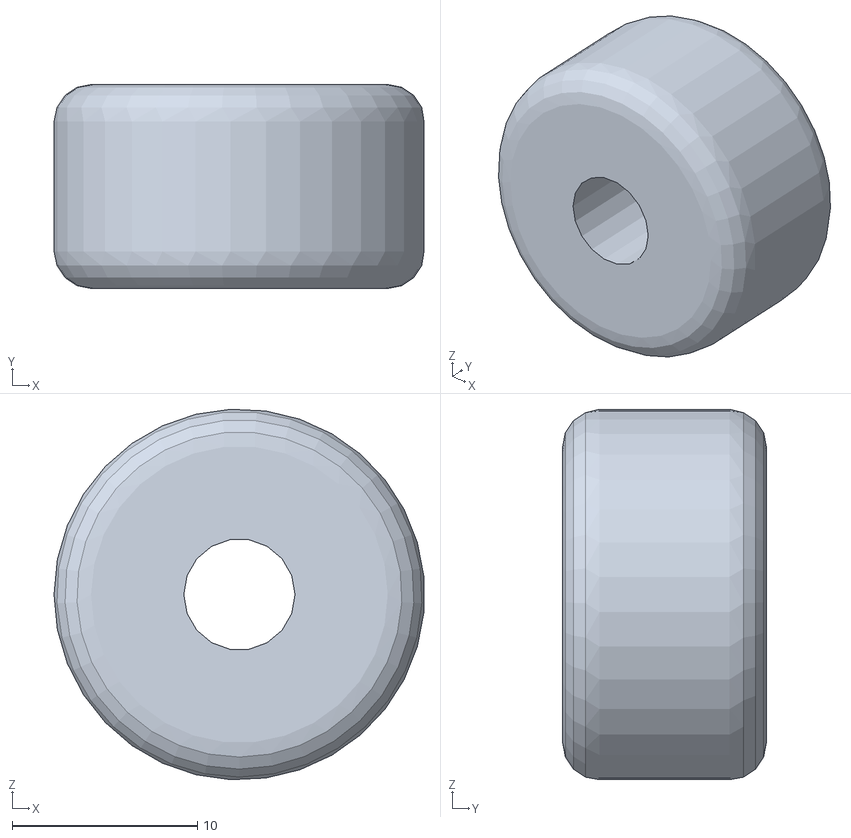
[picture p148: CAD file, 2025-01-13]
Cheburashka_construction/platform/print/bobыshka.stl
20.0 x 11.0 x 20.0
