Ejenie/Cheburashka/Cheburashka_construction/face/лицо/креп_сервы3.stl

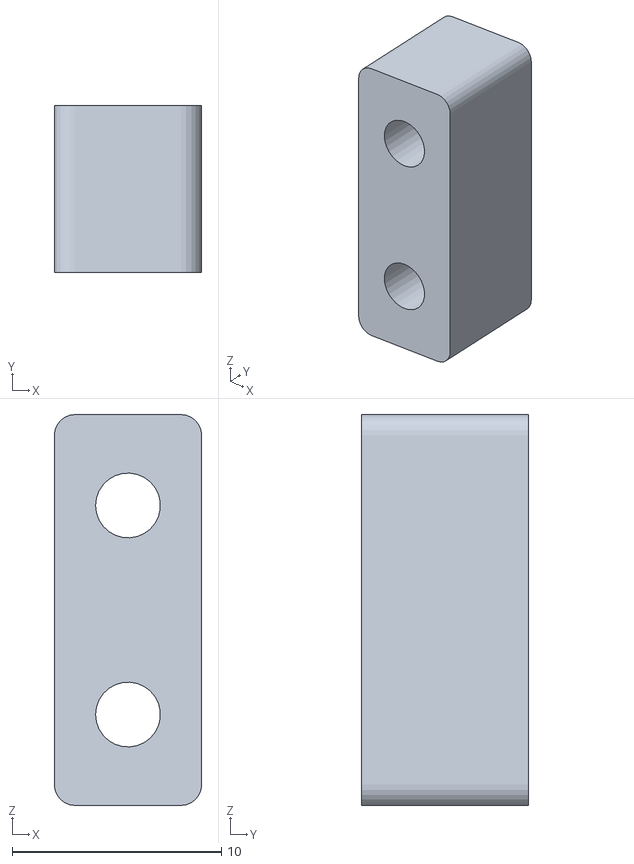
[picture p149: CAD file, 2025-09-23]
Cheburashka_construction/face/лицо/креп_сервы3.stl
7.05 x 8.00 x 18.7
