Ejenie/Cheburashka/Cheburashka_construction/korpus/arduino-mega-2650-1.snapshot.2/arduino MEGA2650/102 RESISTOR PACK.SLDPRT

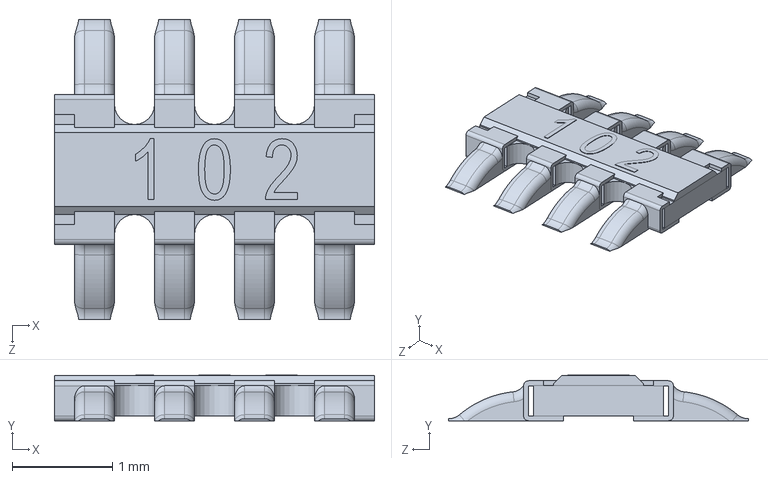
[picture p150: CAD file, 2025-01-25]
Cheburashka_construction/korpus/arduino-mega-2650-1.snapshot.2/arduino MEGA2650/102 RESISTOR PACK.SLDPRT
3.20 x 0.455 x 3.00 mm
