Ejenie/Cheburashka/Cheburashka_construction/korpus/Prostavka.stl

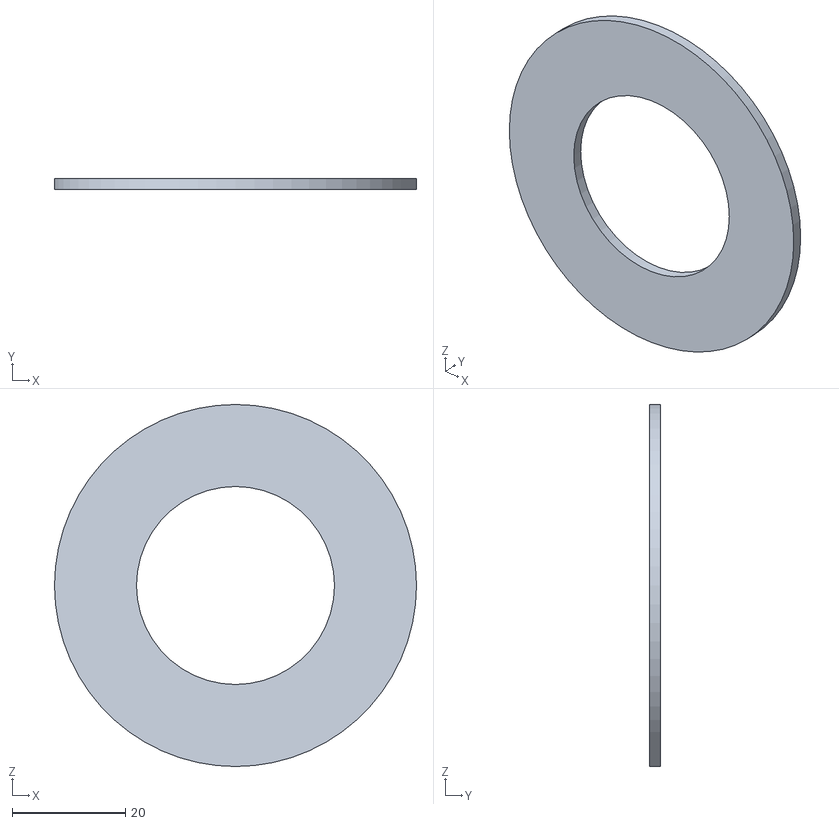
[picture p151: CAD file, 2025-08-16]
Cheburashka_construction/korpus/Prostavka.stl
64.0 x 2.00 x 64.0
