Ejenie/Cheburashka/Cheburashka_construction/korpus/резать и печатать/ось_мини_подшипника.3mf

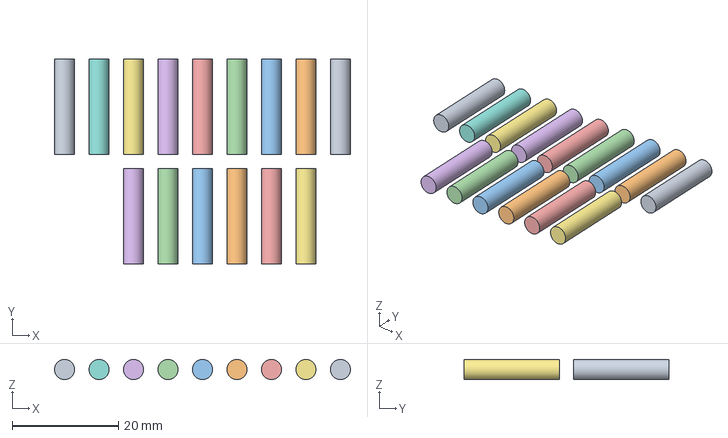
[picture p152: CAD file, 2025-04-13]
Cheburashka_construction/korpus/резать и печатать/ось_мини_подшипника.3mf
55.8 x 38.7 x 3.80 mm
ось_мини_подшипника.stl x 15
