Ejenie/Cheburashka/Cheburashka_construction/platform/4ad8d019baf454c6bbd45c2c6ffb6783.STEP

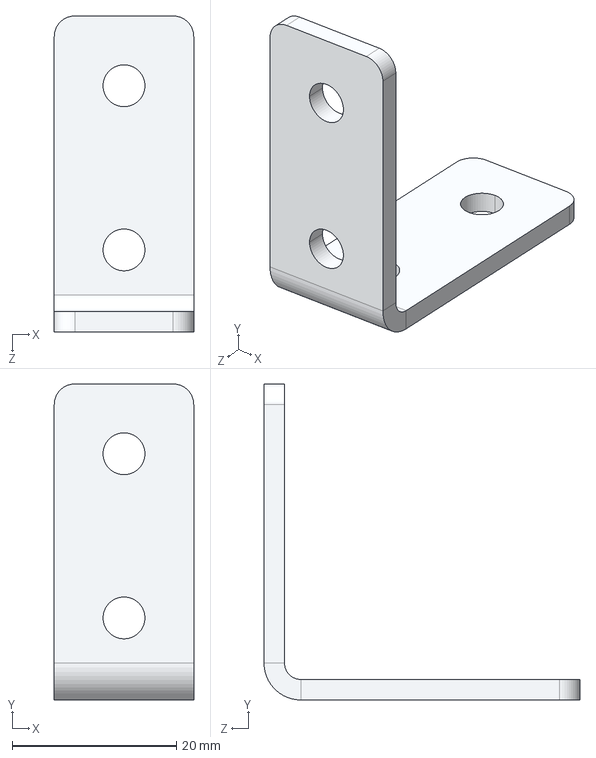
[picture p153: CAD file, 2024-12-27]
Cheburashka_construction/platform/4ad8d019baf454c6bbd45c2c6ffb6783.STEP
17.0 x 38.5 x 38.5 mm
