Ejenie/Cheburashka/Cheburashka_construction/platform/print/мотор_колесо.dxf

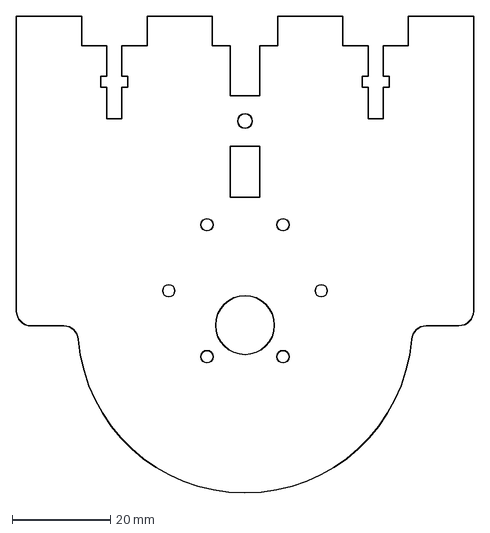
[picture p154: CAD file, 2025-01-13]
Cheburashka_construction/platform/print/мотор_колесо.dxf
93.0 x 97.0 mm
