Ejenie/Cheburashka/Cheburashka_construction/face/лицо/рамка_право.dxf

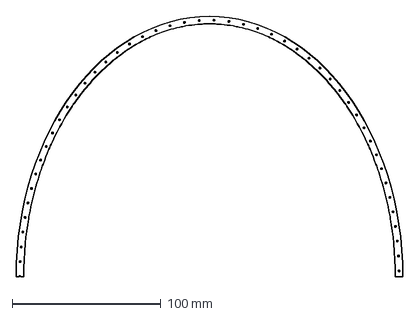
[picture p155: CAD file, 2025-04-13]
Cheburashka_construction/face/лицо/рамка_право.dxf
260.0 x 175.0 mm
