Ejenie/Cheburashka/Cheburashka_construction/korpus/кроватка.3mf

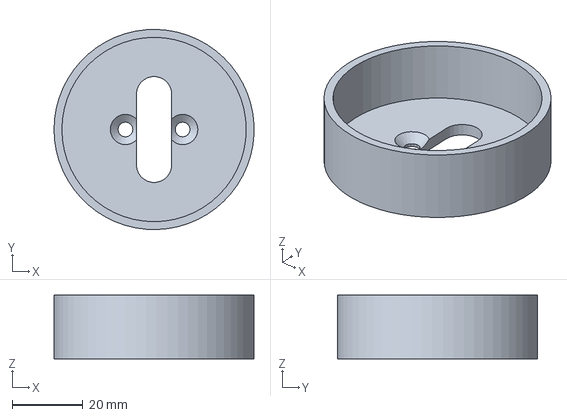
[picture p158: CAD file, 2025-04-13]
Cheburashka_construction/korpus/кроватка.3mf
56.6 x 56.7 x 18.0 mm
