Ejenie/Cheburashka/Cheburashka_construction/korpus/резать и печатать/парус2.stl

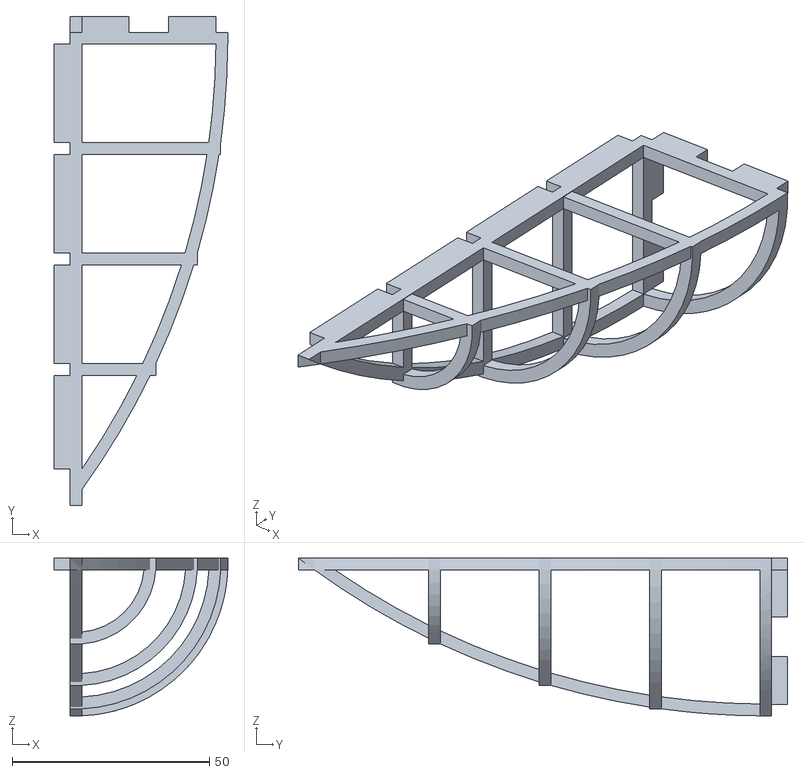
[picture p159: CAD file, 2025-02-10]
Cheburashka_construction/korpus/резать и печатать/парус2.stl
44.0 x 124.0 x 40.0
