Ejenie/Cheburashka/Cheburashka_construction/platform/067a8e69ecd876a8a01cde7d0ae1fd89.STEP

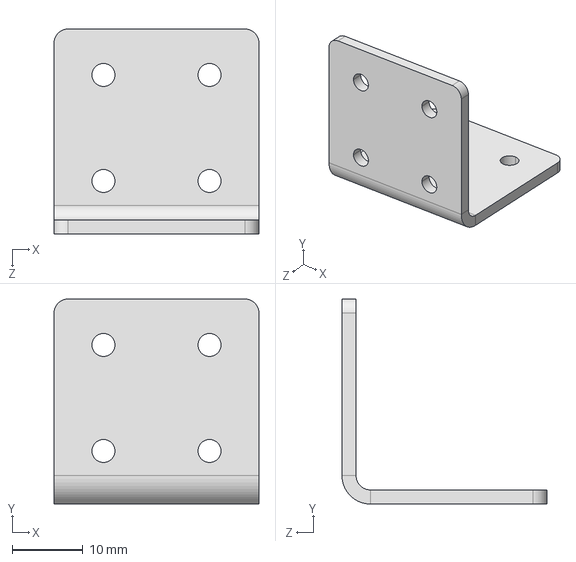
[picture p160: CAD file, 2024-12-27]
Cheburashka_construction/platform/067a8e69ecd876a8a01cde7d0ae1fd89.STEP
29.0 x 29.0 x 29.0 mm
