Ejenie/Cheburashka/Cheburashka_construction/platform/legs/цил1.stl

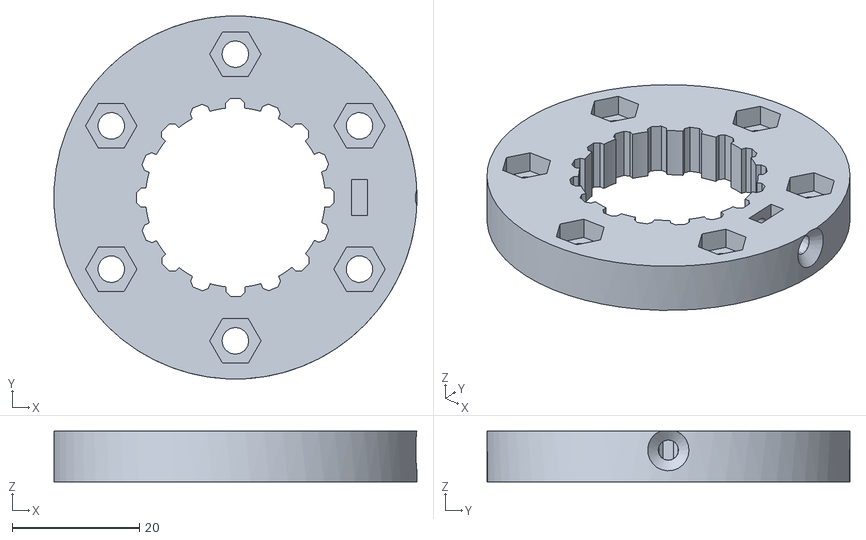
[picture p161: CAD file, 2025-10-22]
Cheburashka_construction/platform/legs/цил1.stl
57.0 x 57.0 x 8.00
