Ejenie/Cheburashka/Cheburashka_construction/platform/print/мотор_крышка.dxf

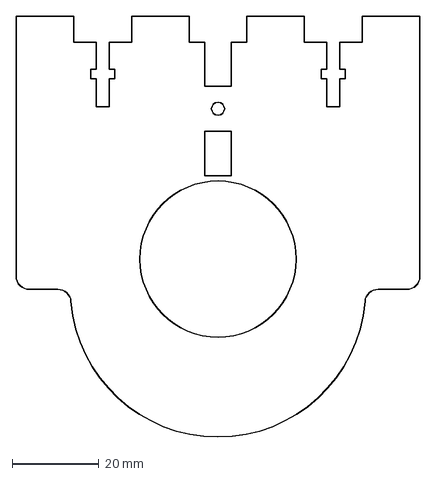
[picture p162: CAD file, 2025-01-13]
Cheburashka_construction/platform/print/мотор_крышка.dxf
93.0 x 97.0 mm
