Ejenie/Cheburashka/Cheburashka_construction/face/лицо/рамка_левое.dxf

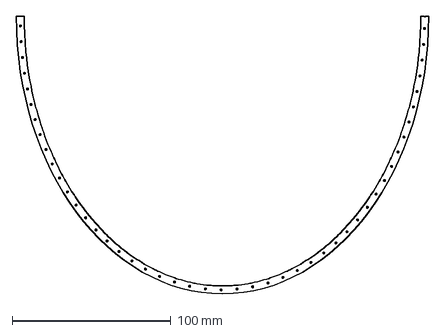
[picture p163: CAD file, 2025-04-13]
Cheburashka_construction/face/лицо/рамка_левое.dxf
260.0 x 175.0 mm
