Ejenie/Cheburashka/Cheburashka_construction/korpus/arduino-mega-2650-1.snapshot.2/arduino MEGA2650/lp2985dgkr.SLDPRT

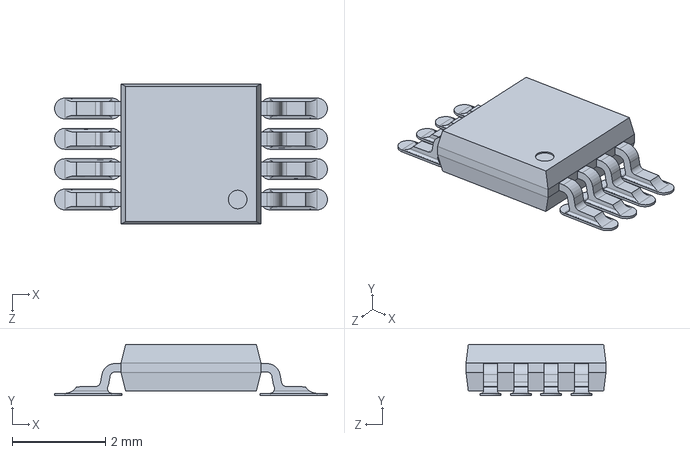
[picture p164: CAD file, 2025-01-25]
Cheburashka_construction/korpus/arduino-mega-2650-1.snapshot.2/arduino MEGA2650/lp2985dgkr.SLDPRT
5.85 x 1.10 x 3.00 mm
