Ejenie/Cheburashka/Cheburashka_construction/korpus/ограничитель.stl

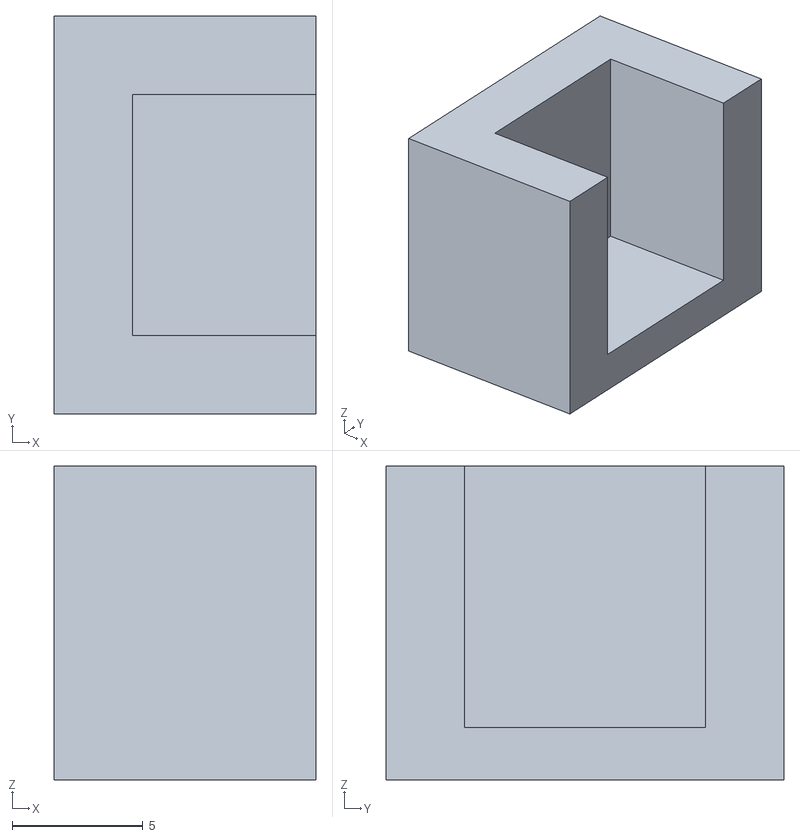
[picture p166: CAD file, 2025-01-27]
Cheburashka_construction/korpus/ограничитель.stl
10.0 x 15.2 x 12.0
