Ejenie/Cheburashka/Cheburashka_construction/korpus/резать и печатать/нижний_эллипс_туловища.dxf

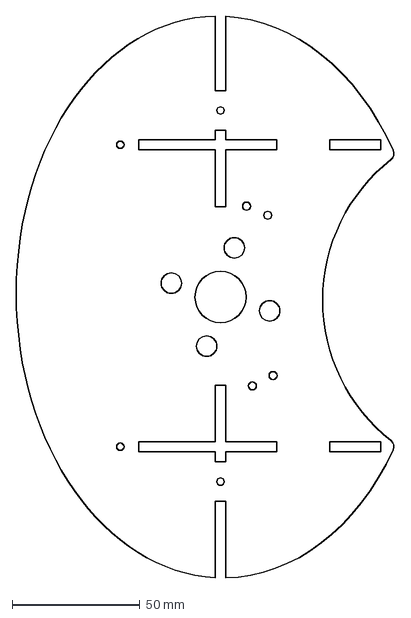
[picture p167: CAD file, 2025-02-10]
Cheburashka_construction/korpus/резать и печатать/нижний_эллипс_туловища.dxf
148.3 x 220.0 mm
