Ejenie/Cheburashka/Cheburashka_construction/platform/L72-T_soedinitel-60kh80.STEP

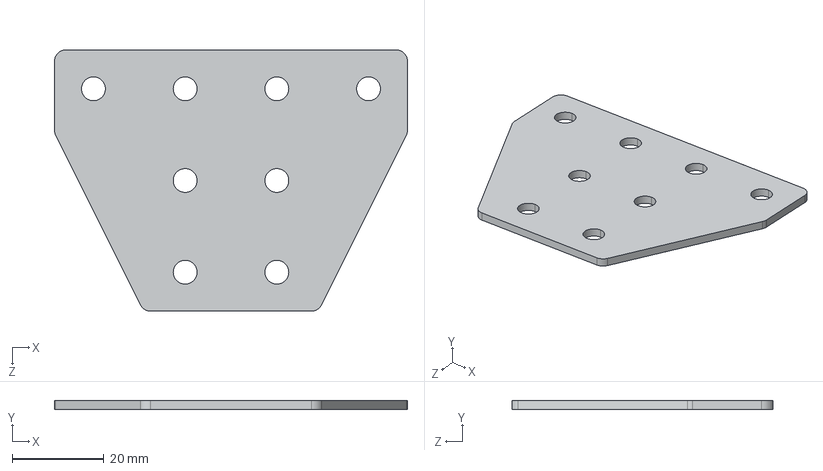
[picture p168: CAD file, 2024-12-27]
Cheburashka_construction/platform/L72-T_soedinitel-60kh80.STEP
77.0 x 2.00 x 57.0 mm
