Ejenie/Cheburashka/Cheburashka_construction/platform/legs/шестерня36_v4.stl

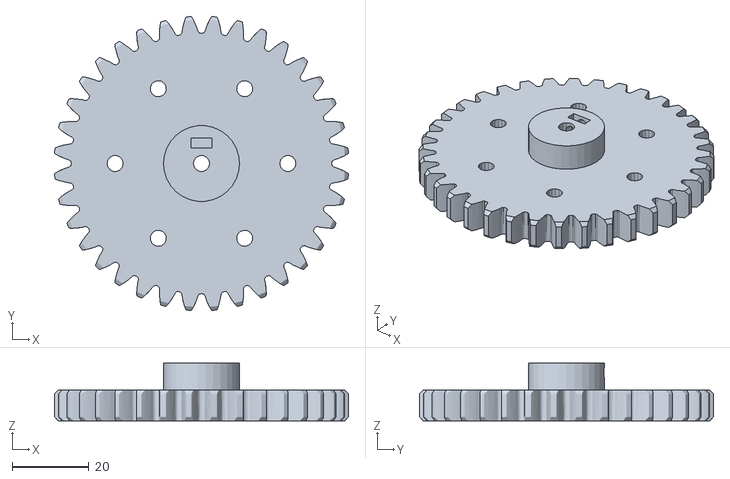
[picture p169: CAD file, 2025-10-22]
Cheburashka_construction/platform/legs/шестерня36_v4.stl
76.6 x 76.6 x 15.0
