Ejenie/Cheburashka/Cheburashka_construction/platform/print/bobыshka1.stl

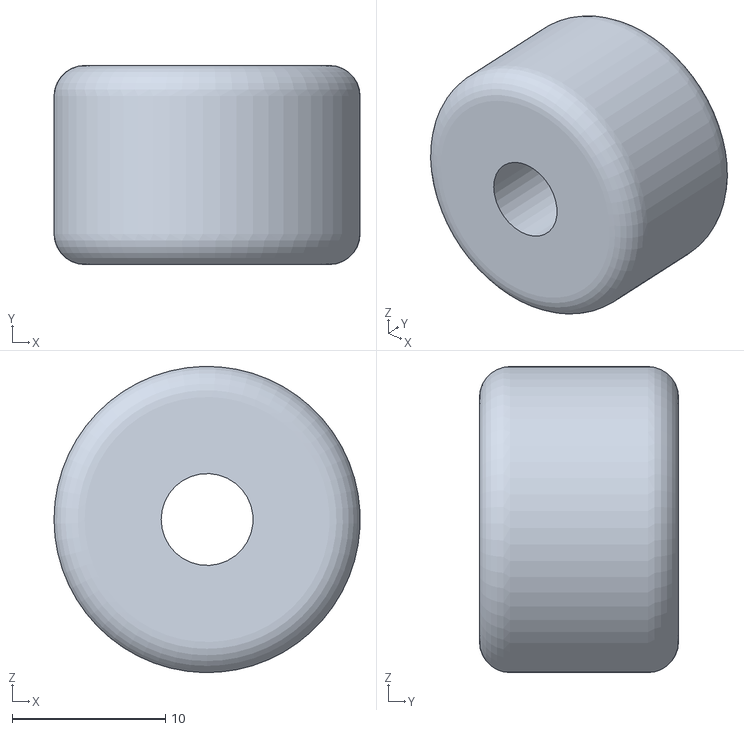
[picture p170: CAD file, 2025-01-13]
Cheburashka_construction/platform/print/bobыshka1.stl
20.0 x 13.0 x 20.0
