Ejenie/Cheburashka/Cheburashka_construction/face/лицо/рамка.dxf

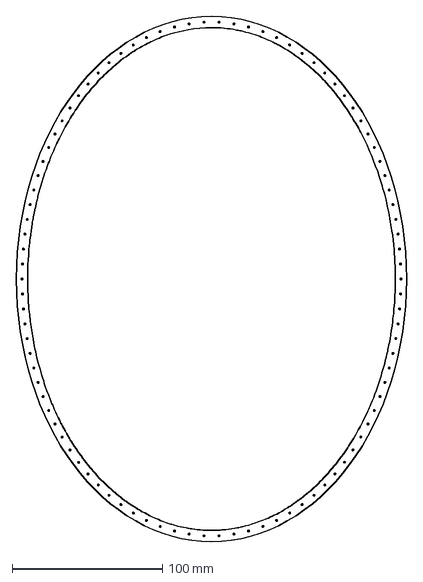
[picture p171: CAD file, 2025-04-13]
Cheburashka_construction/face/лицо/рамка.dxf
260.0 x 350.0 mm
