Ejenie/Cheburashka/Cheburashka_construction/korpus/arduino-mega-2650-1.snapshot.2/arduino MEGA2650/603 cap on pad.SLDPRT

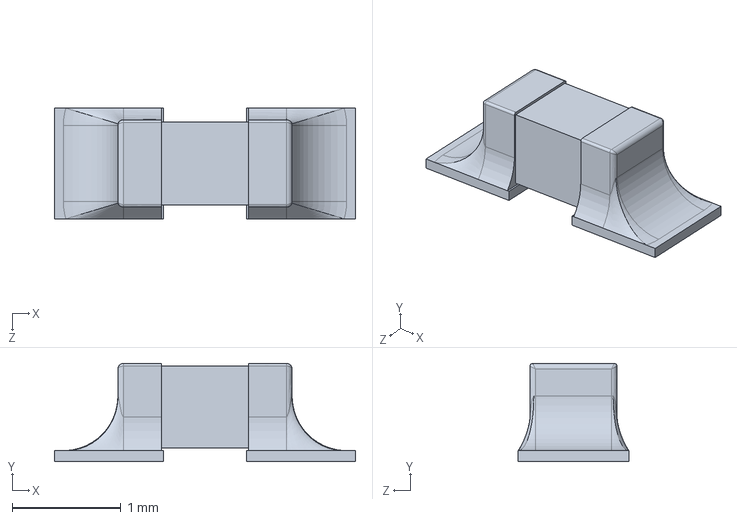
[picture p172: CAD file, 2025-01-25]
Cheburashka_construction/korpus/arduino-mega-2650-1.snapshot.2/arduino MEGA2650/603 cap on pad.SLDPRT
2.76 x 0.9 x 1.02 mm
