Ejenie/Cheburashka/Cheburashka_construction/korpus/Arduino_Mega_2560.stl

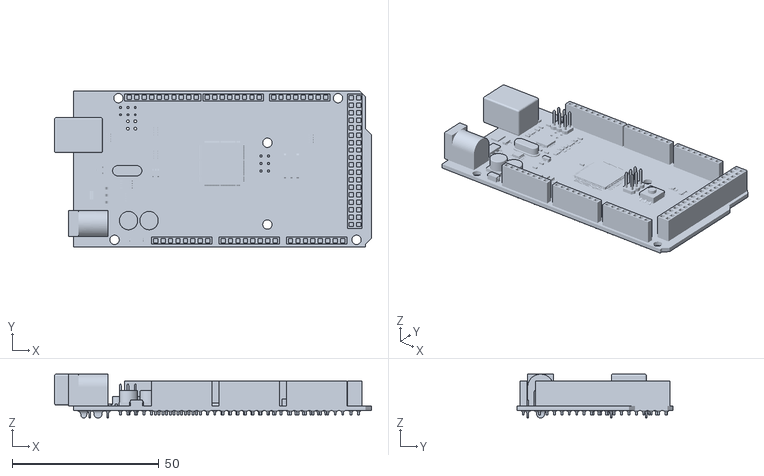
[picture p173: CAD file, 2025-01-21]
Cheburashka_construction/korpus/Arduino_Mega_2560.stl
108.1 x 53.3 x 15.0
