Ejenie/Cheburashka/Cheburashka_construction/korpus/резать и печатать/стенка_4мм.dxf

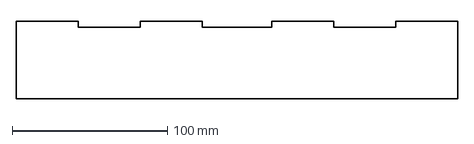
[picture p174: CAD file, 2025-02-10]
Cheburashka_construction/korpus/резать и печатать/стенка_4мм.dxf
285.0 x 50.0 mm
