Ejenie/Cheburashka/Cheburashka_construction/platform/print/колесо1.dxf

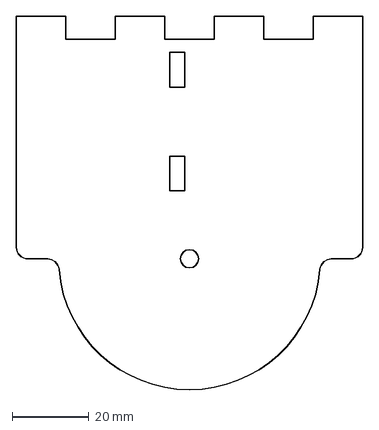
[picture p175: CAD file, 2025-01-13]
Cheburashka_construction/platform/print/колесо1.dxf
90.0 x 97.0 mm
