Ejenie/Cheburashka/Cheburashka_construction/platform/sfg.dxf

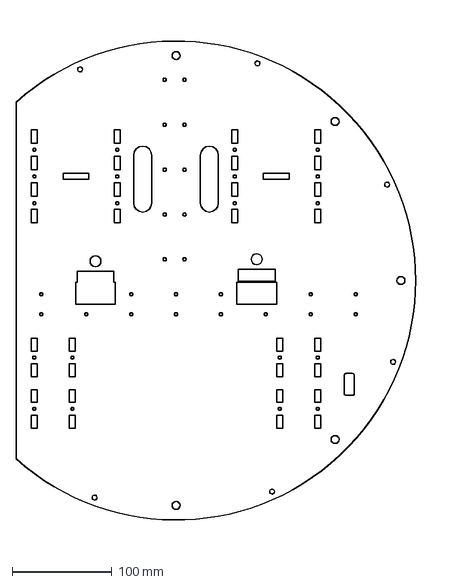
[picture p176: CAD file, 2024-12-24]
Cheburashka_construction/platform/sfg.dxf
422.8 x 529.8 mm
