Ejenie/Cheburashka/Cheburashka_construction/face/лицо/рамка_верх.dxf

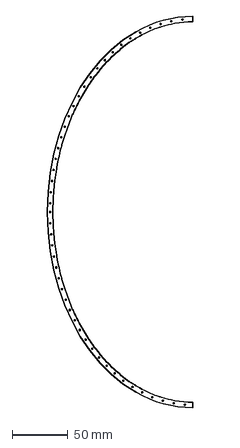
[picture p177: CAD file, 2025-04-13]
Cheburashka_construction/face/лицо/рамка_верх.dxf
130.0 x 350.0 mm
