Ejenie/Cheburashka/Cheburashka_construction/korpus/резать и печатать/рука.dxf

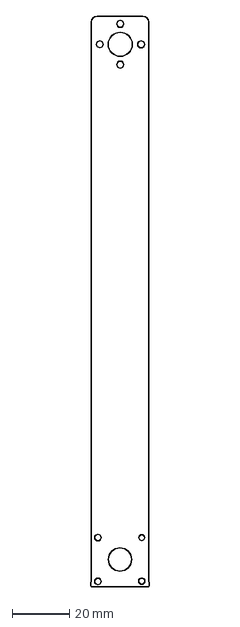
[picture p178: CAD file, 2025-02-10]
Cheburashka_construction/korpus/резать и печатать/рука.dxf
20.7 x 200.0 mm
