Ejenie/Cheburashka/Cheburashka_construction/platform/KRAVT_holder_2 (1).stl

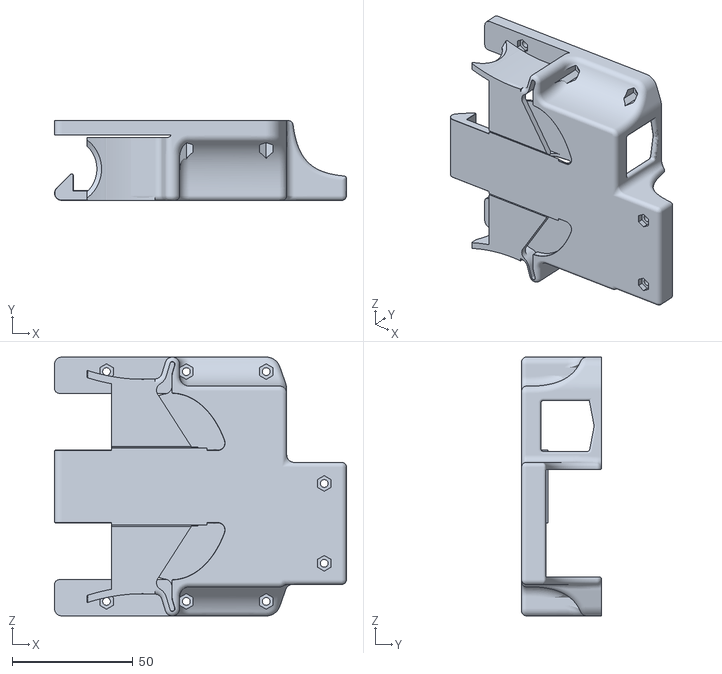
[picture p179: CAD file, 2024-11-07]
Cheburashka_construction/platform/KRAVT_holder_2 (1).stl
120.7 x 33.0 x 107.0
