Ejenie/Cheburashka/Cheburashka_construction/platform/print/поперечная.dxf

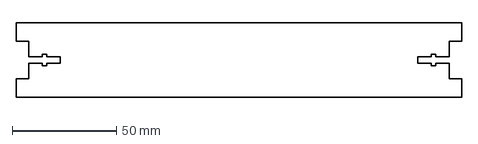
[picture p180: CAD file, 2025-01-13]
Cheburashka_construction/platform/print/поперечная.dxf
213.8 x 36.0 mm
