Ejenie/Cheburashka/Cheburashka_construction/face/лицо/рамка_низ.dxf

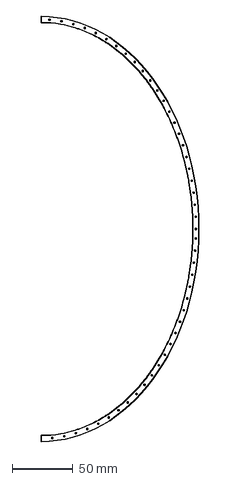
[picture p181: CAD file, 2025-04-13]
Cheburashka_construction/face/лицо/рамка_низ.dxf
130.0 x 350.0 mm
