Ejenie/Cheburashka/Cheburashka_construction/korpus/arduino-mega-2650-1.snapshot.2/arduino MEGA2650/16mhz crystal - measured.SLDPRT

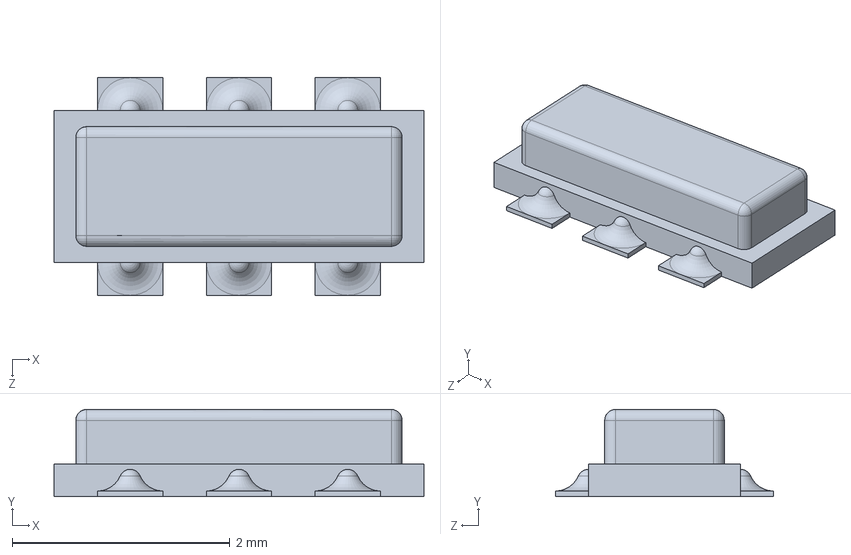
[picture p182: CAD file, 2025-01-25]
Cheburashka_construction/korpus/arduino-mega-2650-1.snapshot.2/arduino MEGA2650/16mhz crystal - measured.SLDPRT
3.40 x 0.8 x 2.00 mm
