Ejenie/Cheburashka/Cheburashka_construction/korpus/резать и печатать/креп_сервы.stl

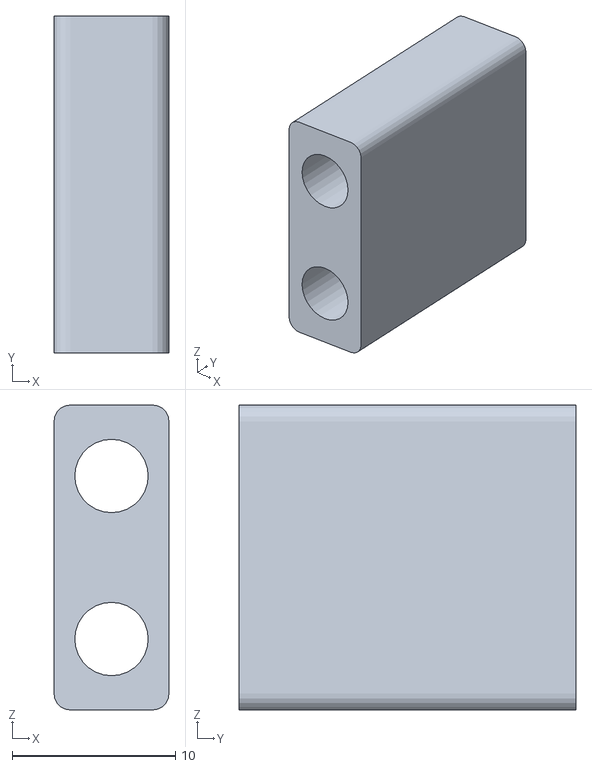
[picture p184: CAD file, 2025-02-10]
Cheburashka_construction/korpus/резать и печатать/креп_сервы.stl
7.05 x 20.7 x 18.7
