Ejenie/Cheburashka/Cheburashka_construction/platform/print/для_колес.dxf

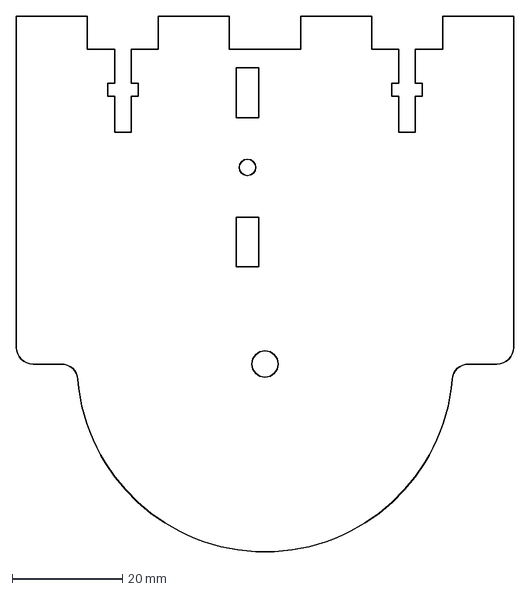
[picture p185: CAD file, 2025-01-13]
Cheburashka_construction/platform/print/для_колес.dxf
90.0 x 97.0 mm
