Ejenie/Cheburashka/Cheburashka_construction/face/лицо/магнит_стойка.stl

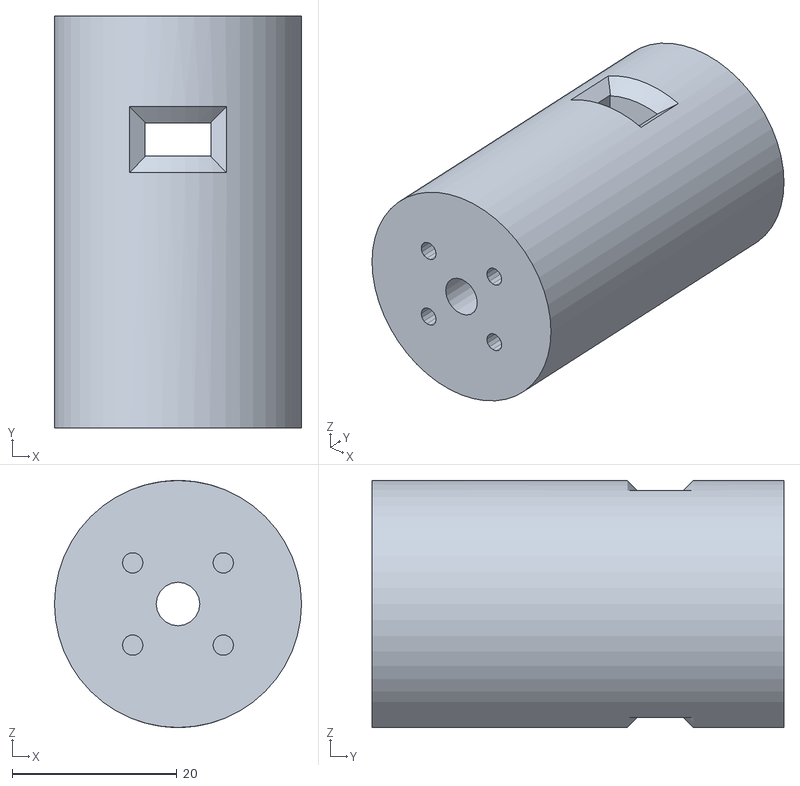
[picture p186: CAD file, 2025-02-10]
Cheburashka_construction/face/лицо/магнит_стойка.stl
30.0 x 50.0 x 30.0
