Ejenie/Cheburashka/Cheburashka_construction/korpus/резать и печатать/v2_3мм_полка.dxf

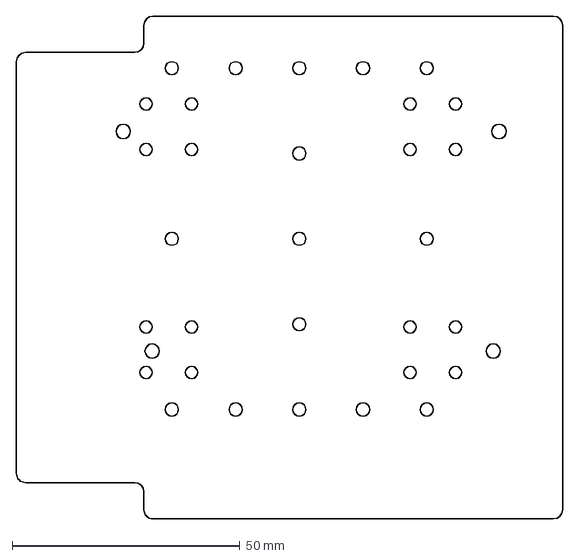
[picture p188: CAD file, 2025-02-10]
Cheburashka_construction/korpus/резать и печатать/v2_3мм_полка.dxf
120.0 x 110.5 mm
