Ejenie/Cheburashka/Cheburashka_construction/platform/print/мотор_поперечная.dxf

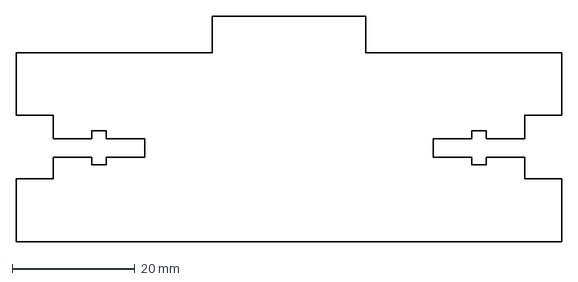
[picture p189: CAD file, 2025-01-13]
Cheburashka_construction/platform/print/мотор_поперечная.dxf
89.0 x 36.9 mm
