Ejenie/Cheburashka/Cheburashka_construction/platform/legs/myBering_v3.stl

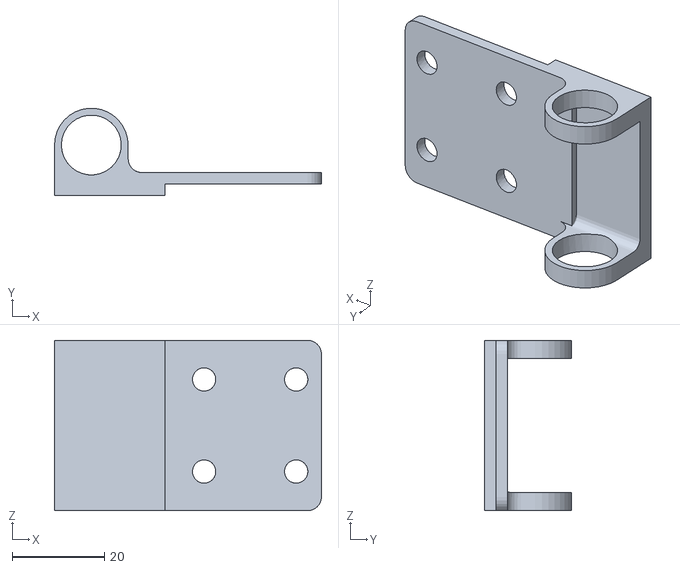
[picture p192: CAD file, 2025-09-23]
Cheburashka_construction/platform/legs/myBering_v3.stl
58.0 x 19.0 x 37.0
