Ejenie/Cheburashka/Cheburashka_construction/platform/print/platform.dxf

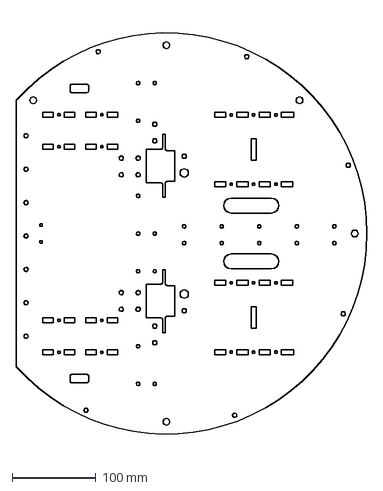
[picture p193: CAD file, 2025-01-13]
Cheburashka_construction/platform/print/platform.dxf
419.9 x 519.5 mm
