Ejenie/Cheburashka/Cheburashka_construction/korpus/резать и печатать/эллипс_плеч_4мм.dxf

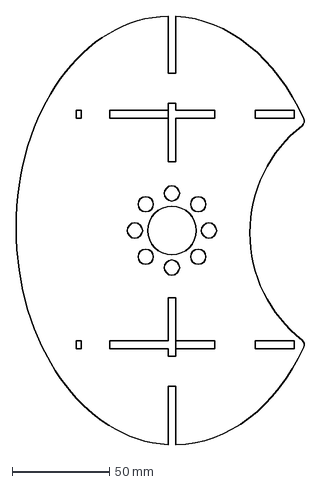
[picture p195: CAD file, 2025-02-10]
Cheburashka_construction/korpus/резать и печатать/эллипс_плеч_4мм.dxf
148.3 x 220.0 mm
