Ejenie/Cheburashka/Cheburashka_construction/platform/print/bobыshka2.stl

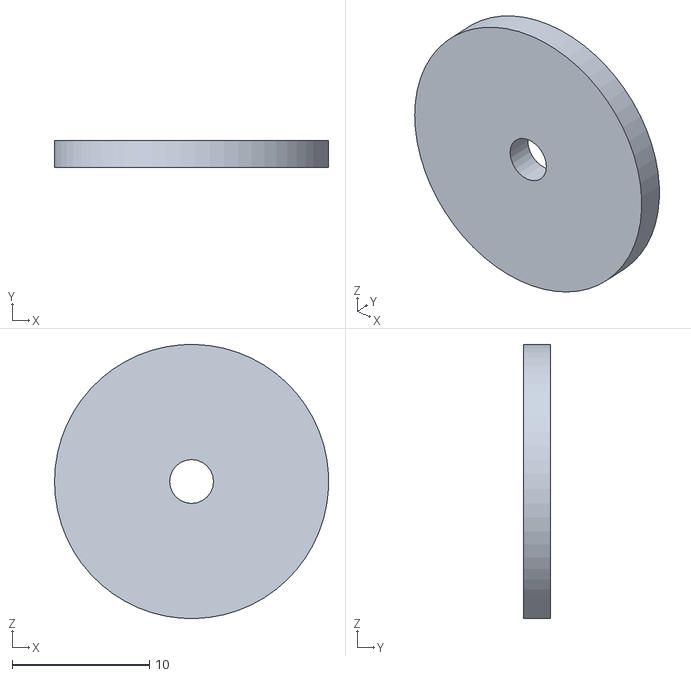
[picture p196: CAD file, 2025-01-13]
Cheburashka_construction/platform/print/bobыshka2.stl
20.0 x 2.00 x 20.0
