Ejenie/Cheburashka/Cheburashka_construction/korpus/arduino-mega-2650-1.snapshot.2/arduino MEGA2650/2pin_header__02.sldprt

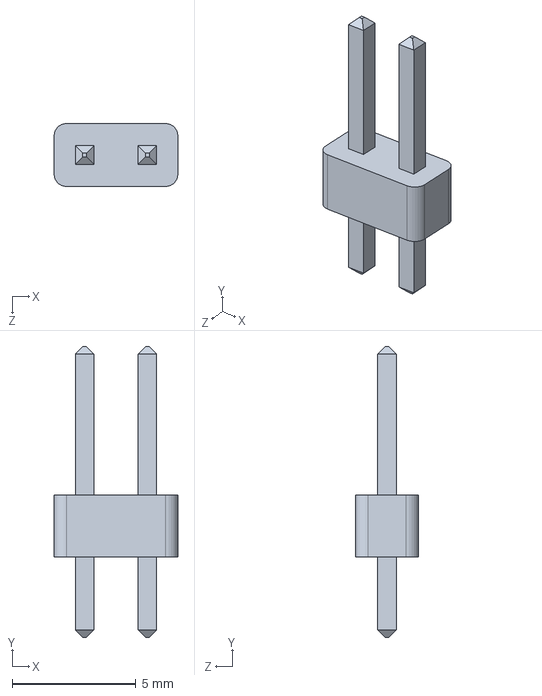
[picture p197: CAD file, 2025-01-25]
Cheburashka_construction/korpus/arduino-mega-2650-1.snapshot.2/arduino MEGA2650/2pin_header__02.sldprt
5.00 x 11.8 x 2.54 mm
