Ejenie/Cheburashka/Cheburashka_construction/korpus/резать и печатать/мини_проставка.stl

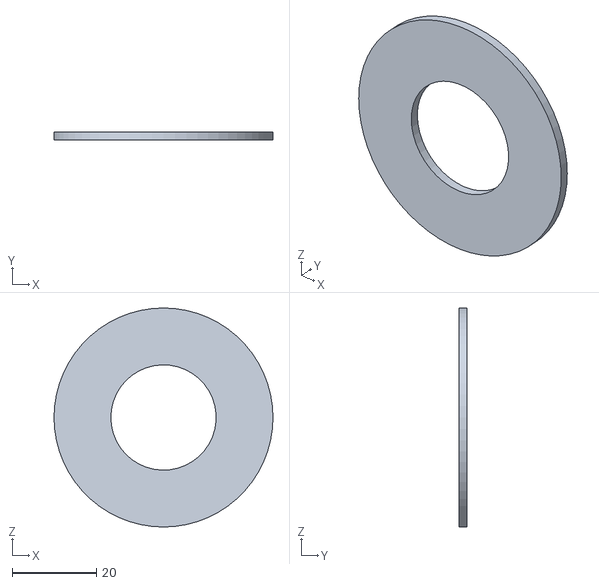
[picture p198: CAD file, 2025-02-10]
Cheburashka_construction/korpus/резать и печатать/мини_проставка.stl
52.0 x 2.00 x 52.0
