Ejenie/Cheburashka/Cheburashka_construction/platform/legs/шестерня12_v2.3mf

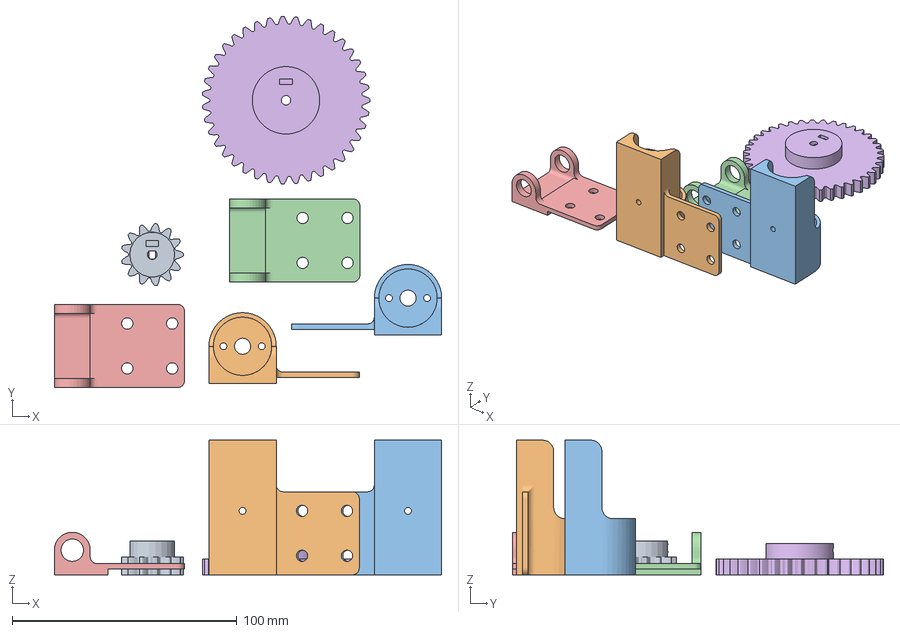
[picture p199: CAD file, 2025-08-20]
Cheburashka_construction/platform/legs/шестерня12_v2.3mf
172.5 x 165.2 x 60.0 mm
шестерня12_v2.stl
myMotorHolder.stl
myMotorHolder_MIR.stl
myBering_v2.stl x 2
шестерня36_v2.stp
