Ejenie/Cheburashka/Cheburashka_construction/korpus/резать и печатать/магнит_стойка.stl

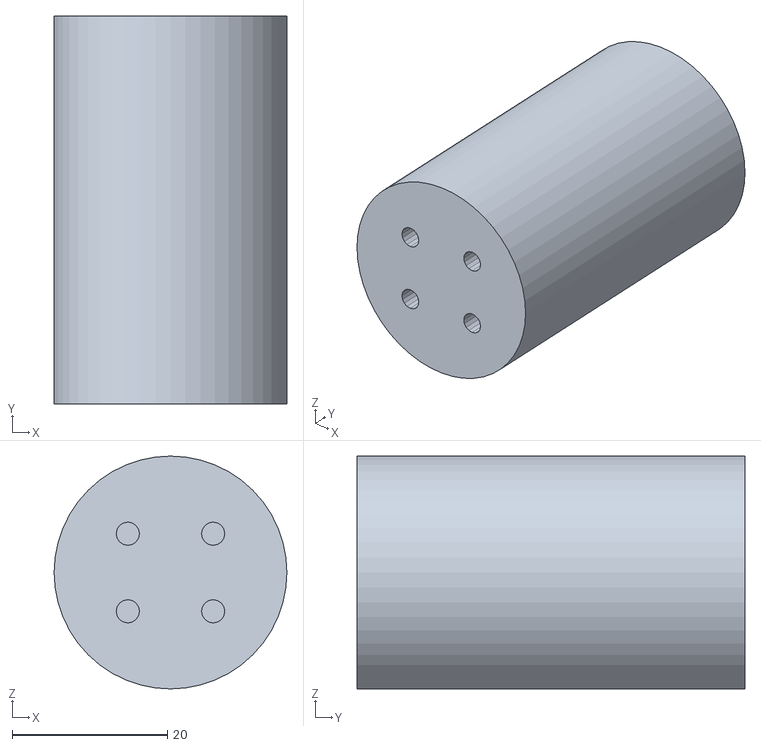
[picture p201: CAD file, 2025-02-10]
Cheburashka_construction/korpus/резать и печатать/магнит_стойка.stl
30.0 x 50.0 x 30.0
