Ejenie/Cheburashka/Cheburashka_construction/platform/print/стенд.stl

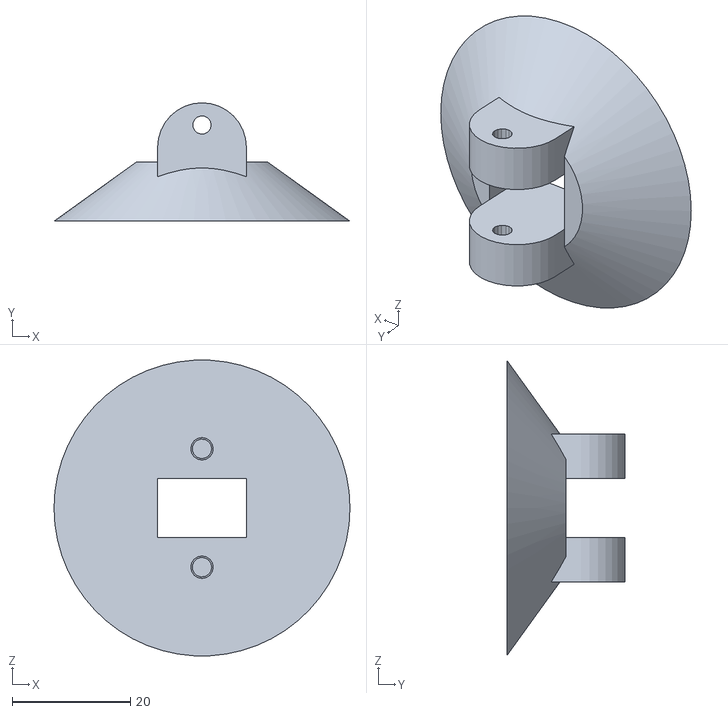
[picture p202: CAD file, 2024-12-30]
Cheburashka_construction/platform/print/стенд.stl
50.0 x 20.0 x 49.9
