Ejenie/Cheburashka/Cheburashka_construction/korpus/резать и печатать/лицо.dxf

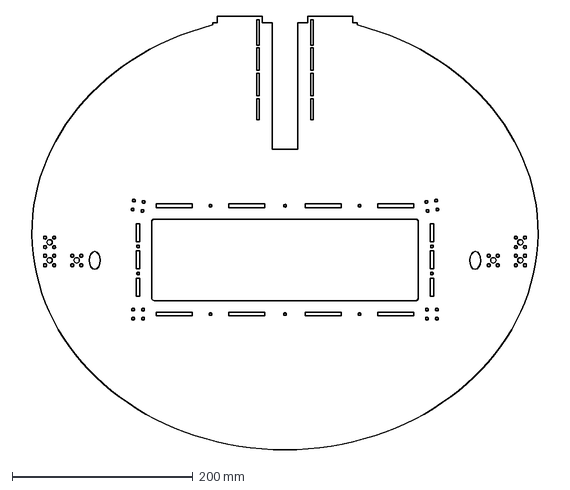
[picture p203: CAD file, 2025-02-10]
Cheburashka_construction/korpus/резать и печатать/лицо.dxf
594.3 x 479.6 mm
