Ejenie/Cheburashka/Cheburashka_construction/platform/legs/шестерня36_v2.stp

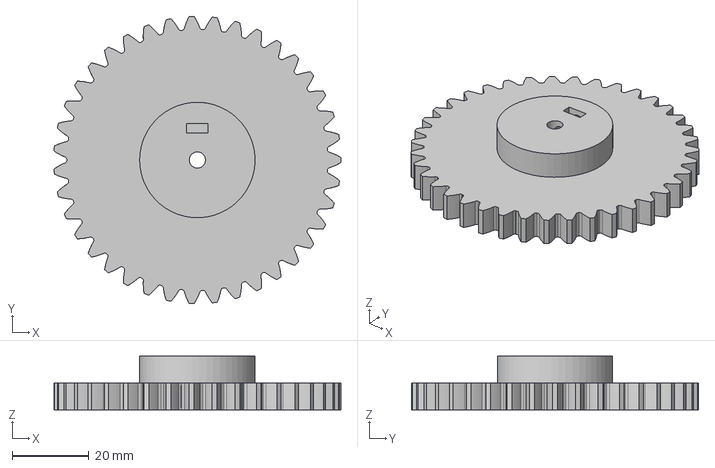
[picture p204: CAD file, 2025-08-20]
Cheburashka_construction/platform/legs/шестерня36_v2.stp
74.6 x 74.6 x 14.0 mm
