Ejenie/Cheburashka/Cheburashka_construction/korpus/arduino-mega-2650-1.snapshot.2/arduino MEGA2650/mf-msmf050-2.SLDPRT

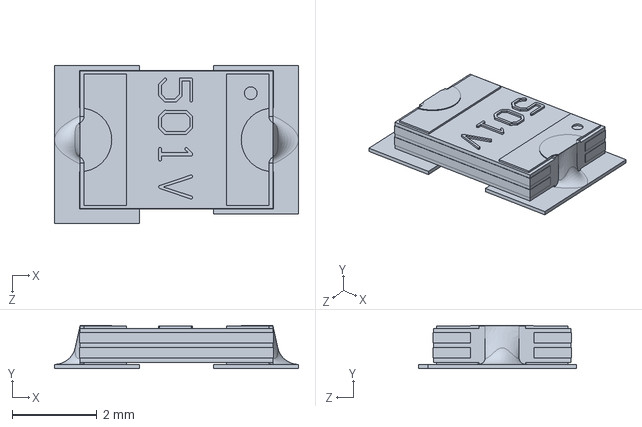
[picture p205: CAD file, 2025-01-25]
Cheburashka_construction/korpus/arduino-mega-2650-1.snapshot.2/arduino MEGA2650/mf-msmf050-2.SLDPRT
5.75 x 1.02 x 3.72 mm
