Ejenie/Cheburashka/Cheburashka_construction/korpus/резать и печатать/Prostavka.stl

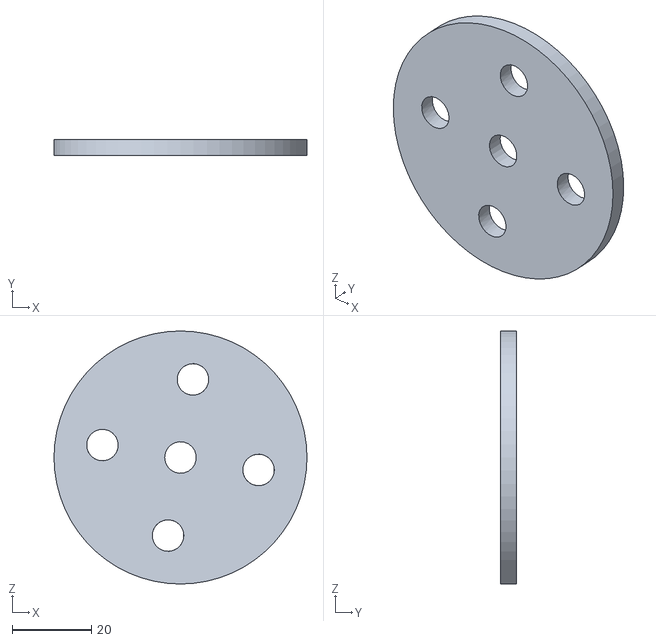
[picture p207: CAD file, 2025-02-10]
Cheburashka_construction/korpus/резать и печатать/Prostavka.stl
64.0 x 4.00 x 64.0
