Ejenie/Cheburashka/Cheburashka_construction/platform/legs/myMotorHolder_MIR.stl

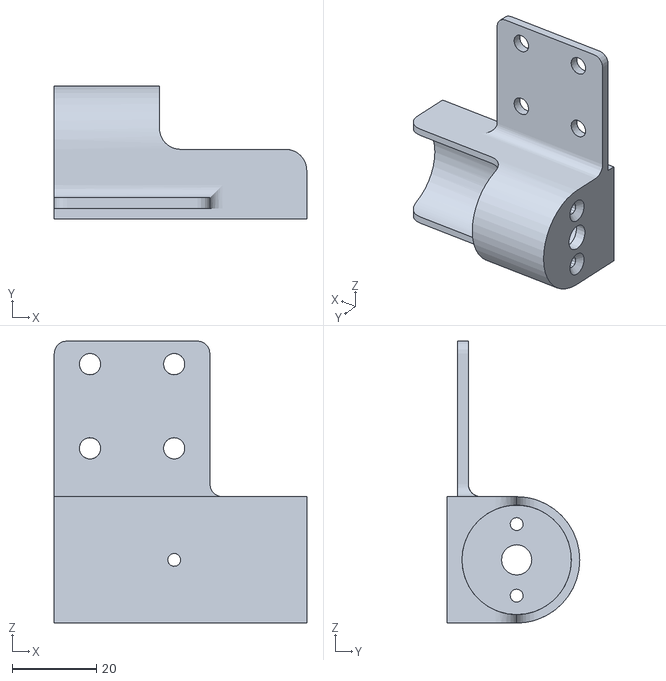
[picture p208: CAD file, 2025-08-20]
Cheburashka_construction/platform/legs/myMotorHolder_MIR.stl
60.0 x 31.5 x 67.0
