Ejenie/Cheburashka/Cheburashka_construction/platform/print/кривошип1.stp

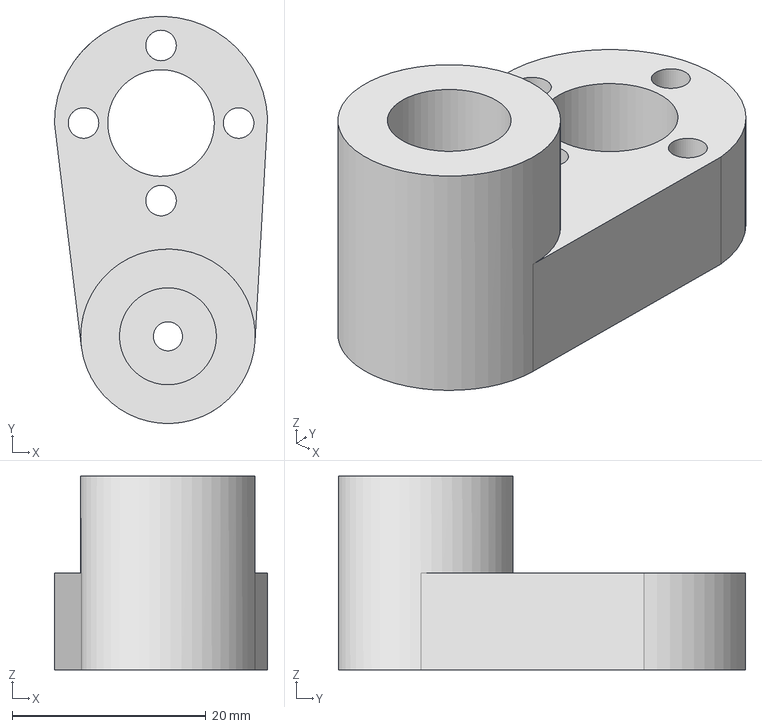
[picture p209: CAD file, 2024-12-27]
Cheburashka_construction/platform/print/кривошип1.stp
22.0 x 42.0 x 20.0 mm
