Ejenie/Cheburashka/Cheburashka_construction/korpus/arduino-mega-2650-1.snapshot.2/arduino MEGA2650/atmega16u2.SLDPRT

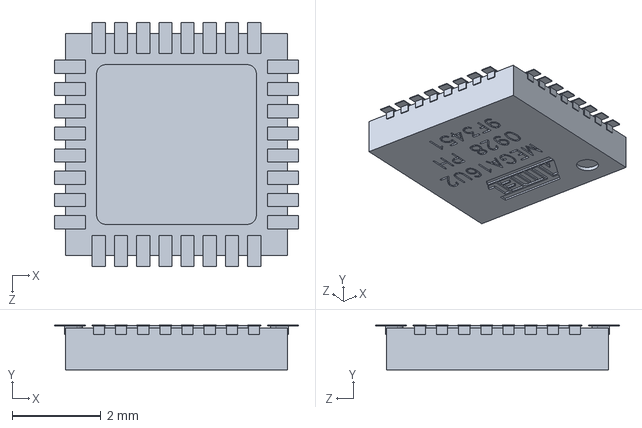
[picture p210: CAD file, 2025-01-25]
Cheburashka_construction/korpus/arduino-mega-2650-1.snapshot.2/arduino MEGA2650/atmega16u2.SLDPRT
5.50 x 1.01 x 5.50 mm
