Ejenie/Cheburashka/(list of files, cad)

Other CAD files:
Cheburashka_construction/face/Templates/English/ANSI (in).dwg
Cheburashka_construction/face/Templates/Metric/JIS.dwg
Cheburashka_construction/face/Templates/Standard.dwg
Cheburashka_construction/platform/print/myMotorHolder_MIR.stp
Cheburashka_construction/face/Templates/Metric/ISO.dwg
Cheburashka_construction/face/Templates/Metric/GB.dwg
Cheburashka_construction/platform/legs/myMotorHolder_MIR1.stp
Cheburashka_construction/face/Templates/Metric/DIN.dwg
Cheburashka_construction/face/Templates/Metric/GOST.dwg
Cheburashka_construction/korpus/шест2.stl
Cheburashka_construction/face/Templates/Metric/ANSI (mm).dwg
Cheburashka_construction/face/Templates/Metric/BSI.dwg
Cheburashka_construction/platform/legs/myMotorHolder.stl
Cheburashka_construction/platform/legs/шестерня36_туу.stl
Cheburashka_construction/platform/print/camera_front_box_v003.stl
Cheburashka_construction/korpus/arduino-mega-2650-1.snapshot.2/arduino MEGA2650/220 RESISTOR PACK.SLDPRT
Cheburashka_construction/platform/print/camera_back_cover_v002.stl
Cheburashka_construction/korpus/резать и печатать/парус1.stl
Cheburashka/cheb/Cheb. korp.iam
Cheburashka_construction/OldVersions/general.0086.iam
Cheburashka_construction/face/Design Data/AIT/Mold Design/mold design stop pin.ipt
Cheburashka_construction/face/Design Data/Cable & Harness/ru-RU/harness.iam
Cheburashka_construction/face/Design Data/Tube & Pipe/ru-RU/piping runs.iam
Cheburashka_construction/face/OldVersions/рамки.0002.ipt
Cheburashka_construction/face/Templates/English/ANSI (in).idw
Cheburashka_construction/face/Templates/English/Mold Design (in).iam
Cheburashka_construction/face/Templates/English/Sheet Metal (in).ipt
Cheburashka_construction/face/Templates/English/Standard (in).iam
Cheburashka_construction/face/Templates/English/Standard (in).ipn
Cheburashka_construction/face/Templates/English/Standard (in).ipt
Cheburashka_construction/face/Templates/English/Weldment (ANSI).iam
Cheburashka_construction/face/Templates/Metric/ANSI (mm).idw
Cheburashka_construction/face/Templates/Metric/BSI.idw
Cheburashka_construction/face/Templates/Metric/DIN.idw
Cheburashka_construction/face/Templates/Metric/GB.idw
Cheburashka_construction/face/Templates/Metric/GOST.idw
Cheburashka_construction/face/Templates/Metric/ISO.idw
Cheburashka_construction/face/Templates/Metric/JIS.idw
Cheburashka_construction/face/Templates/Metric/Mold Design (DIN).iam
Cheburashka_construction/face/Templates/Metric/Mold Design (mm).iam
Cheburashka_construction/face/Templates/Metric/Sheet Metal (DIN).ipt
Cheburashka_construction/face/Templates/Metric/Sheet Metal (mm).ipt
Cheburashka_construction/face/Templates/Metric/Standard (DIN).iam
Cheburashka_construction/face/Templates/Metric/Standard (DIN).ipn
Cheburashka_construction/face/Templates/Metric/Standard (DIN).ipt
Cheburashka_construction/face/Templates/Metric/Standard (mm).iam
Cheburashka_construction/face/Templates/Metric/Standard (mm).ipn
Cheburashka_construction/face/Templates/Metric/Standard (mm).ipt
Cheburashka_construction/face/Templates/Metric/Weldment (ANSI - mm).iam
Cheburashka_construction/face/Templates/Metric/Weldment (BSI).iam
Cheburashka_construction/face/Templates/Metric/Weldment (DIN).iam
Cheburashka_construction/face/Templates/Metric/Weldment (GB).iam
Cheburashka_construction/face/Templates/Metric/Weldment (ISO).iam
Cheburashka_construction/face/Templates/Metric/Weldment (JIS).iam
Cheburashka_construction/face/Templates/Mold Design/Mold Design.iam
Cheburashka_construction/face/Templates/Sheet Metal.ipt
Cheburashka_construction/face/Templates/Standard.iam
Cheburashka_construction/face/Templates/Standard.idw
Cheburashka_construction/face/Templates/Standard.ipn
Cheburashka_construction/face/Templates/Standard.ipt
Cheburashka_construction/face/acc1.ipt
Cheburashka_construction/face/Сборка1.iam
Cheburashka_construction/face/лицо/OldVersions/Деталь1.0001.ipt
Cheburashka_construction/face/лицо/OldVersions/Сборка1.0034.iam
Cheburashka_construction/face/лицо/OldVersions/Сборка2.0004.iam
Cheburashka_construction/face/лицо/OldVersions/креп_подш.0006.ipt
Cheburashka_construction/face/лицо/OldVersions/креп_сервы.0002.ipt
Cheburashka_construction/face/лицо/OldVersions/лицо1.0015.ipt
Cheburashka_construction/face/лицо/OldVersions/магнит_стойка.0002.ipt
Cheburashka_construction/face/лицо/OldVersions/мини_подшипник.0002.ipt
Cheburashka_construction/face/лицо/OldVersions/монитор.0001.ipt
Cheburashka_construction/face/лицо/OldVersions/основа_лица.0014.ipt
Cheburashka_construction/face/лицо/OldVersions/парус1.0004.ipt
Cheburashka_construction/face/лицо/OldVersions/стенкаB.0002.ipt
Cheburashka_construction/face/лицо/Pitsco Education-739086.iam
Cheburashka_construction/face/лицо/Pitsco Education-739086.ipt
Cheburashka_construction/face/лицо/Деталь1.ipt
Cheburashka_construction/face/лицо/Сборка1.iam
Cheburashka_construction/face/лицо/Сборка2.iam
Cheburashka_construction/face/лицо/креп_подш.ipt
Cheburashka_construction/face/лицо/креп_сервы.ipt
Cheburashka_construction/face/лицо/креп_сервы.stl
Cheburashka_construction/face/лицо/лицо1.ipt
Cheburashka_construction/face/лицо/магнит_стойка.ipt
Cheburashka_construction/face/лицо/мини_подшипник.ipt
Cheburashka_construction/face/лицо/монитор.ipt
Cheburashka_construction/face/лицо/основа_лица.ipt
Cheburashka_construction/face/лицо/ось_мини_подшипника.ipt
Cheburashka_construction/face/лицо/парус1.ipt
Cheburashka_construction/face/лицо/парус2.ipt
Cheburashka_construction/face/лицо/подшипник.ipt
Cheburashka_construction/face/лицо/стенкаB.ipt
Cheburashka_construction/face/лицо1.ipt
Cheburashka_construction/face/магнит_стойка.ipt
Cheburashka_construction/face/монитор.ipt
Cheburashka_construction/face/основа_лица.ipt
Cheburashka_construction/face/парус1.ipt
Cheburashka_construction/face/парус2.ipt
Cheburashka_construction/face/рамки.ipt
Cheburashka_construction/face/рамки_верх.ipt
Cheburashka_construction/face/рамки_левое.ipt
Cheburashka_construction/face/стенка.ipt
Cheburashka_construction/face/стенкаB.ipt
Cheburashka_construction/general.iam
Cheburashka_construction/korpus/OldVersions/Prostavka.0012.ipt
Cheburashka_construction/korpus/OldVersions/korp.0108.iam
Cheburashka_construction/korpus/OldVersions/turn.0012.iam
Cheburashka_construction/korpus/OldVersions/Деталь2.0002.ipt
Cheburashka_construction/korpus/OldVersions/верхний эллипс туловища.0019.ipt
Cheburashka_construction/korpus/OldVersions/грань тела.0030.ipt
Cheburashka_construction/korpus/OldVersions/держатель.0007.ipt
Cheburashka_construction/korpus/OldVersions/креп.0010.ipt
Cheburashka_construction/korpus/OldVersions/крепление_кракаса.0004.ipt
Cheburashka_construction/korpus/OldVersions/кроватка.0002.ipt
Cheburashka_construction/korpus/OldVersions/нижний эллипс головы.0008.ipt
Cheburashka_construction/korpus/OldVersions/нижний эллипс тела.0006.ipt
Cheburashka_construction/korpus/OldVersions/нижний эллипс тела.0023.ipt
Cheburashka_construction/korpus/OldVersions/ограничитель.0004.ipt
Cheburashka_construction/korpus/OldVersions/палка.0004.ipt
Cheburashka_construction/korpus/OldVersions/палка_MIR.0002.ipt
Cheburashka_construction/korpus/OldVersions/парус2.0003.ipt
Cheburashka_construction/korpus/OldVersions/подш_гл.0001.ipt
Cheburashka_construction/korpus/OldVersions/ребро.0029.ipt
Cheburashka_construction/korpus/OldVersions/ребро0.5.0016.ipt
Cheburashka_construction/korpus/OldVersions/ребро0.5_MIR3.0004.ipt
Cheburashka_construction/korpus/OldVersions/ребро_MIR.0010.ipt
Cheburashka_construction/korpus/OldVersions/стабилизатор.0001.ipt
Cheburashka_construction/korpus/OldVersions/стакан.0001.ipt
Cheburashka_construction/korpus/OldVersions/трубка.0002.ipt
Cheburashka_construction/korpus/OldVersions/фанера.0008.ipt
Cheburashka_construction/korpus/OldVersions/цил1.0006.ipt
Cheburashka_construction/korpus/OldVersions/шест1.0002.ipt
Cheburashka_construction/korpus/Pitsco Education-739028.ipt
Cheburashka_construction/korpus/Pitsco Education-739085.ipt
Cheburashka_construction/korpus/Prostavka.ipt
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
