Ejenie/Cheburashka/Cheburashka_construction/platform/Raspberry Pi Camera Stand - 274111/README.txt

Raspberry Pi Camera Stand by atleberg on Thingiverse: https://www.thingiverse.com/thing:274111
