Ejenie/Cheburashka/Cheburashka_construction/face/лицо/картинки/акум.png

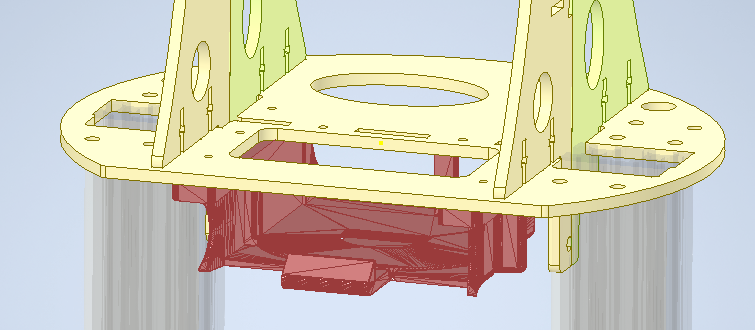
Cheburashka_construction/face/лицо/картинки/акум.png
