Ejenie/Cheburashka/Cheburashka_construction/face/лицо/картинки/клин.png

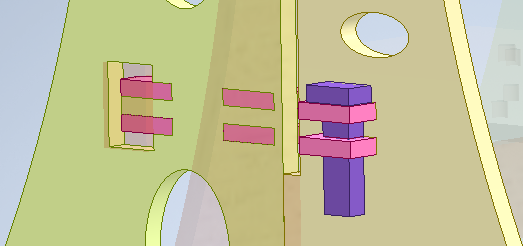
Cheburashka_construction/face/лицо/картинки/клин.png
