Ejenie/Cheburashka/Cheburashka_construction/face/лицо/картинки/направляющие.png

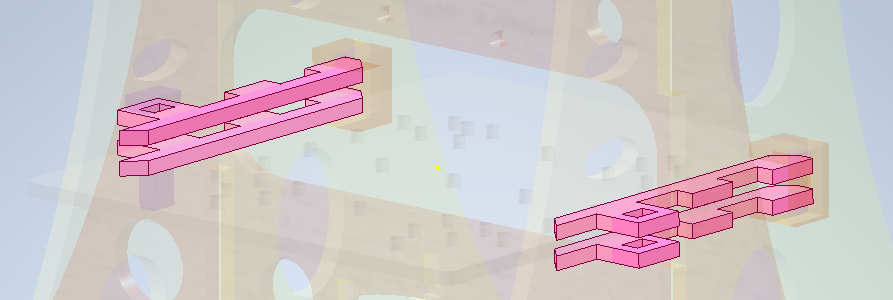
Cheburashka_construction/face/лицо/картинки/направляющие.png
