Ejenie/Cheburashka/Cheburashka_construction/face/лицо/картинки/ограничители.png

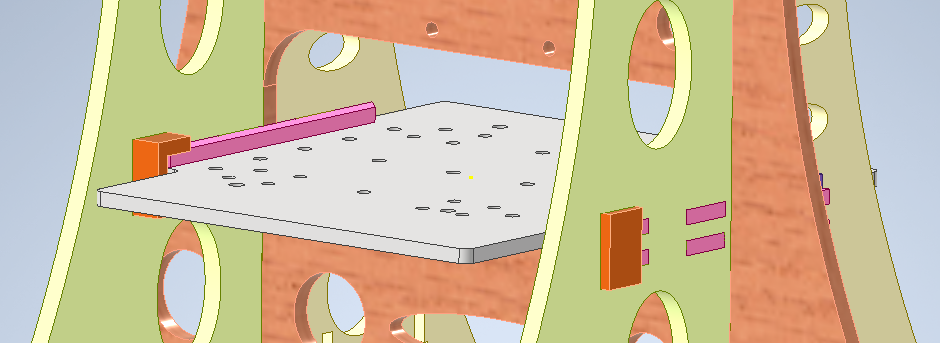
Cheburashka_construction/face/лицо/картинки/ограничители.png
