Ejenie/Cheburashka/Cheburashka_construction/face/лицо/картинки/полка.png

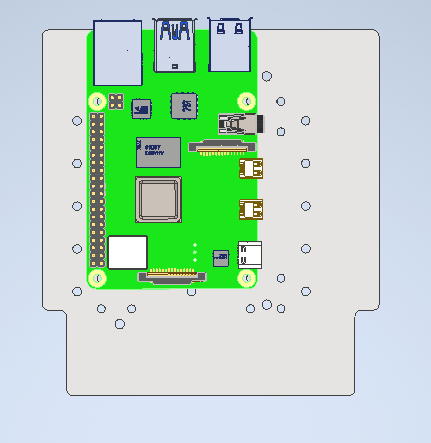
Cheburashka_construction/face/лицо/картинки/полка.png
