Ejenie/Cheburashka/Cheburashka_construction/face/лицо/картинки/сборка.png

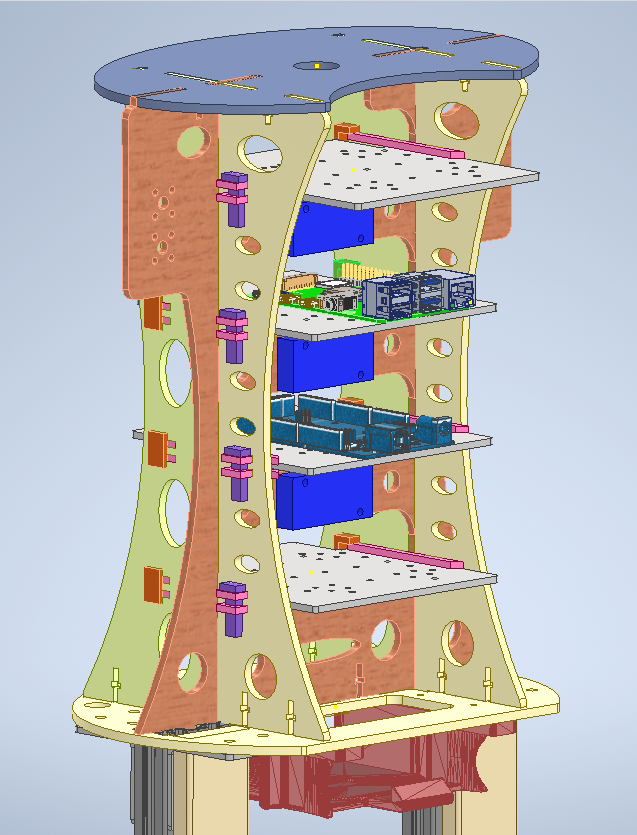
Cheburashka_construction/face/лицо/картинки/сборка.png
