Ejenie/Cheburashka/Cheburashka_construction/face/лицо/картинки/соед полки.png

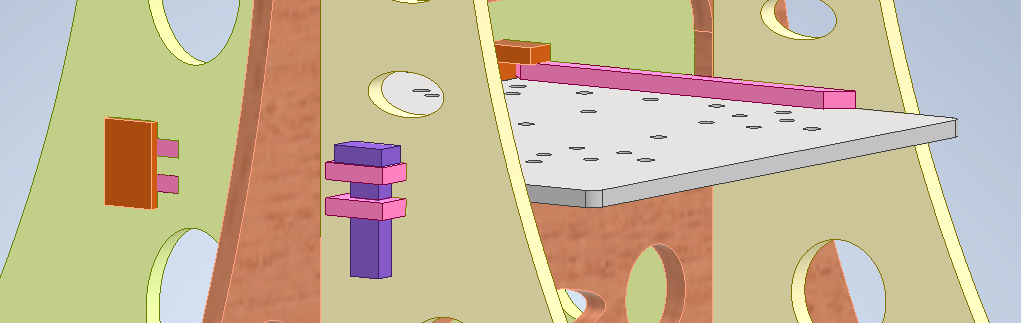
Cheburashka_construction/face/лицо/картинки/соед полки.png
