Ejenie/Cheburashka/Cheburashka_construction/face/лицо/картинки/шип-паз.png

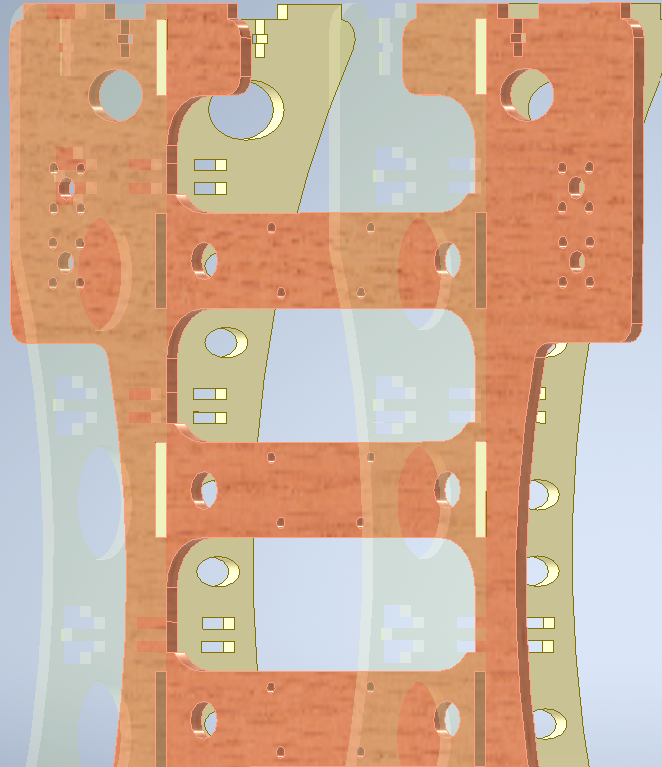
Cheburashka_construction/face/лицо/картинки/шип-паз.png
