Ejenie/Cheburashka/Cheburashka_electronix/плата/PCB_Project_1/Травление/Фотошаблон.PDF

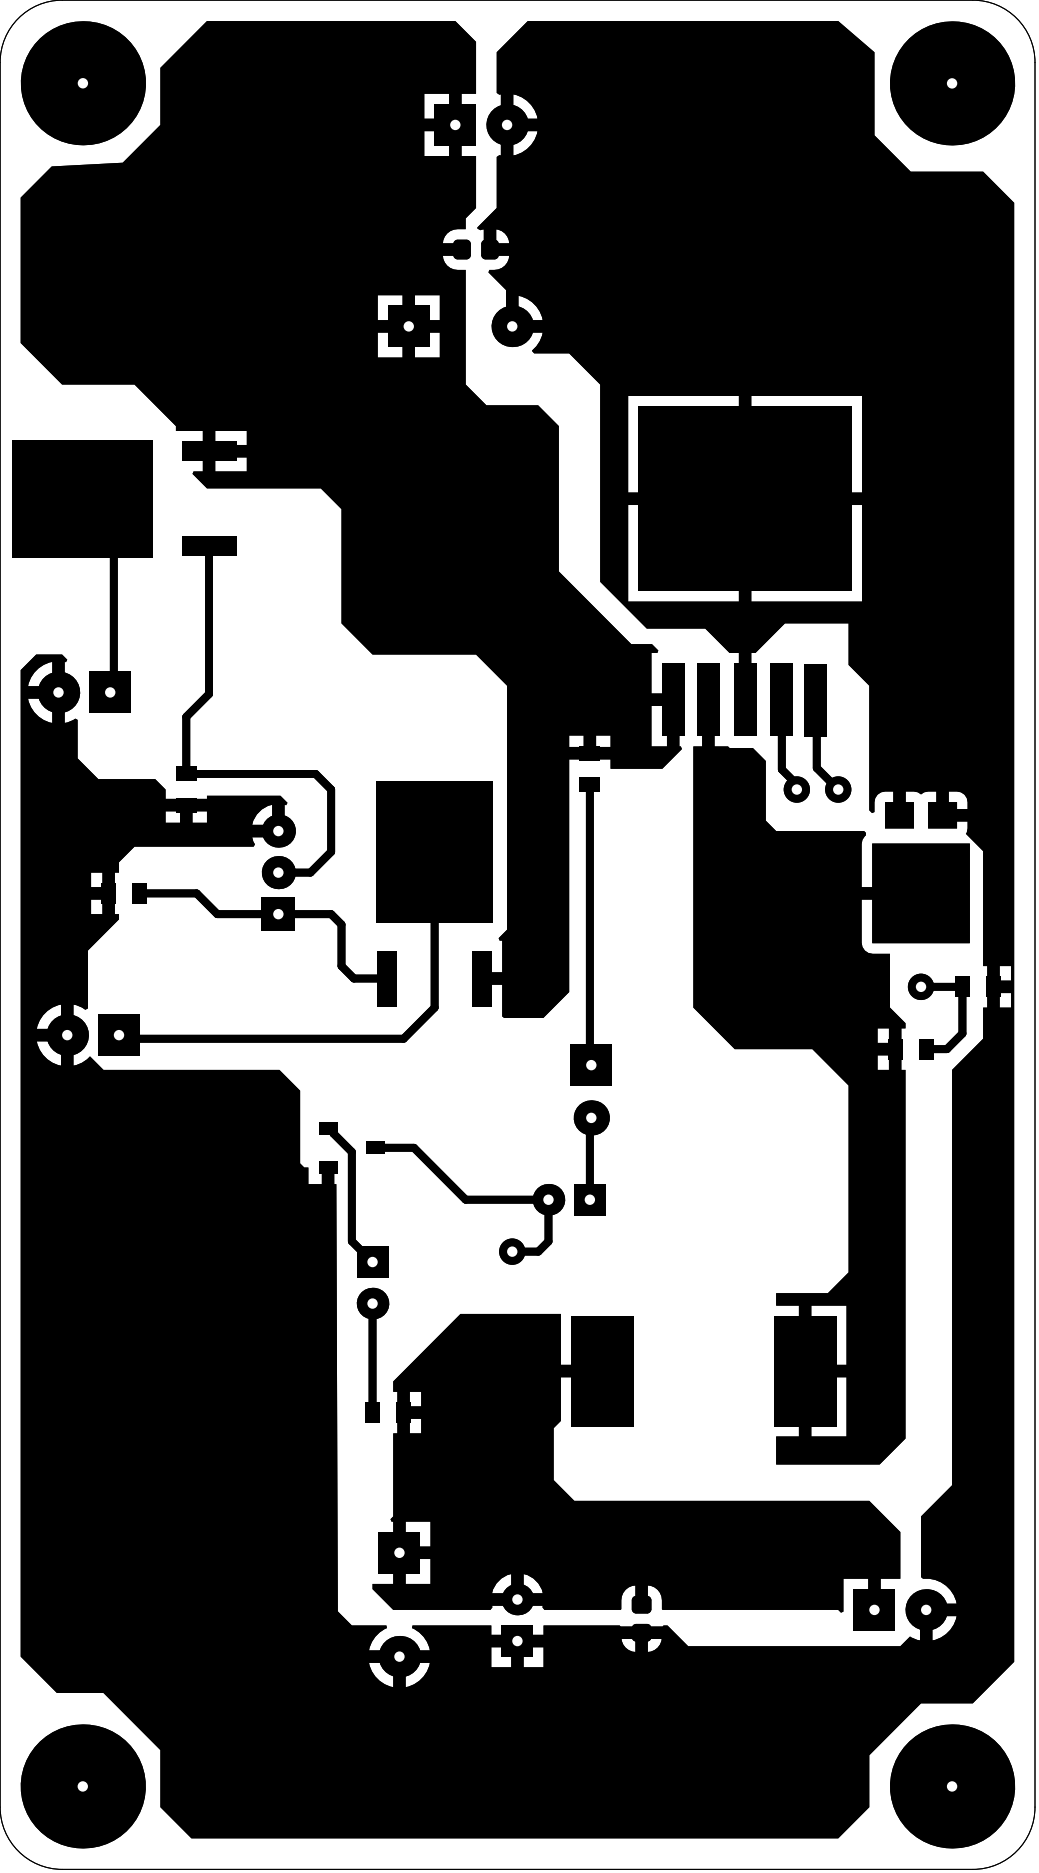
[picture p229: page 1]

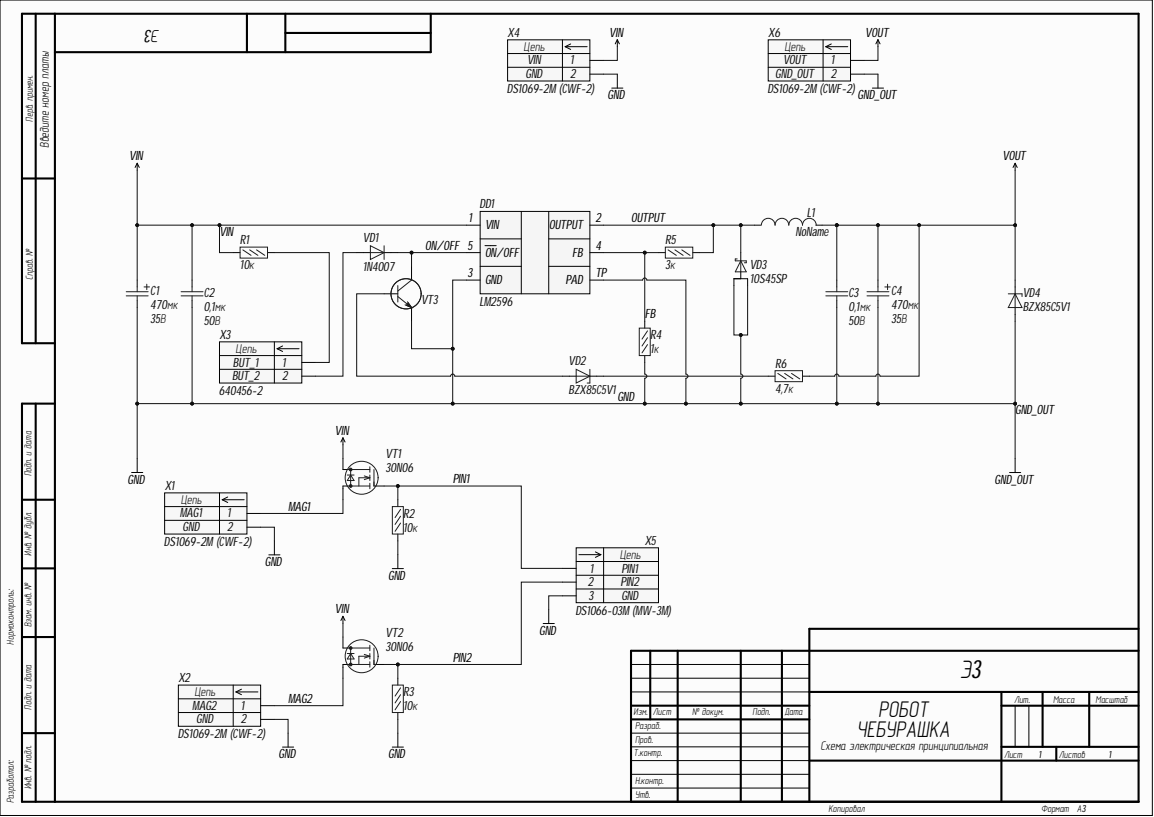
[picture p230: page 2]

Подп. и дата Перв. примен. Справ. №

Цепь
BUT_1 | 1
BUT_2 | 2

MAG1 | 1
GND | 2

Инв. № подл. Инв. № дубл. Подп. и дата Взам. инв. №

1 | PIN1
2 | PIN2
3 | GND

MAG2 | 1

РОБОТ ЧЕБУРАШКА Схема электрическая принципиальная | Лит. | Масса | Масштаб

Изм. | Лист | № докум. | Подп. | Дата
Разраб.

Н.контр.
Утв.

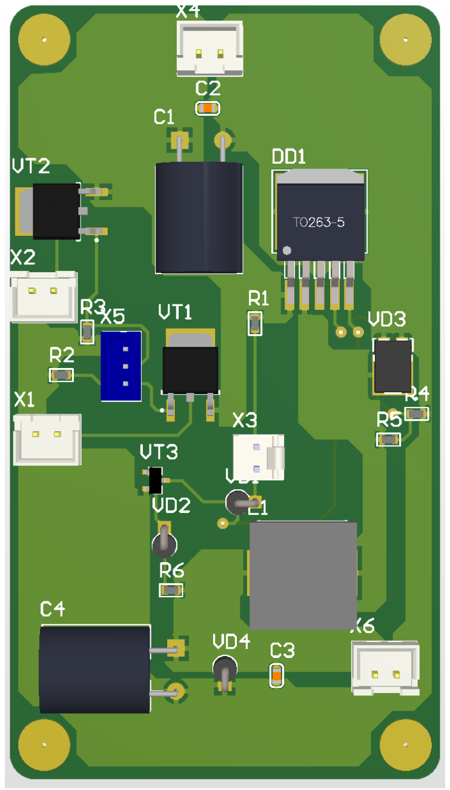
[picture p231: page 3]
