Ejenie/Cheburashka/Cheburashka_electronix/Э1_робот/Чебурашка_Схема.pdf

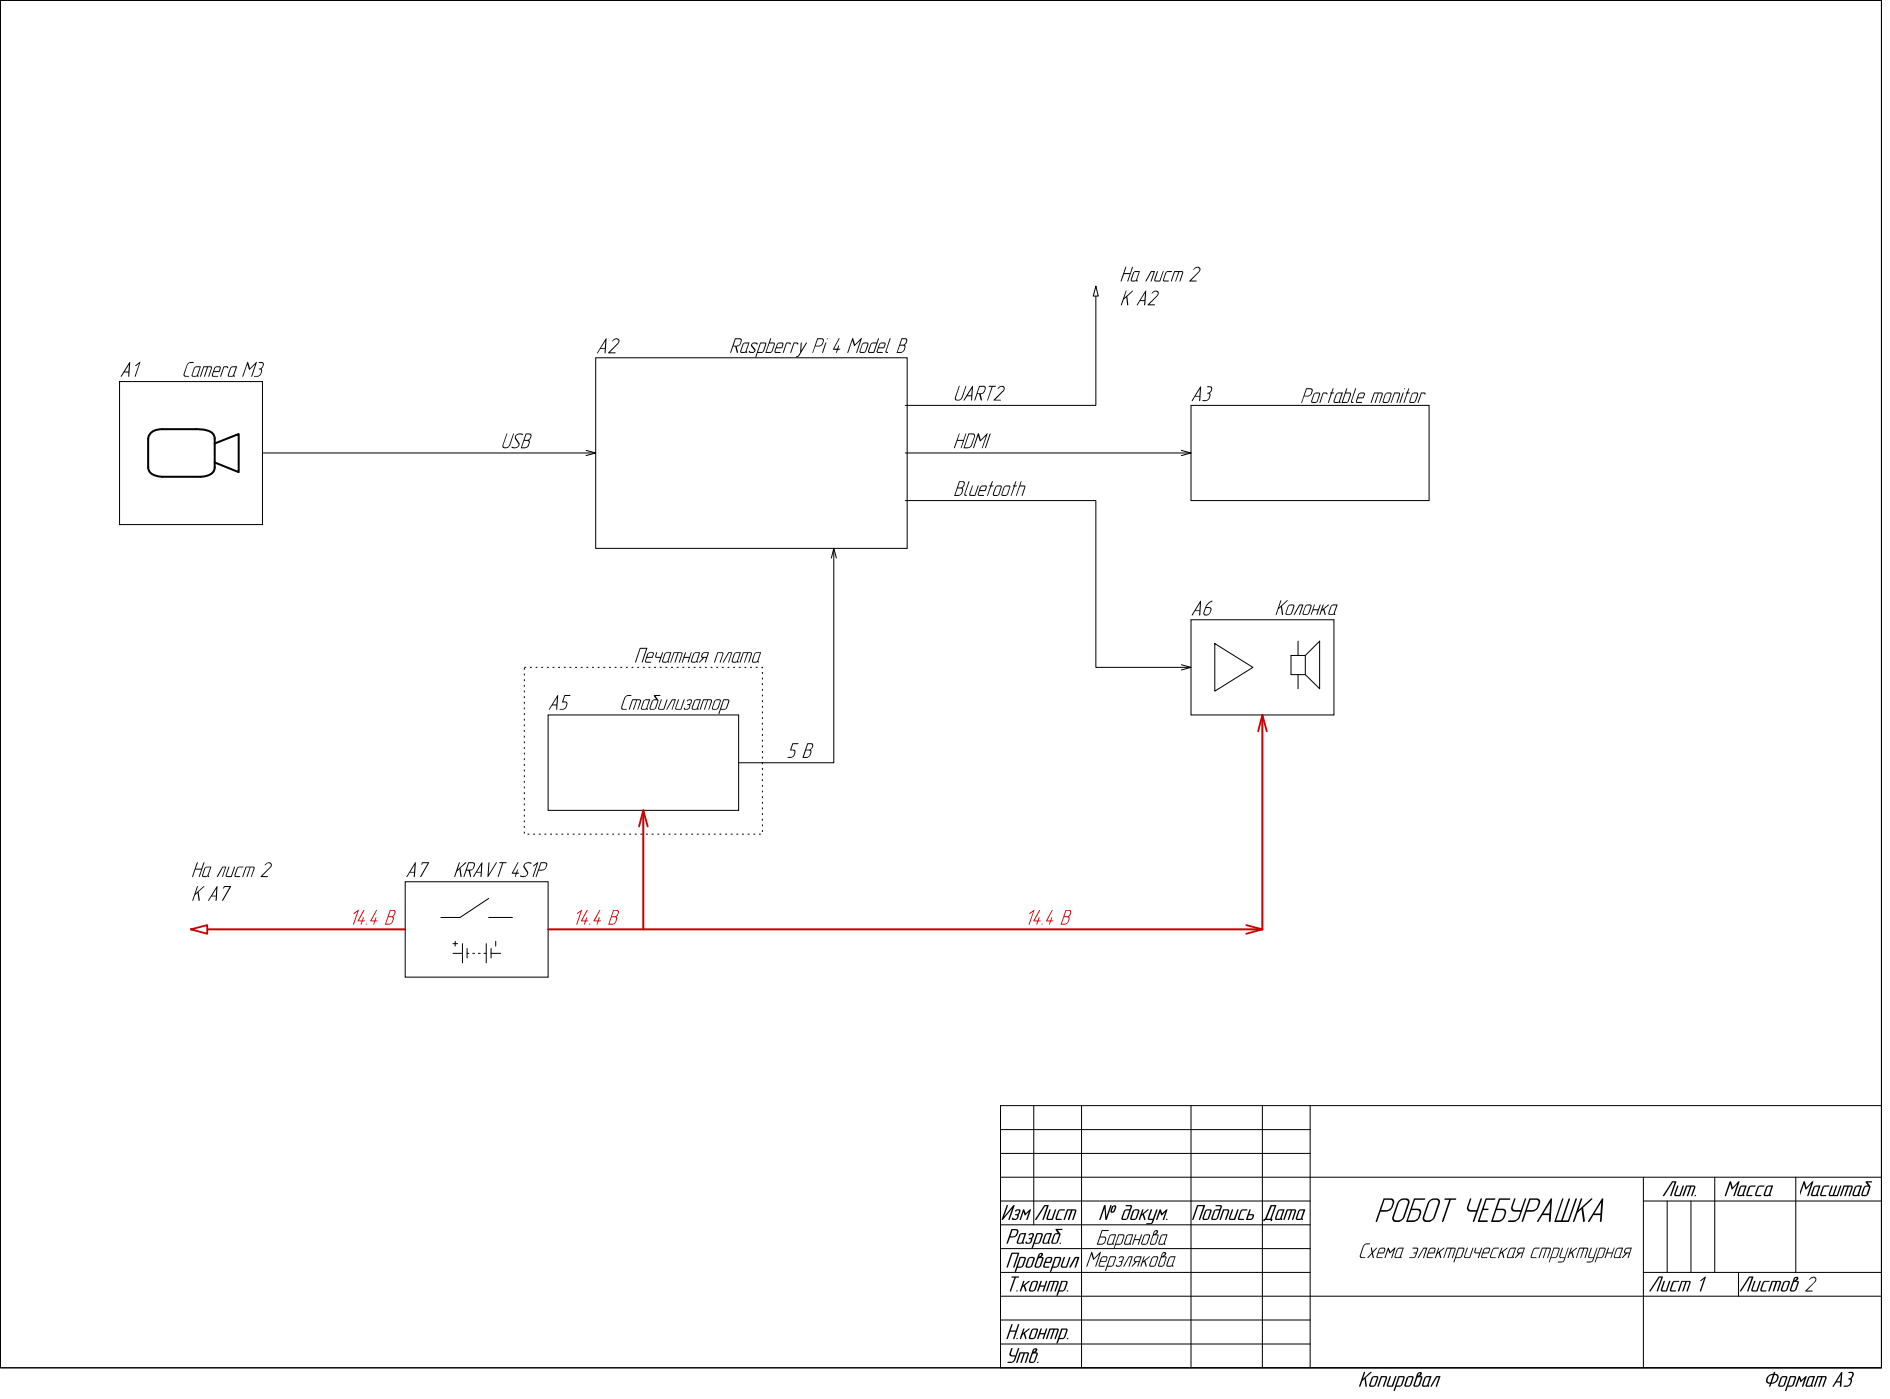
[picture p232: page 1]
