Ejenie/Cheburashka/Cheburashka_electronix/Э1_робот/Чебурашка_Схема_2.pdf

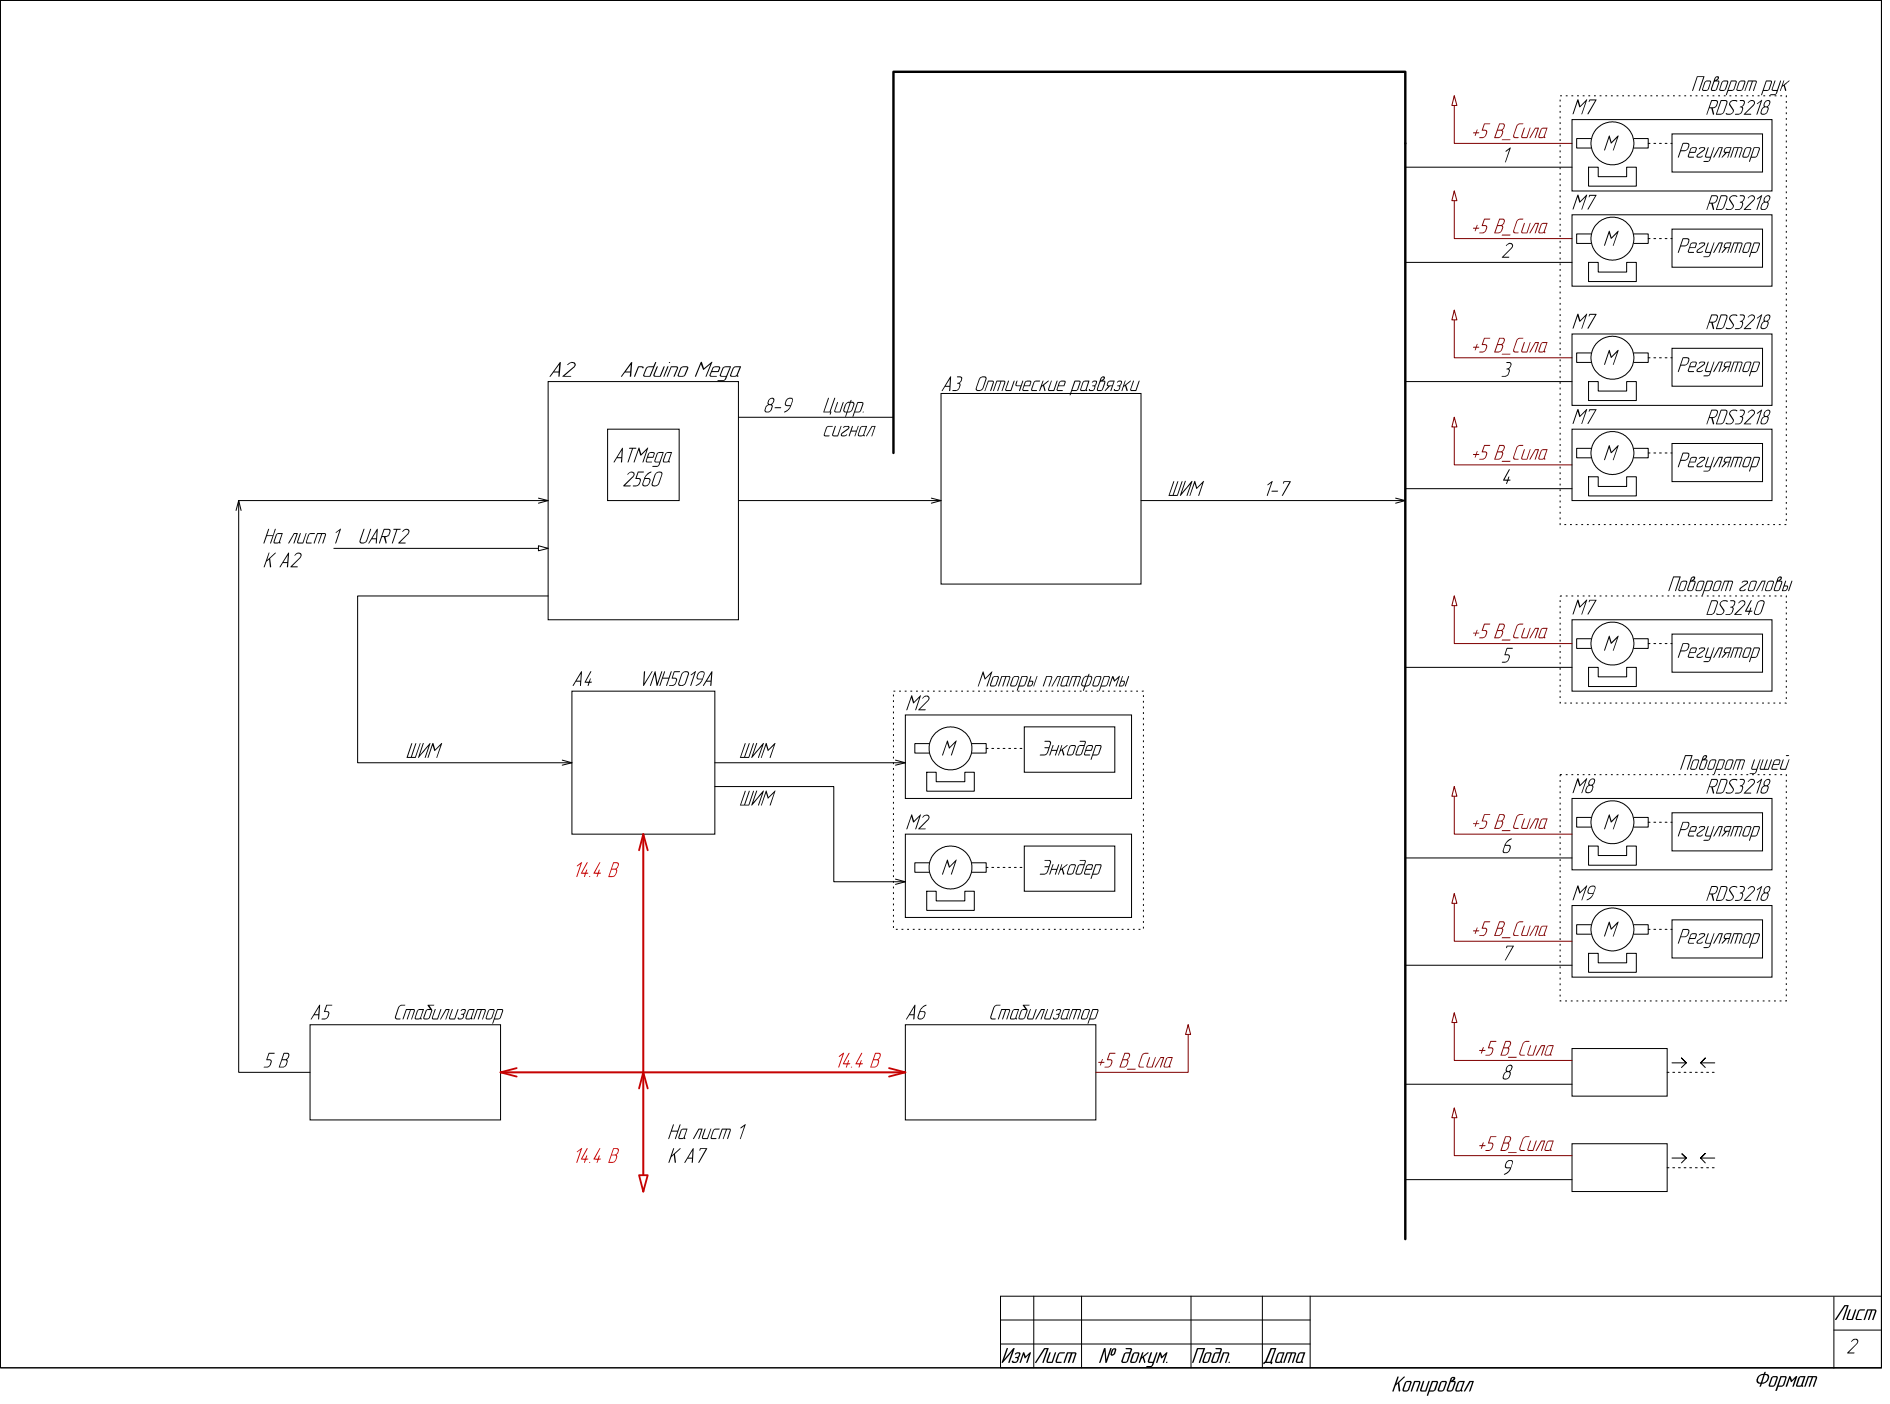
[picture p233: page 1]
