Ejenie/Cheburashka/Cheburashka_electronix/плата/PCB_Project_1/фотошаблон.pdf

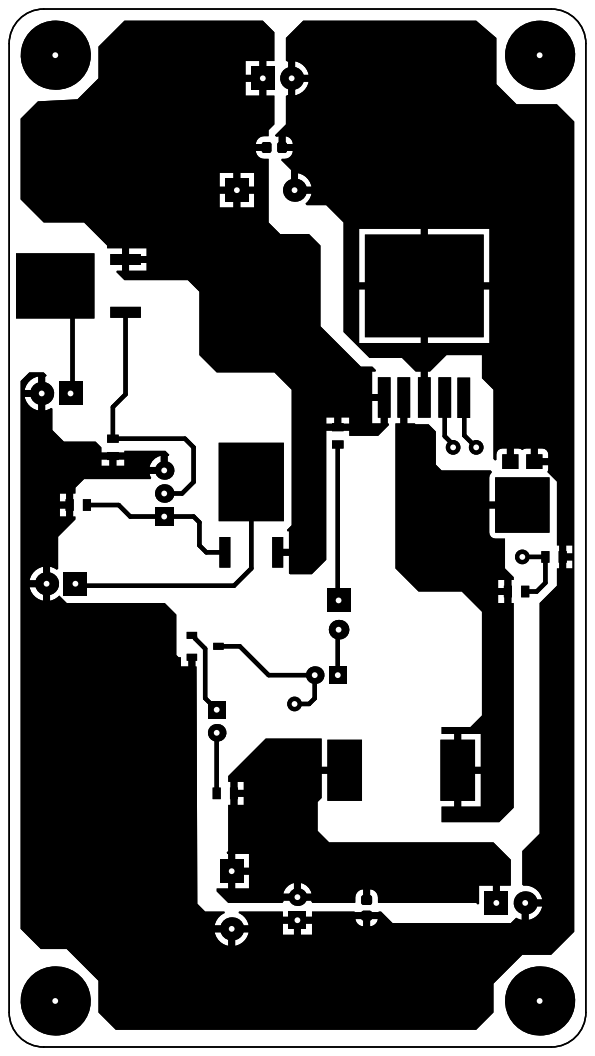
[picture p234: page 1]
