Ejenie/Cheburashka/(list of files, drawings)

Other design files:
Cheburashka_electronix/плата/PCB_Project_1/1mm_18um_2layers_std.PcbDoc
Cheburashka_electronix/плата/PCB_Project_1/PCB_Project_1.PrjPcb
Cheburashka_electronix/плата/PCB_Project_1/Sheet1.SchDoc
Cheburashka_electronix/плата/схемы/Backup_of_Э3.spl8
Cheburashka_electronix/плата/схемы/Backup_of_Э3_.spl8
Cheburashka_electronix/плата/схемы/Э3_.spl8
Cheburashka_electronix/Э1_робот/Backup_of_Э1.spl8
Cheburashka_electronix/Э1_робот/Э1.spl8
