Ejenie/Cheburashka/Cheburashka_firmware/Arduino/programmOnStageSuperTeam/programmOnStageSuperTeam.ino

#include "condition.h"

void setup() {    //init
  _initSerials();
  //_initEnc();
  _initMotors();
  _initServo();
  //_initMPU();
  _initMag();
  //_initDisplay();

  forwardEnc(1);
  /* stopm(8000);
    conditionBegin();//*/
  uint32_t timer = millis();
}

void loop() {   //finite state machine
  /*conditionUpdate();
  switch (condition) {
    case 0:
      defaultCond();
      break;
    case 1:    
      pinkCond();
      break;
    case 2:
      ratCond();
      break;
    case 3:    
      orangeCond();
      break;
    case 4:
      greenCond();
    default: break;
  }//*/
}
