Ejenie/Cheburashka/(commit log)

2024-10-28 Создал папки для хранения файлов конструкции роботов
2024-10-30 Первая версия платформы
    [36466_txm-4 inch omni wheel.0003.ipt, 36466_txm-4 inch omni wheel.ipt, 36466_txm-4 inch omni wheel_MIR.ipt, 36466_txm-4 inch omni wheel_MIR1.ipt, 36466_txm-4 inch omni wheel_MIR2.ipt, 39055_txm-4 inch wheel.0002.ipt, 39055_txm-4 inch wheel.ipt, 39055_txm-4 inch wheel_MIR.ipt]
2024-11-07 Добавляю каркас
    [224HX-Konstruktsionnyy-profil-20kh20H.iam, 36466_txm-4 inch omni wheel.0003.ipt, 36466_txm-4 inch omni wheel.ipt, 36466_txm-4 inch omni wheel_MIR.ipt, 36466_txm-4 inch omni wheel_MIR1.ipt, 36466_txm-4 inch omni wheel_MIR2.ipt, 39055_txm-4 inch wheel.0002.ipt, 39055_txm-4 inch wheel.ipt]
2024-11-12 Продолжаем работу
    [Cheb. korp.0009.iam, Cheb. korp.0011.iam, Cheb. korp.iam, image.0002.ipt, image.0003.ipt, image.ipt]
2024-12-03 Какая-то самодеятельность
    [Cheb. korp.0011.iam, Osn. platform.0009.ipt, Pitsco Education-739028.ipt, Pitsco Education-739085.ipt, Prostavka.ipt, Servo horn v2.3mf, Servo horn v2.f3d, Servo horn v2.step]
2024-12-17 Актуальная версия
    [ASX1_ImageToStl.com_de33b05f-b2d7-4424-b04b-15da999b358a.3mf, Cheb. korp.0037.iam, ImageToStl.com_de33b05f-b2d7-4424-b04b-15da999b358a.0001.ipt, ImageToStl.com_de33b05f-b2d7-4424-b04b-15da999b358a.ipt, ImageToStl.com_de33b05f-b2d7-4424-b04b-15da999b358a.stl, Osn. platform.0011.ipt, Osn. platform.ipt, Деталь5.ipt]
2024-12-19 Удалил папки доставщика и лариски. Репозиторий только под чебурашку
2024-12-19 Сделал структуру гита Чебурашки
    [224HX-Konstruktsionnyy-profil-20kh20H.iam, 36466_txm-4 inch omni wheel.ipt, 36466_txm-4 inch omni wheel_MIR.ipt, 36466_txm-4 inch omni wheel_MIR1.ipt, 36466_txm-4 inch omni wheel_MIR2.ipt, 39055_txm-4 inch wheel.ipt, 39055_txm-4 inch wheel_MIR.ipt, 39055_txm-4 inch wheel_MIR1.ipt]
2024-12-19 Изменил расположение файлов
    [224HX-Konstruktsionnyy-profil-20kh20H.iam, 36466_txm-4 inch omni wheel.ipt, 36466_txm-4 inch omni wheel_MIR.ipt, 36466_txm-4 inch omni wheel_MIR1.ipt, 36466_txm-4 inch omni wheel_MIR2.ipt, 39055_txm-4 inch wheel.ipt, 39055_txm-4 inch wheel_MIR.ipt, 39055_txm-4 inch wheel_MIR1.ipt]
2024-12-19 Новая версия с отдеьными сборками
    [224H Конструкционный профиль 20х40H_00.ipt, 224HX-Konstruktsionnyy-profil-20kh20H.iam, 36466_txm-4 inch omni wheel.ipt, 36466_txm-4 inch omni wheel_MIR.ipt, 36466_txm-4 inch omni wheel_MIR1.ipt, 36466_txm-4 inch omni wheel_MIR2.ipt, 39055_txm-4 inch wheel.ipt, 39055_txm-4 inch wheel_MIR.ipt]
2024-12-20 Актуальная версия платформы со всеми отверстиями, кроме крепления камеры
    [Osn. platform.0019.ipt, Osn. platform.ipt, akfytw2.0001.ipt, akfytw2.ipt, general.0004.iam, general.iam, korp.0002.iam, korp.iam]
2024-12-24 Новая версия
    [224H Конструкционный профиль 20х40H_00.0001.ipt, 224H Конструкционный профиль 20х40H_00.ipt, Osn. platform.0019.ipt, Osn. platform.0020.ipt, Osn. platform.ipt, general.0004.iam, general.0005.iam, general.iam]
2024-12-24 Платформа
    [platform.0012.iam, platform.0013.iam, platform.iam, wheel1_MIR.0001.ipt, wheel1_MIR.ipt]
2024-12-24 кривошип
    [кривошип.stp]
2024-12-27 Лучшая сборка
    [067a8e69ecd876a8a01cde7d0ae1fd89.STEP, 4ad8d019baf454c6bbd45c2c6ffb6783.STEP, 4ad8d019baf454c6bbd45c2c6ffb6783.ipt, 8bc17c1464c21f56fb2a3979b7c6b729.STEP, 8bc17c1464c21f56fb2a3979b7c6b729.ipt, 992432cf3e8df630382a1b492a64b2e5.STEP, 992432cf3e8df630382a1b492a64b2e5.ipt, L72-T_soedinitel-60kh80.STEP]
2025-01-05 Э1_2
    [Backup_of_Э1.spl8, Э1.spl8]
2025-01-13 +платформа+часть корпуса
    [KRAVT_holder_2 (1).ipt, KRAVT_holder_2 (1).stl, Osn. platform.0030.ipt, Osn. platform.0033.ipt, Osn. platform.ipt, Raspberry Pi 4 Model B.iam, arduino MEGA2650.iam, bobыshka.stl]
2025-01-17 Горе-модель
    [general.0010.iam, korp.0011.iam, platform.0038.iam, platform.0039.iam, platform.iam, грань тела.0010.ipt, грань тела.0011.ipt, грань тела.ipt]
2025-01-17 стелаж луиви тон
    [Raspberry Pi 4 Model B.iam, arduino MEGA2650.iam, грань тела.0011.ipt, грань тела.ipt, нижний эллипс тела.0011.ipt, нижний эллипс тела.ipt]
2025-01-21 Добавил новые файлы сборки чебурашки
    [Arduino_Mega_2560.stl, Raspberry_Pi_4_B.ipt, general.0014.iam, korp.0018.iam, грань тела.0013.ipt, нижний эллипс тела.0012.ipt, ребро.ipt, ребро_MIR.ipt]
2025-01-21 коммит
    [Backup_of_Э1.spl8, general.0014.iam, general.0016.iam, general.iam, korp.0018.iam, korp.0023.iam, korp.iam, Э1.spl8]
2025-01-25 Тело робота
    [10 PORT HEADER.0001.ipt, 10 PORT HEADER.SLDPRT, 10 PORT HEADER.ipt, 102 RESISTOR PACK.0001.ipt, 102 RESISTOR PACK.SLDPRT, 102 RESISTOR PACK.ipt, 103 RESISTOR PACK.0001.ipt, 103 RESISTOR PACK.SLDPRT]
2025-01-26 Сборка
    [грань тела.0021.ipt, грань тела.0024.ipt, грань тела.ipt, нижний эллипс тела.0019.ipt, нижний эллипс тела.0021.ipt, нижний эллипс тела.ipt, палка.0002.ipt, палка.0003.ipt]
2025-01-27 Добавил новые файлы
    [Camera.0001.ipt, Camera.ipt, Сыр_тэг.dxf, верхний эллипс туловища.0006.ipt, верхний эллипс туловища.0007.ipt, верхний эллипс туловища.ipt, грань тела.0027.ipt, грань тела.ipt]
2025-01-28 Залил файлы на гитхаб
    [acc1.ipt, acc1.stl, acc2.ipt, acc2.stl, грань тела.0025.ipt, грань тела.0027.ipt, грань тела.0028.ipt, грань тела.ipt]
2025-02-10 Полная сборка робота
    [ANSI (in).dwg, ANSI (in).idw, ANSI (mm).dwg, ANSI (mm).idw, BSI.dwg, BSI.idw, DIN.dwg, DIN.idw]
2025-03-12 Актуальная работа
    [Backup_of_Э1.spl8, general.0055.iam, general.0056.iam, general.iam, korp.0086.iam, korp.0087.iam, korp.iam, Сборка1.0014.iam]
2025-03-16 Базовое движение робота
    [Расчет.xlsx, Э3.spl8]
2025-03-27 Актуальная версия разработок
    [Backup_of_Э1.spl8, Backup_of_Э3.spl8, Backup_of_Э3_.spl8, Sheet1.SchDoc, general.0056.iam, general.0057.iam, general.iam, platform.0042.iam]
2025-05-14 On stage
2025-05-22 Новые программы
2025-05-22 Документация
2025-05-22 Акутальные схемы
    [Backup_of_Э1.spl8]
2025-05-26 Новая версия с дисплеем. Новые мордочик
2025-08-16 new version of development
    [36466_txm-4 inch omni wheel_MIR2.ipt, 8bc17c1464c21f56fb2a3979b7c6b729.0001.ipt, 8bc17c1464c21f56fb2a3979b7c6b729.ipt, 8bc17c1464c21f56fb2a3979b7c6b729_MIR.ipt, Backup_of_Э1.spl8, POLULU final.0001.ipt, POLULU final.ipt, POLULU final.stp]
2025-08-20 new version again
    [axis.0003.ipt, axis.0004.ipt, axis.ipt, general.0073.iam, general.0075.iam, general.iam, myBering.0005.ipt, myBering.0008.ipt]
2025-11-02 version - finist
    [Э1.spl8, держатель.0004.ipt, держатель.0005.ipt, держатель.ipt, держатель.stl]
2026-04-25 финальная версия
2026-10-02 actual schematics
